zcrawling/LOONARover/GCS/docs/images/gcs-requirements-overview.png

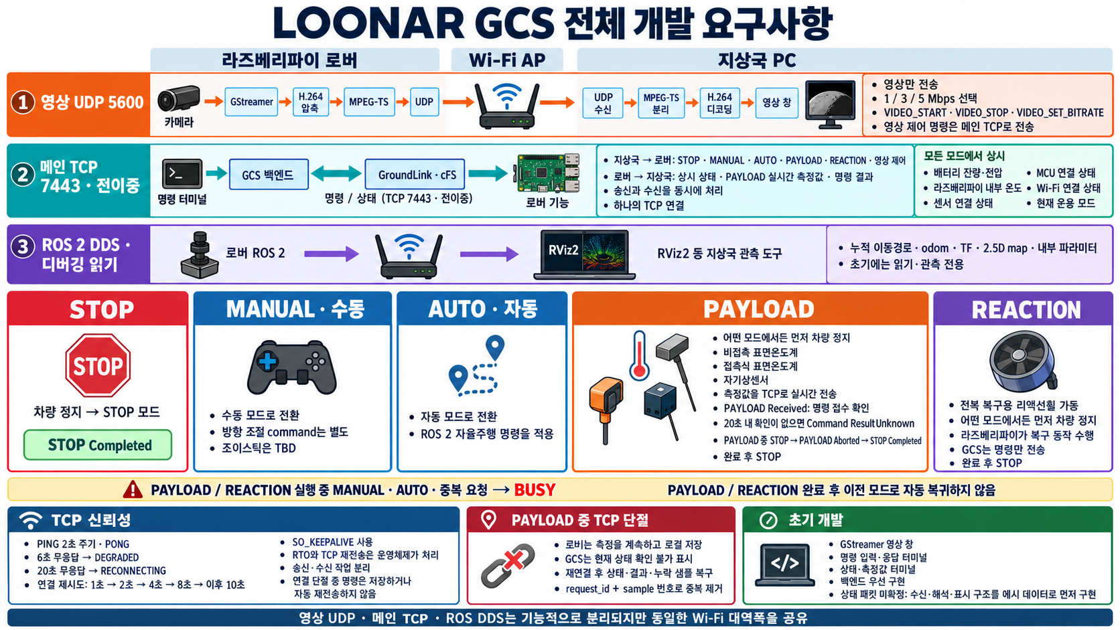
GCS/docs/images/gcs-requirements-overview.png
