zcrawling/LOONARover/GCS/docs/images/gcs-tcp-reliability.png

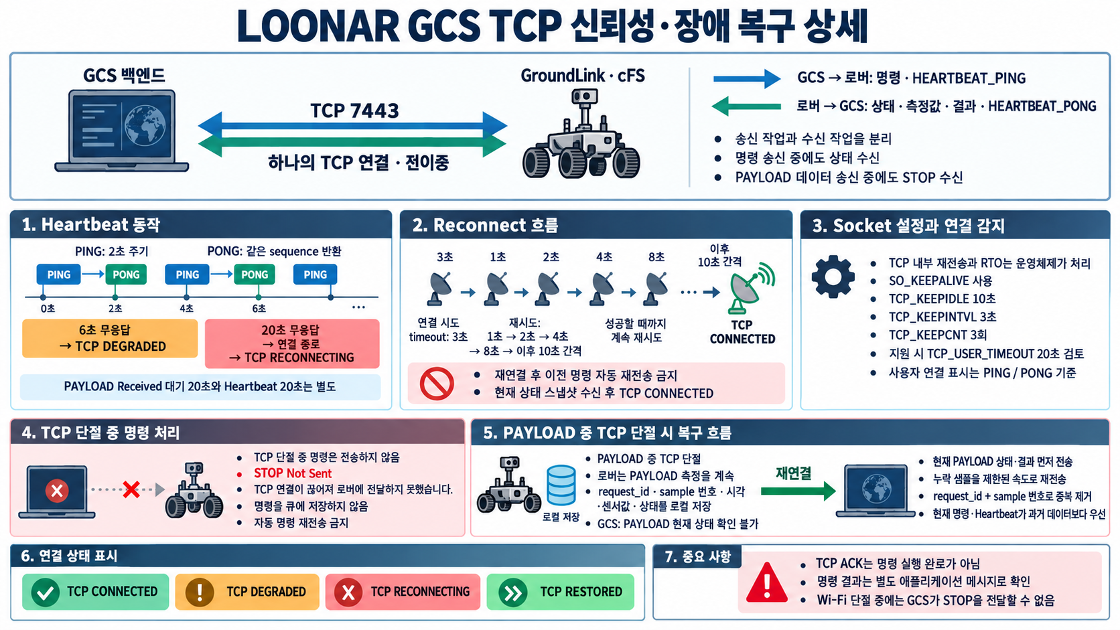
GCS/docs/images/gcs-tcp-reliability.png
