zcrawling/LOONARover/docs/README.md

# 문서

## 운용

- [지상국](../GCS/README.md) · [Xbox 입력](../GCS/docs/xbox-controller.md)
- [Pi 실행·기록](../platforms/loonar/porting/ground_control_runbook.md)
- [Pi 설치](../platforms/loonar/deploy/README.md)
- [Control 빌드·업로드](../platforms/loonar/firmware/control/README.md)
- [Payload START/STOP](../platforms/loonar/porting/payload_pca_runbook.md)
- [ToF 기록](../platforms/loonar/porting/tof_recording_runbook.md)
- [하드웨어](../platforms/loonar/hardware/hardware_baseline.md)

## 구현 계약

- [구조](architecture.md)
- [GroundLink](ground_link_protocol.md)
- [Gateway 소켓](vehicle_gatewayd_if.md)
- [Control MCU wire v2](../platforms/loonar/porting/mcu_wire_v2.md)
- [Payload USB·health](../platforms/loonar/porting/payload_protocol.md)
- [cFS 앱](../cfs/README.md)
- [장치 없는 통합 시험](../tools/gcs_test/README.md)

## 연구·실험

- [Odometry 설계](odometry-localization.md): 목표 설계이며 전체가 운용 구현된 것은 아니다.
- [LIMO](../platforms/limo/README.md): 해당 플랫폼의 실험과 구성.
- [AprilTag 거리 시험](../tools/apriltag_gt/README.md)
- [영상 객체 탐지](../GCS/docs/mission02-object-detection.md)

실측·PCB 제작 기록은 각 도구와 하드웨어 디렉터리에 보존한다.
