zcrawling/LOONARover/platforms/loonar/hardware/pcb/rbphat-xa-b4/manufacturing/drill-report.txt

Drill report for rbphat.kicad_pcb
Created on 2026-09-11T16:46:03

Copper Layer Stackup:
    =============================================================
    L1 :  F.Cu                      front
    L2 :  In1.Cu                    in1
    L3 :  In2.Cu                    in2
    L4 :  B.Cu                      back

Drill file 'rbphat-PTH.drl' contains
    plated through holes:
    =============================================================
    T1  0.300mm  0.0118"  (71 holes))
    T2  0.950mm  0.0374"  (14 holes))
    T3  1.020mm  0.0402"  (40 holes))
    T4  3.200mm  0.1260"  (1 hole)

    Total plated holes count 126

Drill file 'rbphat-NPTH.drl' contains
    unplated through holes:
    =============================================================
    T1  2.000mm  0.0787"  (3 holes)  (with 3 slots)
    T2  2.750mm  0.1083"  (4 holes))

    Total unplated holes count 7
