zcrawling/LOONARover/platforms/loonar/interfaces/generated/interface_catalog.md

# Generated Interface Constants

> Generated by `tools/gen_catalog.py`; edit the source catalogs instead.

## source_ids

| ID | Name | Description |
| ---: | --- | --- |
| `0x0001` | `AUTONOMY` | ROS 2 autonomous motion submitted to Vehicle Gateway |
| `0x0002` | `MANUAL` | Ground manual motion forwarded by cFS to Vehicle Gateway |
| `0x7FFE` | `TEST` | Explicit test motion source |

## reason_codes

| ID | Name | Description |
| ---: | --- | --- |
| `0x0000` | `NONE` | No error |
| `0x0101` | `STALE` | Timestamp or TTL is stale |
| `0x0104` | `TTL_INVALID` | TTL is zero or overflows |
| `0x0201` | `WRONG_MODE` | Command is not valid in the current mode |
| `0x0202` | `OLD_EPOCH` | Command authority epoch does not match |
| `0x0203` | `NO_AUTHORITY` | Required command authority is absent |
| `0x0204` | `DUPLICATE` | Command identity has already been applied |
| `0x0205` | `OUT_OF_ORDER` | Source sequence moved backward |
| `0x0206` | `INVALID_IDENTITY` | Reserved or missing command identity |
| `0x0301` | `ODOM_INVALID` | Odometry is invalid |
| `0x0302` | `NAV_FAILED` | Navigation failed |
| `0x0401` | `LINK_LOST` | MCU or transport link is lost |
| `0x0402` | `MCU_FAULT` | Local MCU hard fault |
| `0x0403` | `HEARTBEAT_LOST` | MPU heartbeat expired |
| `0x0501` | `SPEED_LIMITED` | Linear speed was limited |
| `0x0502` | `YAW_RATE_LIMITED` | Yaw rate was limited |
| `0xF001` | `BAD_SCHEMA` | Payload schema is invalid |
| `0xF002` | `BAD_FLAGS` | Reserved or conflicting flags are set |
| `0xF003` | `BAD_CRC` | CRC32C validation failed |
| `0xF004` | `NONFINITE` | A floating-point input is NaN or infinity |
| `0xF005` | `OUT_OF_RANGE` | A numeric input exceeds configured limits |
| `0xF006` | `UNKNOWN_MODE` | An enum or mode value is unknown |
| `0xFFFF` | `INTERNAL_ERROR` | Internal implementation error |

## wire_messages

| ID | Name | Description |
| ---: | --- | --- |
| `0x10` | `MPU_HEALTH` | MPU liveness packet |
| `0x20` | `MOTION_CMD` | Linear velocity and yaw-rate command |
| `0x80` | `MCU_STATUS` | Control MCU observable status |
