zcrawling/LOONARover/platforms/loonar/hardware/pcb/rbphat-xa-b4/history-b3/mechanical-review.pdf

# RBPHAT B2 - pre-layout mechanical constraints

### Pi 5 + official Active Cooler / 16 mm header body / 19 mm nominal board spacing

65.00 mm / corner radius 3.00 mm

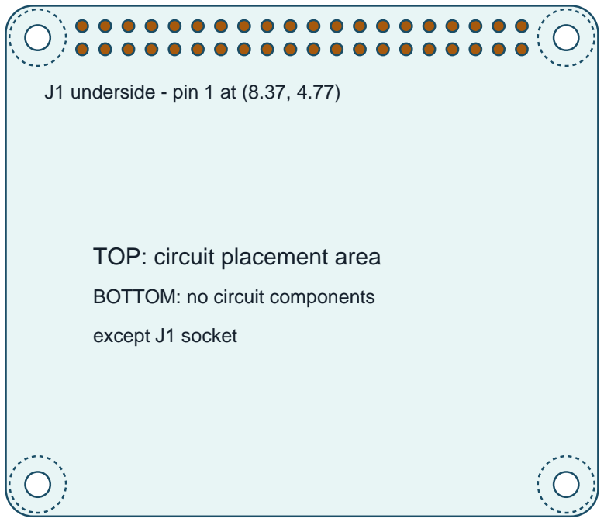
[picture p3: figure]
J1 underside - pin 1 at (8.37, 4.77); TOP: circuit placement area; BOTTOM: no circuit components; except J1 socket

4 x NPTH 2.75 mm, mounting centers 58 x 49 mm Screw clearance diameter 6.2 mm; no copper Datum: upper-left, X right, Y down. Dimensions in mm.

Pi PCB top = 0 mm

HAT underside = +19 mm

Active Cooler
13.7 mm reference height

All ICs / JST headers / C3 above HAT

Nominal insertion: 6.0 - (19 - 16 - 2.5) = 5.5 mm Header body H = 16 +/-0.25 mm; tail = 7.30 mm.
19 mm spacers are a design dimension; check seating and contact engagement during first assembly.

Cooler side envelope is illustrative. No case, cable-bend, or thermal certification is implied. Sources: Raspberry Pi HAT mechanical guide / HAT+ Ch.7 / Active Cooler drawing; 4UCON 07005.
