zcrawling/LOONARover/GCS/docs/xbox-controller.md

# Xbox Series USB 컨트롤러

지원 장치: Microsoft Xbox Series S|X Controller, USB **045e:0b12**.
Linux `xpad`/evdev를 사용하며 추가 pip 패키지는 필요 없다.
USB 이벤트 번호는 바뀔 수 있어 매번 VID/PID로 자동 탐색한다.
기존 웹 키보드 주행(Page Up/Home/Page Down/End/Space)은 그대로 사용한다.

## 실행

지상국 PC에서 컨트롤러를 연결하고:

```bash
cd /home/sb/LOONAR
./GCS/scripts/start_loonar_gcs.sh 192.168.0.14
```

GCS 실행 시 지원 장치를 읽을 수 있으면 별도 Xbox 터미널도 열린다.
이미 GCS가 실행 중이면 **백엔드 변경 적용을 위해 한 번 종료 후 재시작**한다.
나중에 연결했거나 직접 창을 열려면:

```bash
gnome-terminal -- /home/sb/LOONAR/GCS/scripts/start_controller.sh
```

컨트롤러 터미널에서 다른 창으로 전환했다가 돌아온 뒤, RT를 눌러 MANUAL을 선택한다.
터미널의 포커스 ON 표시를 확인한다. 최초 상태는 A/STOP이며 자동으로 주행하지 않는다.
포커스 이벤트를 보고하는 GNOME Terminal 등에서 사용한다. tmux/screen 내부는 지원하지 않는다.
포커스 보고를 지원하지 않는 터미널에서는 포커스 OFF 상태로 남아 조종할 수 없다.

로버 없이 이 PC의 실제 컨트롤러 입력과 표시만 확인:

```bash
gnome-terminal -- /home/sb/LOONAR/GCS/scripts/start_controller.sh --dry-run
```

이 모드는 네트워크/로버 명령을 전혀 보내지 않는다.
장치 정보만 확인하려면 `./GCS/scripts/start_controller.sh --inspect`.
여러 장치 연결 시 `--device /dev/input/eventN`으로 선택한다.
자동 창 열기는 `GCS_XBOX=0 ./GCS/scripts/start_loonar_gcs.sh 192.168.0.14`로 끌 수 있다.

## 조작

| 입력 | 동작 |
| --- | --- |
| LT | A ↔ B 전환, 누를 때마다 한 번 |
| RT | STOP ↔ MANUAL 전환, 누를 때마다 한 번 |
| A: 왼쪽 스틱 전후 | 직선 전진/후진, 좌우 축 무시 |
| A: 오른쪽 스틱 좌우 | 제자리 좌/우 회전, 전후 축 무시 |
| B: 왼쪽 스틱 | 전후 속도와 좌우 회전 속도를 동시에 전달 |
| B: 오른쪽 스틱 상하 | 좌우 바퀴 속도를 f Hz 사인파로 변조, 오른쪽 좌우 축 무시 |
| LB / RB | 변조 계수 k를 0.1 감소 / 증가 (0~1, 실행 시 0.5), 누를 때마다 한 번 |
| X / Y | 오른쪽 바퀴 위상차 c를 10° 감소 / 증가 (0~360°, 실행 시 180°), 누를 때마다 한 번 |
| A / B 버튼 | 주파수 f를 0.1Hz 감소 / 증가 (0~2Hz, 실행 시 1Hz), 누를 때마다 한 번 |
| 기타 컨트롤러 버튼 | 사용하지 않음 |
| Q / Ctrl+C | 조종 중이면 STOP 전송 후 종료 |

A에서 두 스틱을 동시에 기울이면 **오른쪽 제자리 회전 우선**으로 선속도를 0으로 한다.
B에서 오른쪽 스틱 상하가 중앙이면 기존 왼쪽 스틱 주행을 사용한다.
왼쪽 전후 스틱도 중앙이면 조향도 0으로 하여 제자리 회전을 하지 않는다.
B의 좌우 입력은 전진/후진 모두 같은 각속도 부호를 사용한다(왼쪽 = 양의 yaw).
개별 바퀴 속도 변환은 기존 로버 backend/MCU가 수행한다.

### B 모드 오른쪽 스틱 변조

오른쪽 상하 입력이 데드존을 벗어나면 왼쪽 스틱보다 우선한다.
위쪽은 전진, 아래쪽은 후진이며, 기존 감도로 변환한 속도를 `x` (m/s)로 사용한다.
`t`는 오른쪽 스틱 주행 시작부터의 초 단위 경과 시간이다.

```text
left  = x + k*x*sin(2*pi*f*t)
right = x + k*x*sin(2*pi*f*t + c*pi/180)
```

`c`는 도 단위이며 계산할 때 라디안으로 변환한다. 기본값 180°는 기존의
좌우 반대 변조와 같고, 0°와 360°는 좌우가 같은 속도로 함께 변조된다.
X/Y로 c를 바꾸거나 A/B 버튼으로 f를 바꿔도 t는 초기화하지 않는다.
변경한 f를 현재 경과 시간에 바로 적용하므로 조절 순간 속도가 달라질 수 있다.

f가 양수일 때 주기는 1/f초이며 스틱을 고정해도 전송 루프에서 속도가 계속 바뀐다.
f=0이면 시간 변조가 없어져 왼쪽은 x, 오른쪽은 x+k*x*sin(c*pi/180)으로 고정된다.
기본 c=180°에서는 양쪽 모두 x가 된다. A/B 버튼은 주행모드 전환용 LT와 별개다.
좌우 중 절댓값이 0.4m/s를 넘으면 두 속도를 같은 비율로 줄인다.
예: x=0.4, k=0.5, c=180°, f=1Hz, t=0.25초의 계산값 0.6/0.2는 0.4/0.1333m/s로 전송된다.
Pi에는 기존 API의 `v=(left+right)/2`, `w=(right-left)/0.21`로 전달한다.

오른쪽 스틱을 중앙으로 놓거나 STOP, A/B 전환, 포커스 이탈 후 다시 시작하면
위상은 t=0부터 시작한다. LB/RB, X/Y, A/B 버튼은 포커스가 있을 때만 반영하며 길게 눌러도
한 번만 조절한다. k, c, f는 모드·STOP 전환 중 유지되고 프로그램 재실행 시
각각 0.5, 180°, 1Hz로 돌아온다.

중앙 ±8%는 0이며, 그 밖은 기울기에 따라 선속도 0.01~0.40 m/s, 각속도 0.01~3.80 rad/s로 선형 변환한다.
선속도 단위는 m/s, 각속도 단위는 rad/s이다. 전후·좌우 방향에 따라 부호가 바뀐다.
`--deadzone 0.10`처럼 중앙 무입력 범위를 조정할 수 있다.
LT/RT는 65% 이상에서 눌림, 25% 이하에서 해제로 판정하여 누르고 있는 동안 반복 전환하지 않는다.
MANUAL 상태에서는 약 10Hz로 현재 속도를 전송하고 스틱을 놓으면 MANUAL(0,0)을 전송한다.

## 화면과 포커스

화면 상단에 **A/B, 조종기의 STOP/MANUAL 선택, k, c, f, 포커스, 로버가 보고한 상태**를 계속 표시한다.
A/B는 조이스틱 매핑이며 로버 AUTO 모드와는 관계없다.
전송 성공은 로컬 backend가 명령을 보냈다는 뜻이며 실제 로버 상태는 별도로 표시한다.

조종 중 포커스를 잃으면 STOP을 한 번 보내고 조종기를 STOP 상태로 전환한다.
그 이후 포커스가 없는 동안에는 명령을 보내지 않아 기존 웹 키보드 주행을 사용할 수 있다.
돌아와도 자동으로 재주행하지 않으며 RT를 다시 눌러야 한다.
컨트롤러 분리/이벤트 유실/프로그램 종료 시에도 활성 상태라면 STOP을 시도한다.
통신 자체가 끊어지면 STOP 전달은 보장되지 않으며 실패 메시지를 출력한다.

컨트롤러는 GCS의 로컬 Unix API를 사용한다. 웹 키보드와 동일한 backend TCP 연결 및
시퀀스 번호를 공유하며, 컨트롤러가 로버 7443 포트에 두 번째 연결을 만들지 않는다.
별도 구형 `cli.keyboard_control` 직접 TCP 조종기는 동시에 실행하지 않는다.
로버나 MCU 배포 변경은 필요 없다.

## 검증

```bash
cd /home/sb/LOONAR/GCS
python3 -B -m unittest tests.test_xbox_control tests.test_xbox_terminal tests.test_xbox_backend tests.test_keyboard_control tests.test_real_backend -v
```

축/트리거 매핑, 포커스 상실·복귀, 장치 분리 시 STOP, 드라이런, 기존 키보드 회귀,
로컬 Unix API → 하나의 GroundLink TCP 연결로 복합 속도 전송을 검증한다.
실제 로버의 바퀴 주행은 자동 테스트에 포함하지 않는다.

구현 근거: [Linux 입력 이벤트](https://docs.kernel.org/input/event-codes.html),
[xterm 포커스 보고](https://invisible-island.net/xterm/ctlseqs/ctlseqs.html).

### 속도 상한과 혼합 입력

윤거 0.21 m, 바퀴 선속도 상한 0.4 m/s 기준 제자리 회전 상한은
2 × 0.4 / 0.21 = 3.8095 rad/s이며 UI와 명령 상한은 3.80 rad/s다.
실제 동체 회전속도는 미끄러짐에 따라 달라질 수 있다.
유효한 범위 초과 입력은 거부하지 않고 ±0.4 m/s, ±3.8 rad/s로 제한한다.
B 모드 혼합 입력은 좌우 바퀴 속도의 큰 쪽이 0.4 m/s를 넘으면
선속도와 각속도를 같은 비율로 줄인다. Pi는 레지스트리의 실제 윤거를 사용해 동일하게 제한한다.

## 외부 AprilTag GT와 Pi 전체 bag을 함께 기록

```bash
bash GCS/scripts/start_controller.sh --record-session --ip 10.254.254.3
```

이 옵션은 [수동 주행 세션 실행기](../../tools/apriltag_gt/README.md)로 연결한다.
Pi의 기존 `--record-all`, 외부 카메라 원본·트래킹·궤적 창, 프레임별 Pi 시각 매핑과
Xbox 명령 로그를 한 세션에 저장한다. 준비 후 기존 RT로 MANUAL을 선택한다.
C 추정기/자동 주행을 시작하지 않는다. Pi 전체 센서 스택이 이미 실행 중이면
`--existing-stack`을 추가한다. 기존 `start_controller.sh` 단독 동작은 동일하다.
