zcrawling/LOONARover/GCS/docs/images/gcs-mode-command-flow.png

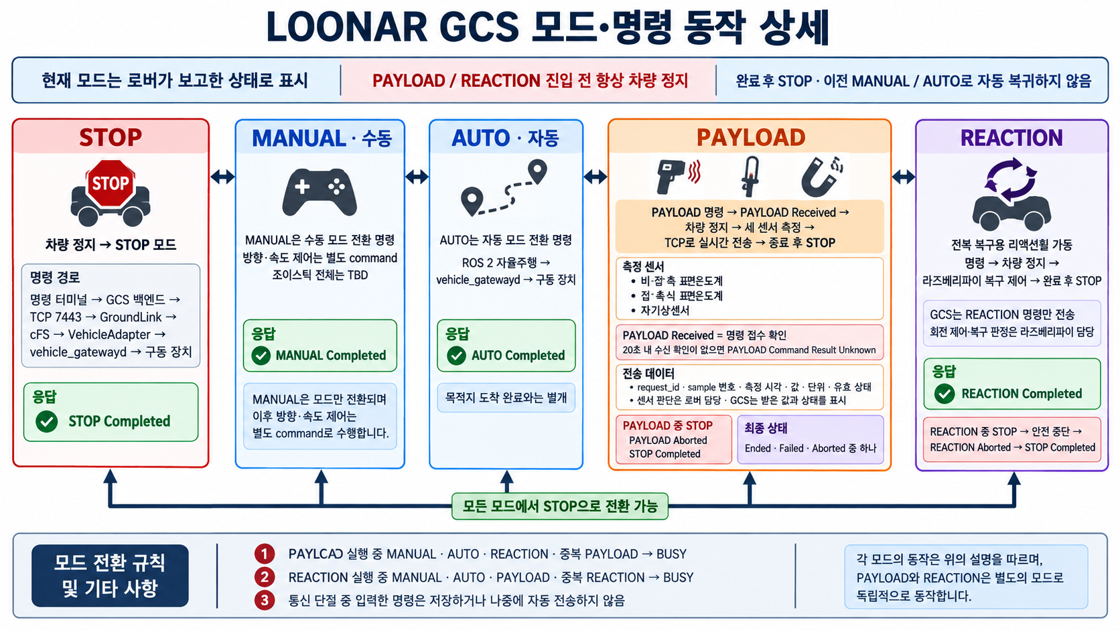
GCS/docs/images/gcs-mode-command-flow.png
