zcrawling/LOONARover/GCS/outputs/requirements-20260903/decisions-preview.png

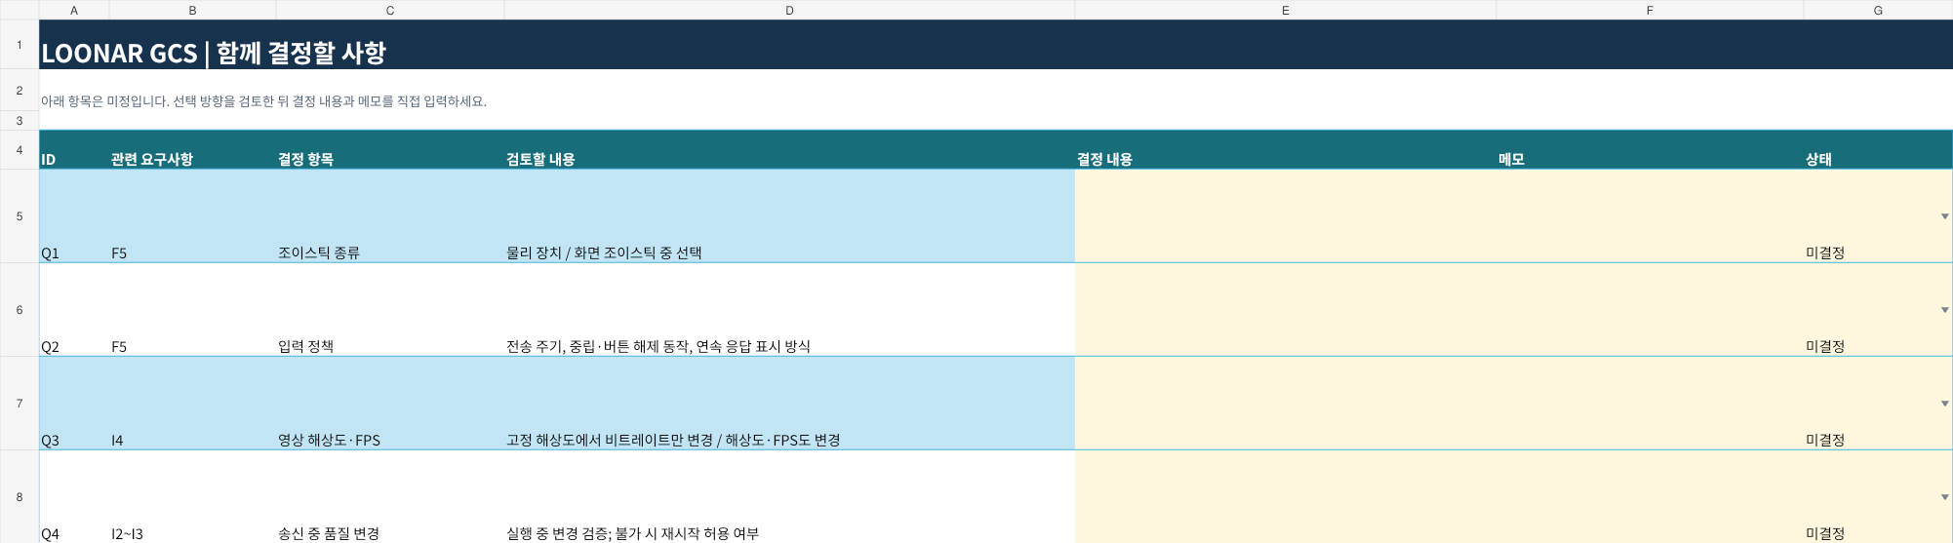
GCS/outputs/requirements-20260903/decisions-preview.png
