zcrawling/LOONARover/GCS/outputs/requirements-20260903/milestones-preview.png

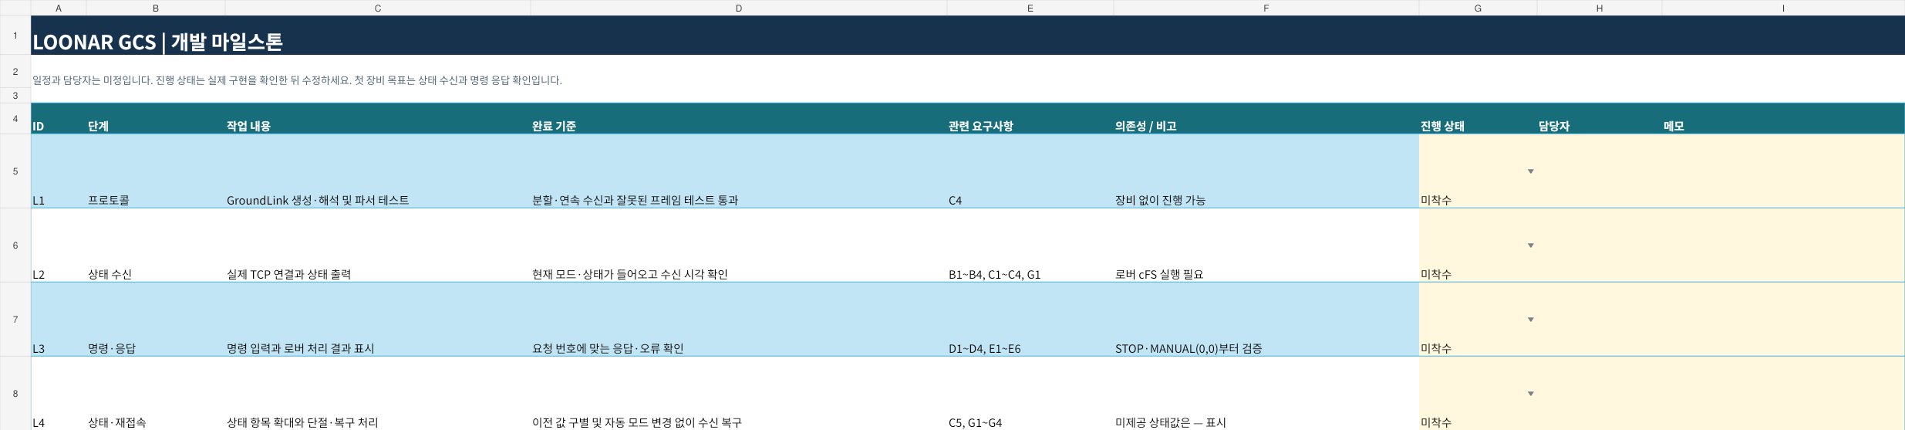
GCS/outputs/requirements-20260903/milestones-preview.png
