zcrawling/LOONARover/GCS/outputs/requirements-20260903/requirements-preview.png

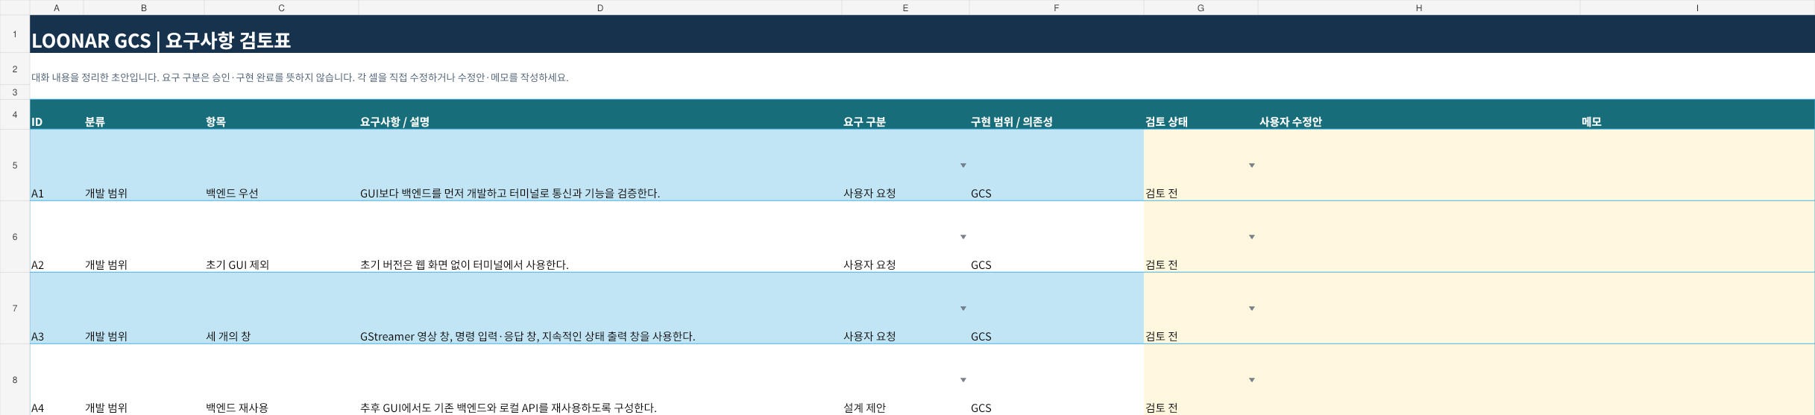
GCS/outputs/requirements-20260903/requirements-preview.png
