zcrawling/LOONARover/output/compass/relative-border-preview.png

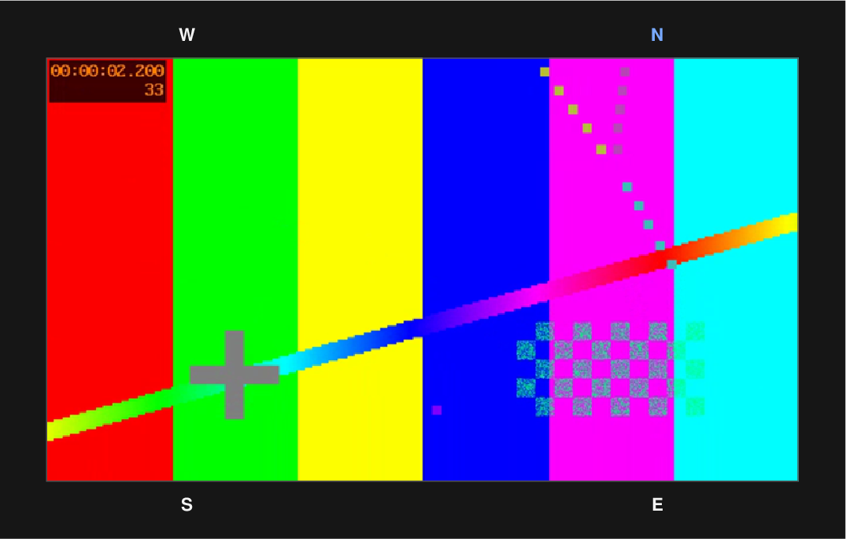
output/compass/relative-border-preview.png
