zcrawling/LOONARover/output/playwright/angular-slider.png

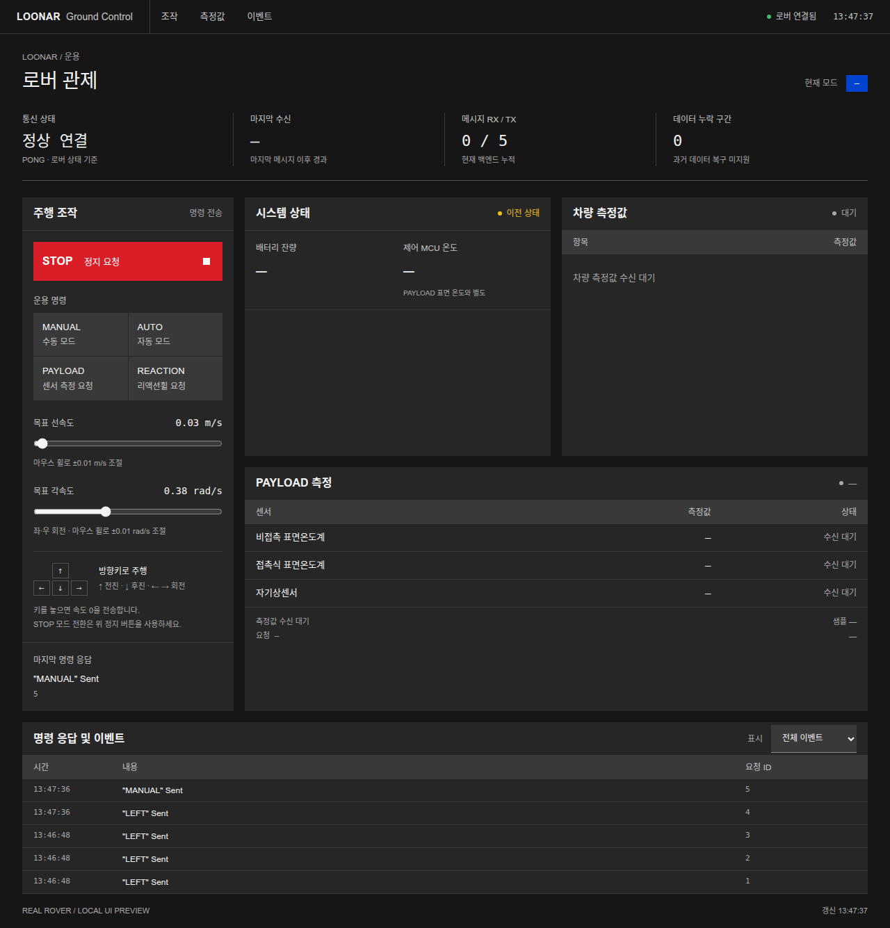
output/playwright/angular-slider.png
