zcrawling/LOONARover/platforms/loonar/hardware/pcb/rbphat-xa-b4/artwork/schematic-review.png

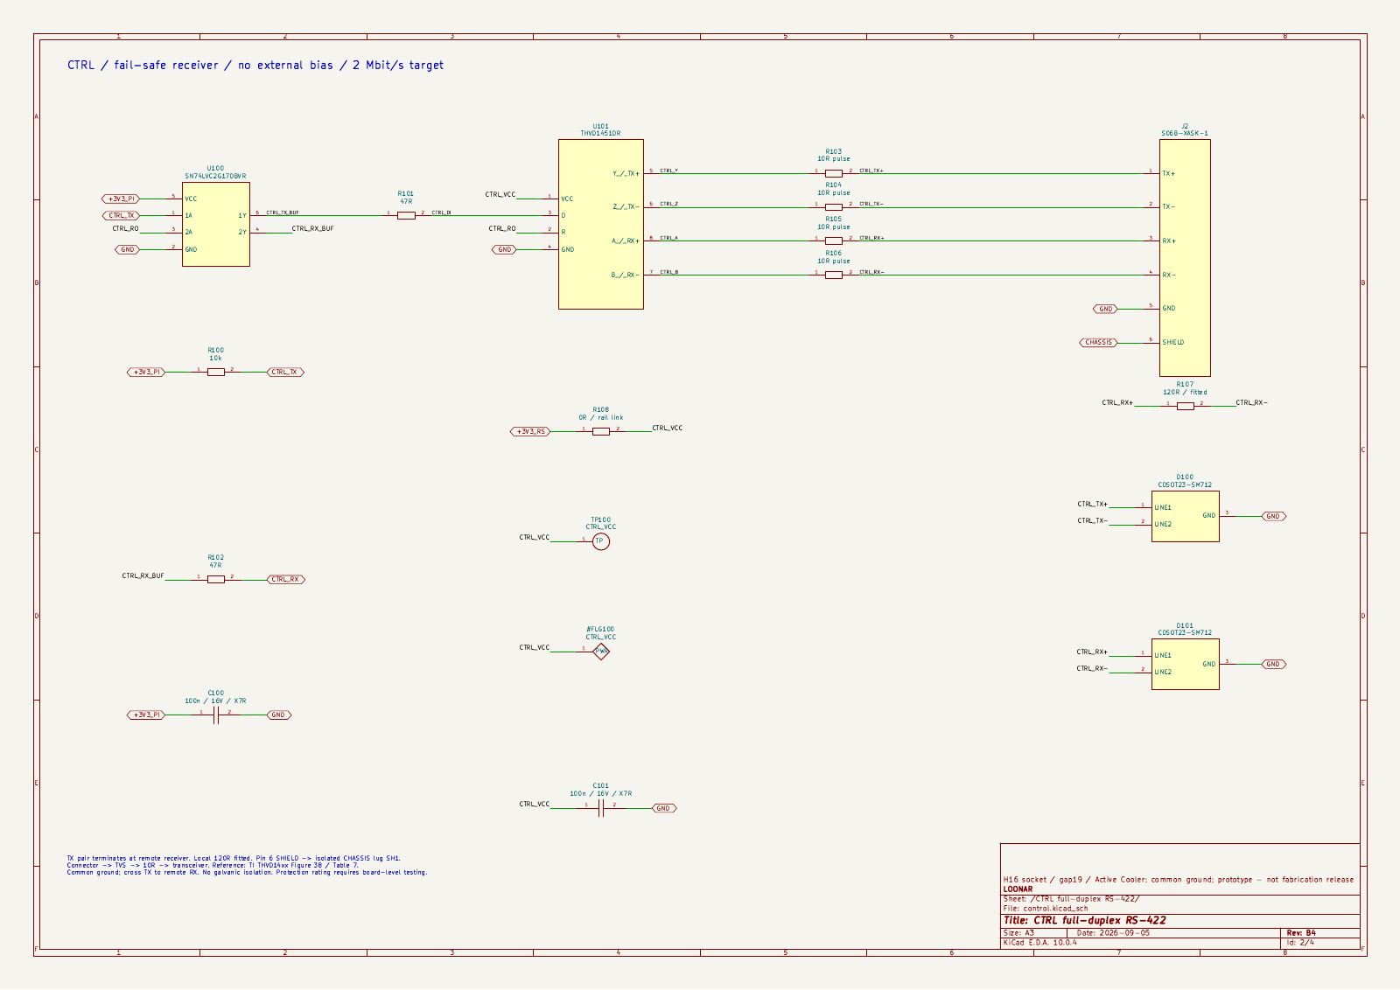
platforms/loonar/hardware/pcb/rbphat-xa-b4/artwork/schematic-review.png
