zcrawling/LOONARover/platforms/loonar/hardware/pcb/rbphat-xa-b4/artwork/top-3d.png

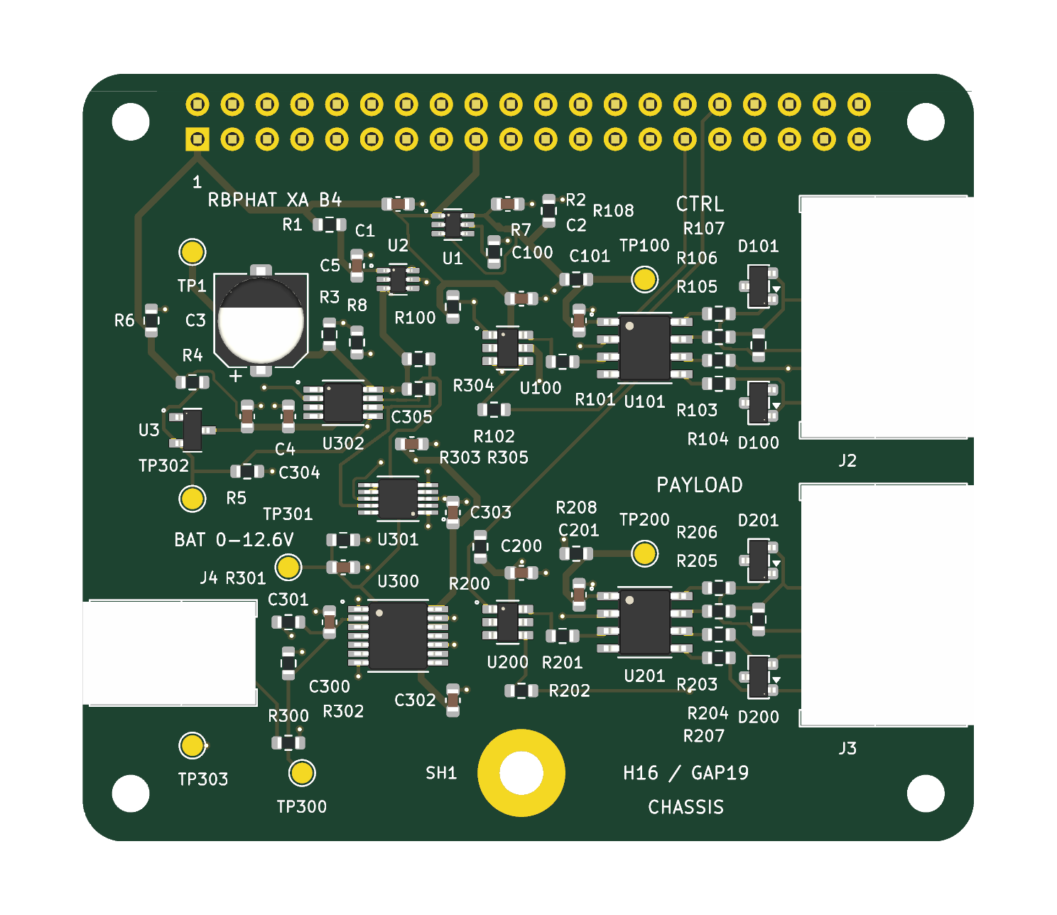
platforms/loonar/hardware/pcb/rbphat-xa-b4/artwork/top-3d.png
