zcrawling/LOONARover/platforms/loonar/ros2/terrain_navigation/fly_brain/analysis/20261007/sensor_contact_sheet.png

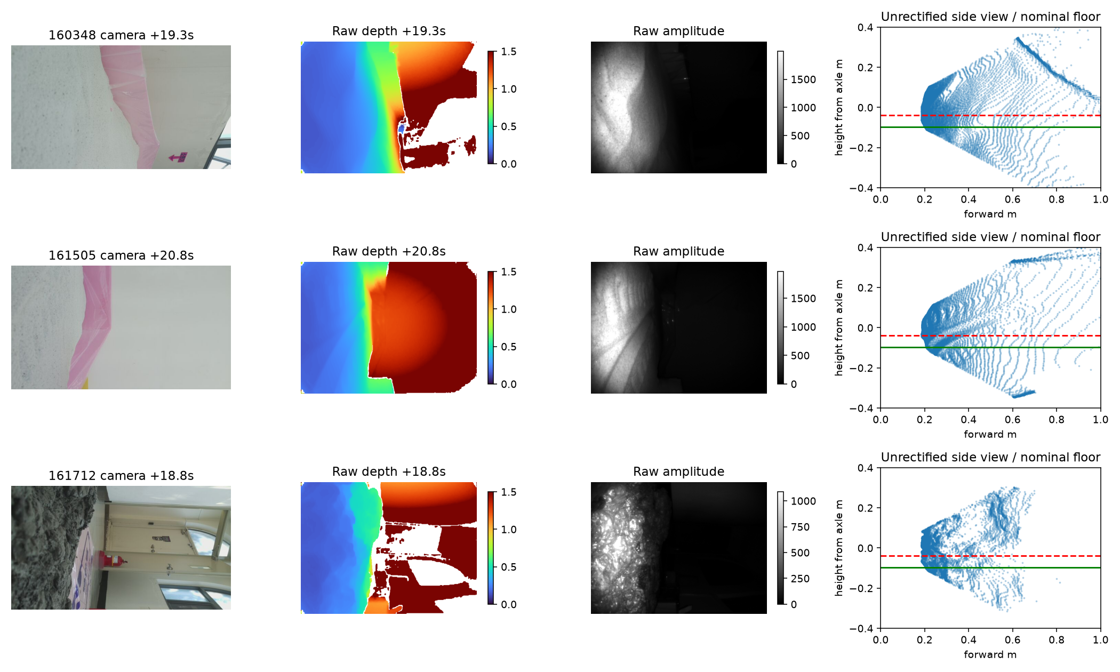
platforms/loonar/ros2/terrain_navigation/fly_brain/analysis/20261007/sensor_contact_sheet.png
