zcrawling/LOONARover/platforms/loonar/hardware/pcb/rbphat-xa-b4/manufacturing/assembly/harness-bom.csv

Item | MPN | Quantity | Notes
J2/J3 mating housing | XAP-06V-1 | 2 | 6 positions
J4 mating housing | XAP-02V-1 | 1 | 2 positions
Crimp contact | SXA-001T-P0.6 | 14 | AWG28-22; insulation OD 0.8-1.9 mm; order spares
SH1 chassis bond | M3 ring terminal and hardware | 1 | Choose terminal for chassis wire gauge; washer OD <=8 mm; see fabrication notes
