zcrawling/LOONARover/platforms/limo/ros2/loonar_limo_sim/models/loonar_arena/meshes/arena_terrain_v04_resend_02.stl

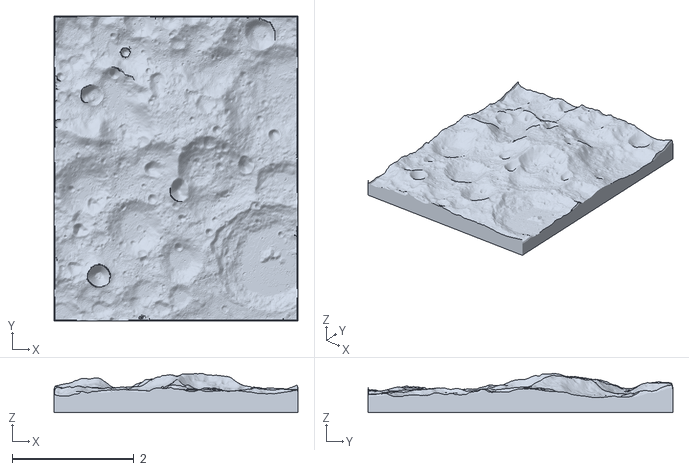
[picture p13: CAD file, 2026-09-06]
platforms/limo/ros2/loonar_limo_sim/models/loonar_arena/meshes/arena_terrain_v04_resend_02.stl
4.00 x 5.00 x 0.64
