zcrawling/LOONARover/platforms/loonar/hardware/pcb/rbphat-xa-b4/models/Connector_JST.3dshapes_JST_GH_BM05B-GHS-TBT_1x05-1MP_P1.25mm_Vertical.step

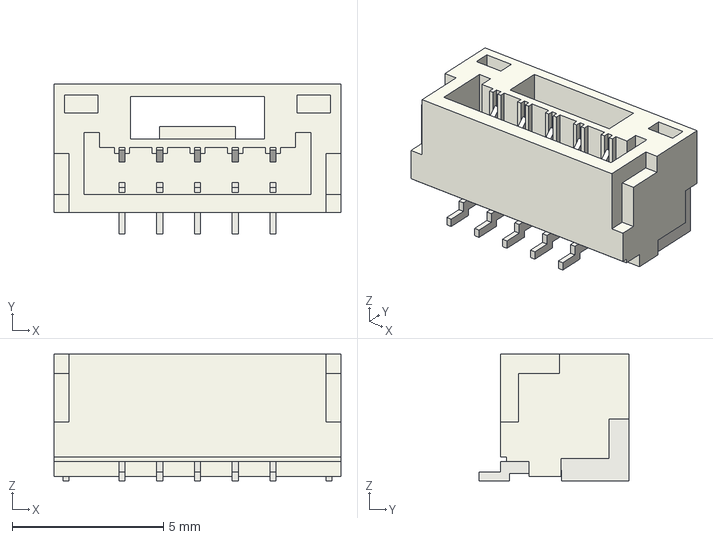
[picture p14: CAD file, 2026-09-06]
platforms/loonar/hardware/pcb/rbphat-xa-b4/models/Connector_JST.3dshapes_JST_GH_BM05B-GHS-TBT_1x05-1MP_P1.25mm_Vertical.step
9.50 x 4.95 x 4.20 mm
