zcrawling/LOONARover/platforms/loonar/hardware/pcb/rbphat-xa-b4/models/Package_SO.3dshapes_VSSOP-8_3x3mm_P0.65mm.step

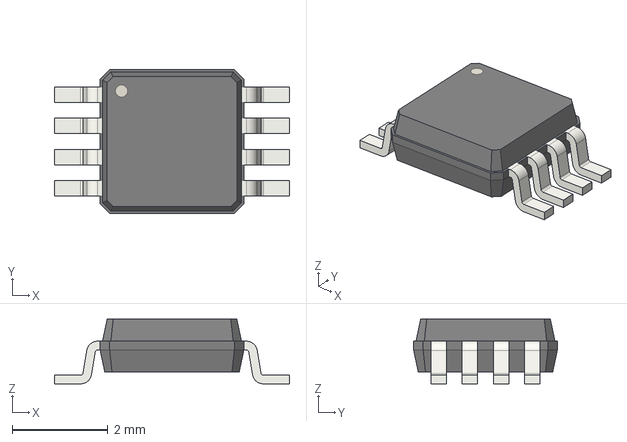
[picture p15: CAD file, 2026-09-06]
platforms/loonar/hardware/pcb/rbphat-xa-b4/models/Package_SO.3dshapes_VSSOP-8_3x3mm_P0.65mm.step
4.90 x 3.00 x 1.35 mm
