zcrawling/LOONARover/platforms/loonar/hardware/pcb/rbphat-xa-b4/models/Package_SO.3dshapes_SOIC-8_3.9x4.9mm_P1.27mm.step

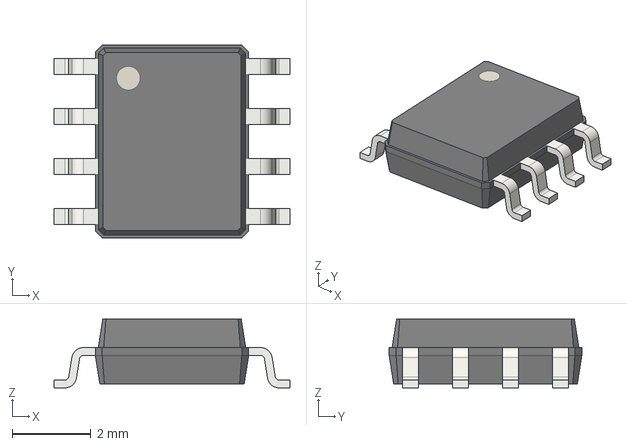
[picture p16: CAD file, 2026-09-06]
platforms/loonar/hardware/pcb/rbphat-xa-b4/models/Package_SO.3dshapes_SOIC-8_3.9x4.9mm_P1.27mm.step
6.00 x 4.90 x 1.75 mm
