zcrawling/LOONARover/platforms/loonar/hardware/pcb/rbphat-xa-b4/models/Capacitor_SMD.3dshapes_C_0603_1608Metric.step

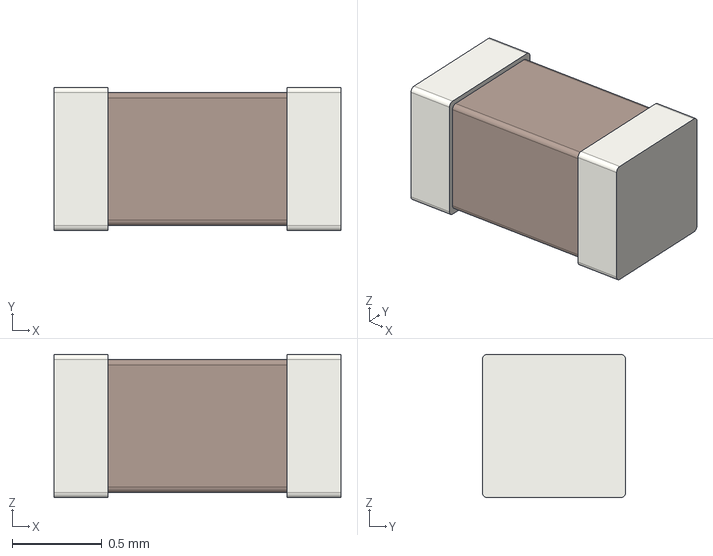
[picture p17: CAD file, 2026-09-06]
platforms/loonar/hardware/pcb/rbphat-xa-b4/models/Capacitor_SMD.3dshapes_C_0603_1608Metric.step
1.60 x 0.8 x 0.8 mm
