zcrawling/LOONARover/platforms/loonar/hardware/pcb/rbphat-xa-b4/models/Package_TO_SOT_SMD.3dshapes_SOT-23-6.step

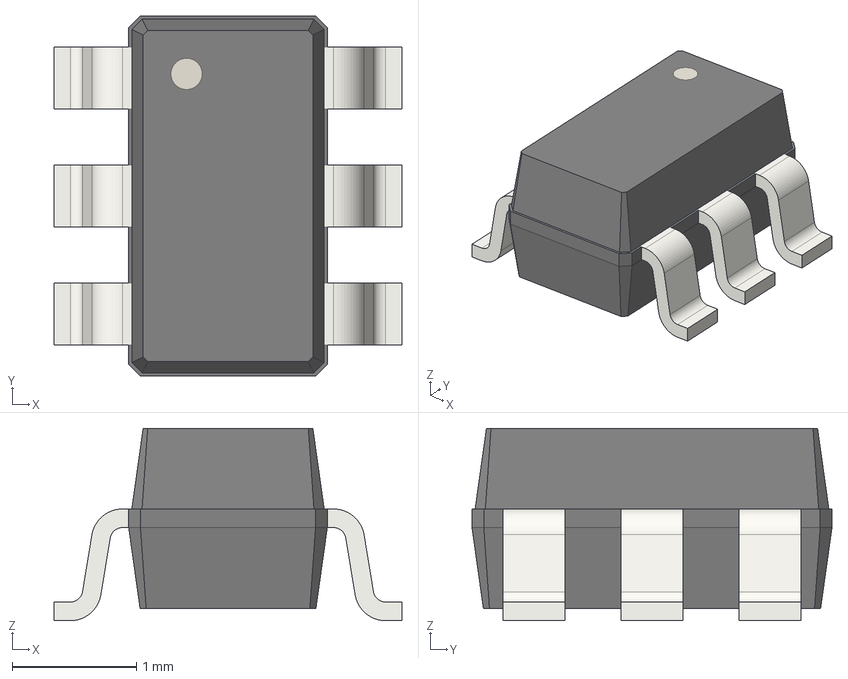
[picture p18: CAD file, 2026-09-06]
platforms/loonar/hardware/pcb/rbphat-xa-b4/models/Package_TO_SOT_SMD.3dshapes_SOT-23-6.step
2.80 x 2.90 x 1.55 mm
