zcrawling/LOONARover/platforms/loonar/hardware/pcb/rbphat-xa-b4/models/Package_TO_SOT_SMD.3dshapes_SOT-363_SC-70-6.step

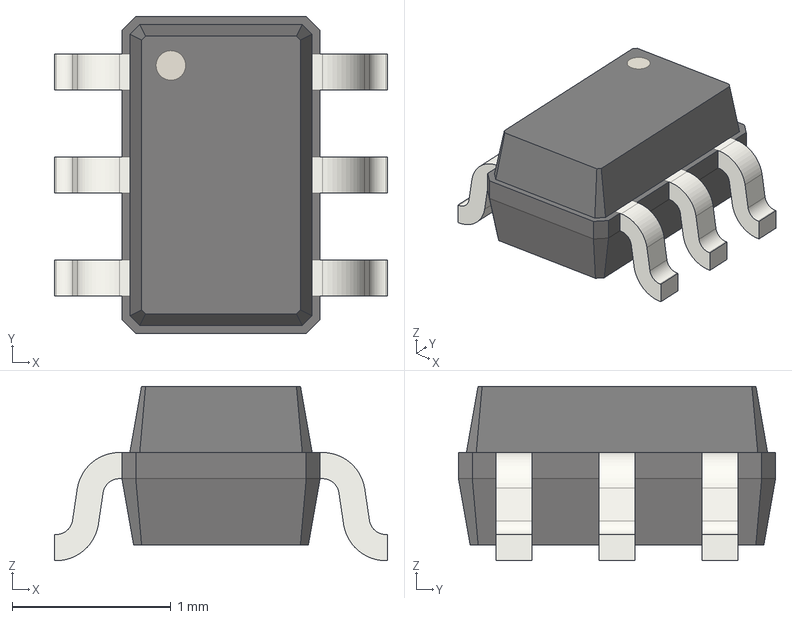
[picture p20: CAD file, 2026-09-06]
platforms/loonar/hardware/pcb/rbphat-xa-b4/models/Package_TO_SOT_SMD.3dshapes_SOT-363_SC-70-6.step
2.10 x 2.00 x 1.10 mm
