zcrawling/LOONARover/platforms/loonar/hardware/pcb/rbphat-xa-b4/models/Package_SO.3dshapes_TSSOP-14_4.4x5mm_P0.65mm.step

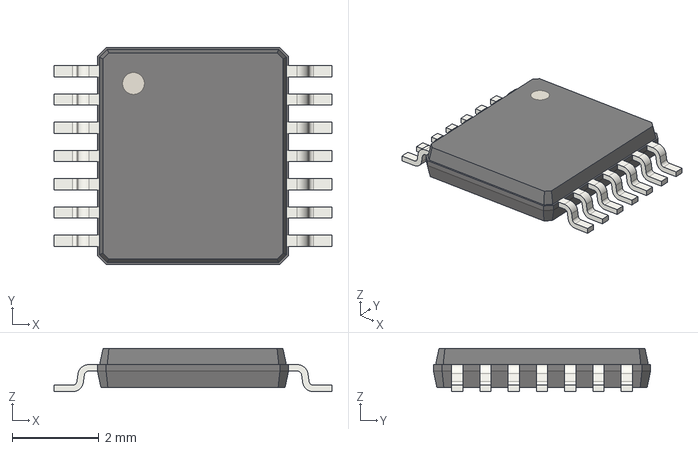
[picture p22: CAD file, 2026-09-06]
platforms/loonar/hardware/pcb/rbphat-xa-b4/models/Package_SO.3dshapes_TSSOP-14_4.4x5mm_P0.65mm.step
6.40 x 5.00 x 1.00 mm
