zcrawling/LOONARover/platforms/loonar/hardware/pcb/rbphat-xa-b4/models/Package_TO_SOT_SMD.3dshapes_SOT-23.step

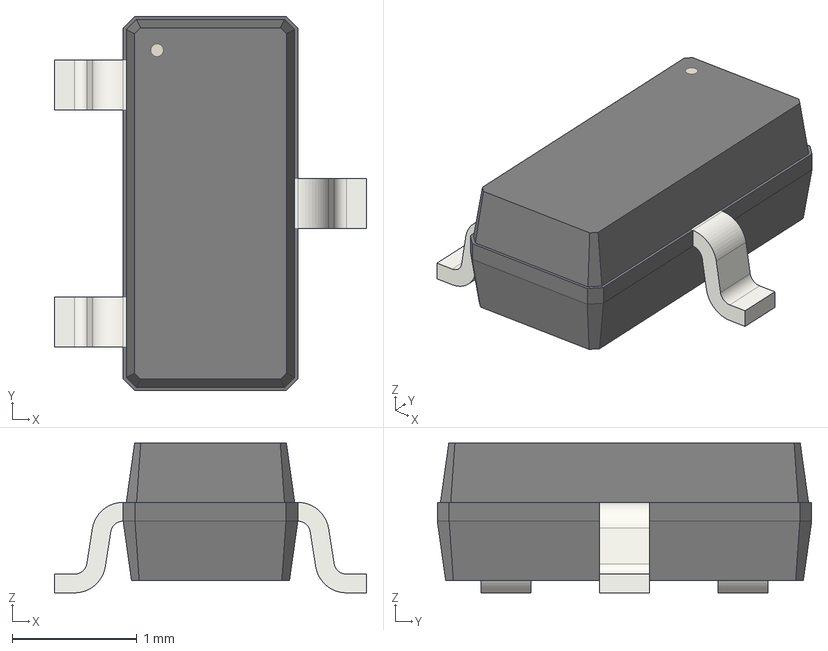
[picture p23: CAD file, 2026-09-06]
platforms/loonar/hardware/pcb/rbphat-xa-b4/models/Package_TO_SOT_SMD.3dshapes_SOT-23.step
2.50 x 3.00 x 1.20 mm
