zcrawling/LOONARover/platforms/loonar/hardware/pcb/rbphat-xa-b4/models/Capacitor_SMD.3dshapes_CP_Elec_6.3x5.8.step

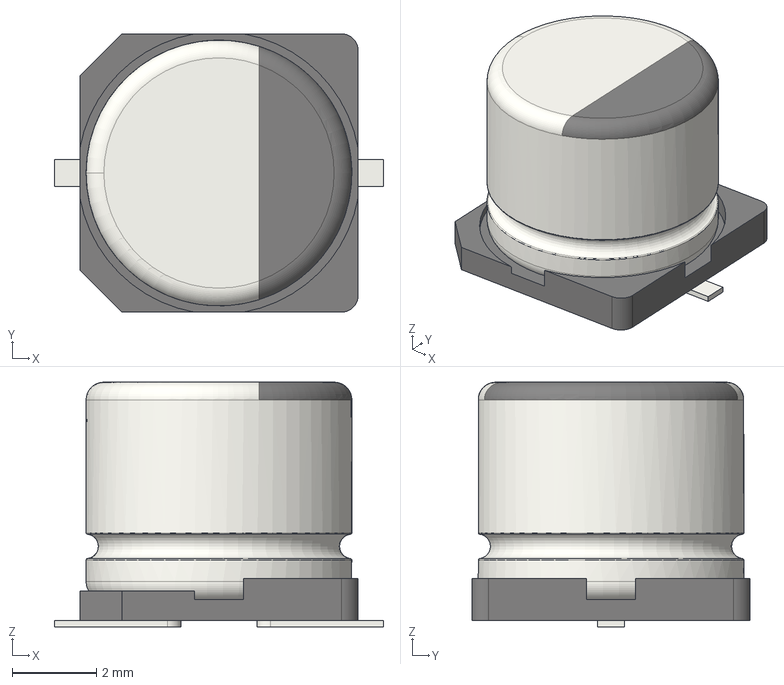
[picture p24: CAD file, 2026-09-06]
platforms/loonar/hardware/pcb/rbphat-xa-b4/models/Capacitor_SMD.3dshapes_CP_Elec_6.3x5.8.step
7.80 x 6.60 x 5.80 mm
