zcrawling/LOONARover/platforms/loonar/hardware/pcb/rbphat-xa-b4/models/Package_SO.3dshapes_MSOP-10_3x3mm_P0.5mm.step

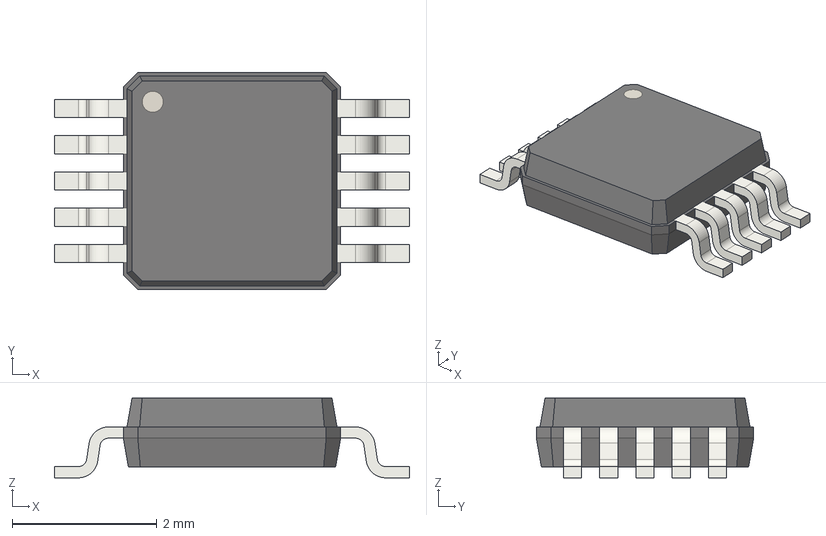
[picture p25: CAD file, 2026-09-06]
platforms/loonar/hardware/pcb/rbphat-xa-b4/models/Package_SO.3dshapes_MSOP-10_3x3mm_P0.5mm.step
4.90 x 3.00 x 1.10 mm
