zcrawling/LOONARover/platforms/loonar/hardware/pcb/rbphat-rebuild/artwork/bottom-3d.png

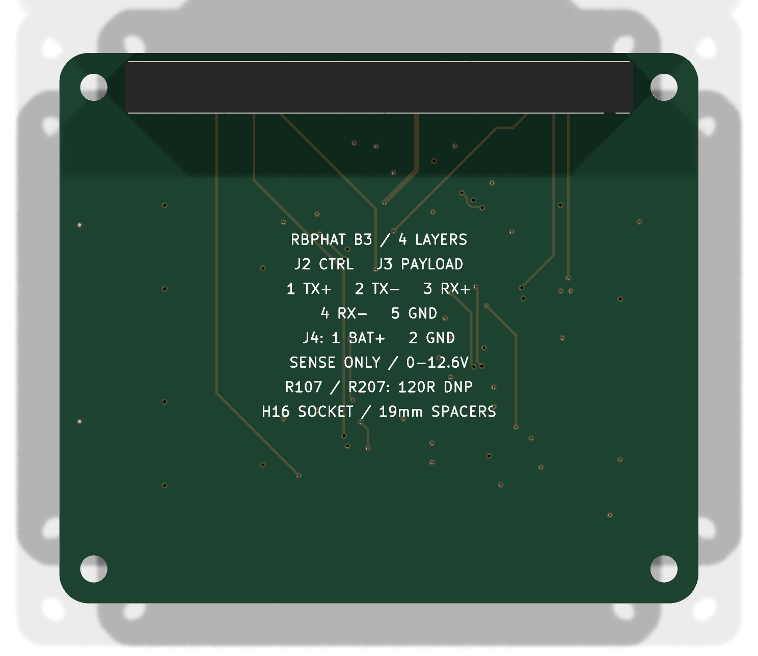
platforms/loonar/hardware/pcb/rbphat-rebuild/artwork/bottom-3d.png
