zcrawling/LOONARover/platforms/loonar/hardware/pcb/rbphat-rebuild/artwork/bottom-routing.png

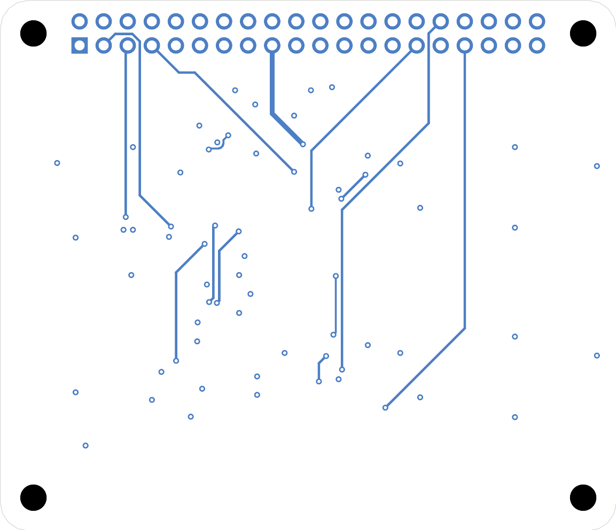
platforms/loonar/hardware/pcb/rbphat-rebuild/artwork/bottom-routing.png
