zcrawling/LOONARover/platforms/loonar/hardware/pcb/rbphat-rebuild/artwork/placement-top.png

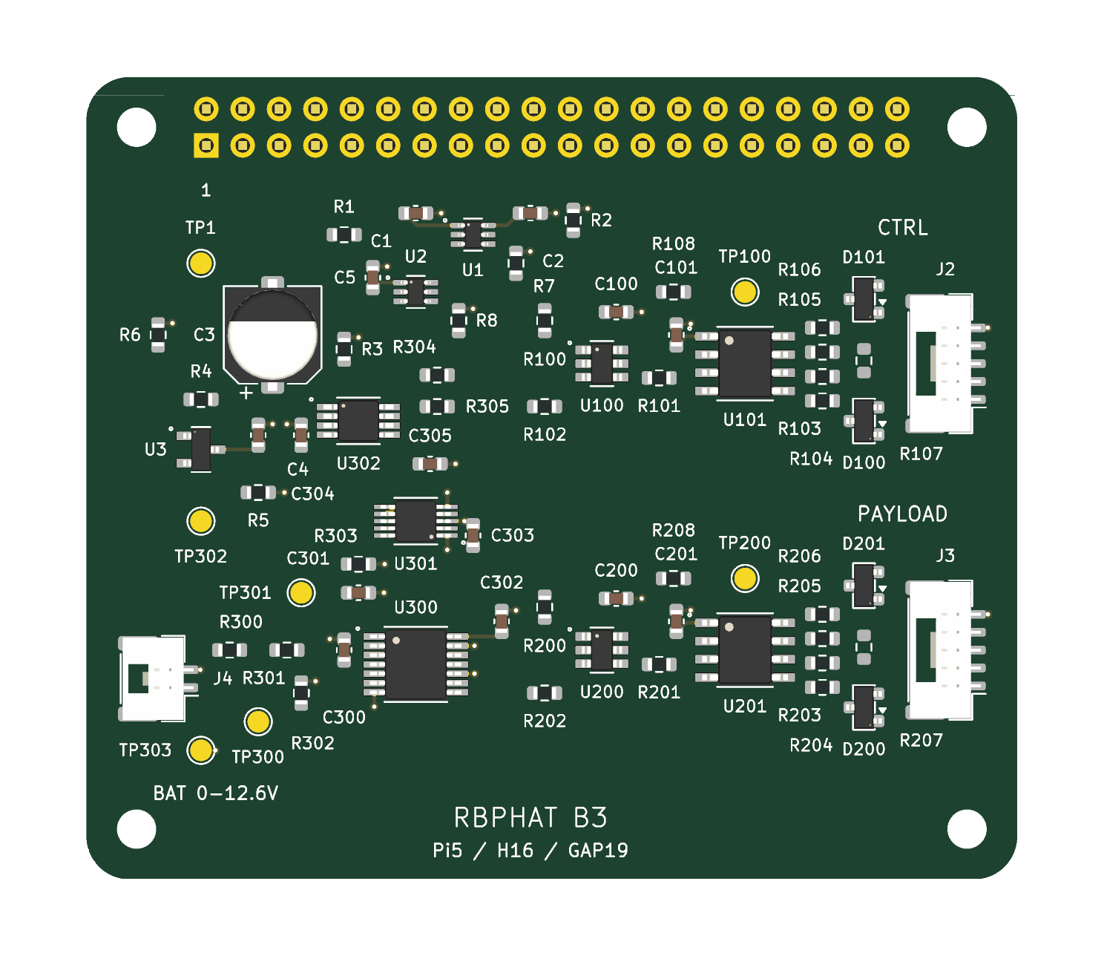
platforms/loonar/hardware/pcb/rbphat-rebuild/artwork/placement-top.png
