zcrawling/LOONARover/platforms/loonar/hardware/pcb/rbphat-rebuild/artwork/top-3d.png

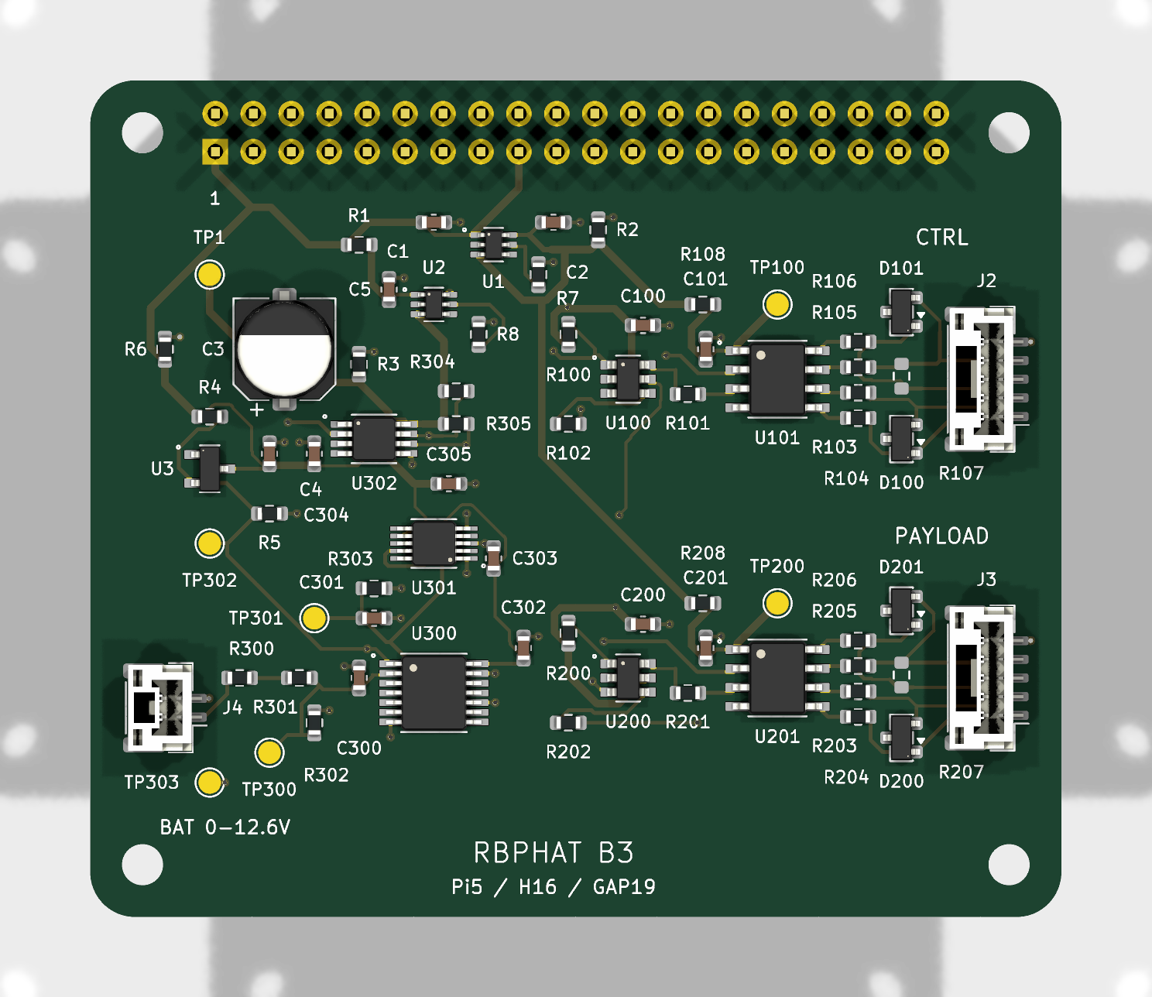
platforms/loonar/hardware/pcb/rbphat-rebuild/artwork/top-3d.png
