zcrawling/LOONARover/platforms/loonar/hardware/pcb/rbphat-rebuild/artwork/top-routing.png

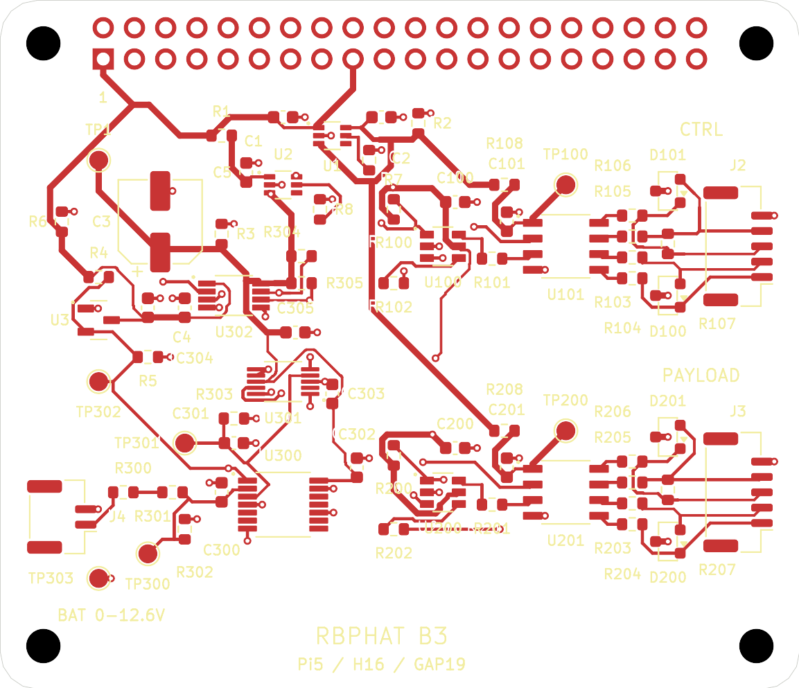
platforms/loonar/hardware/pcb/rbphat-rebuild/artwork/top-routing.png
