zcrawling/LOONARover/platforms/loonar/hardware/pcb/rbphat-xa-b4/artwork/assembly-review.png

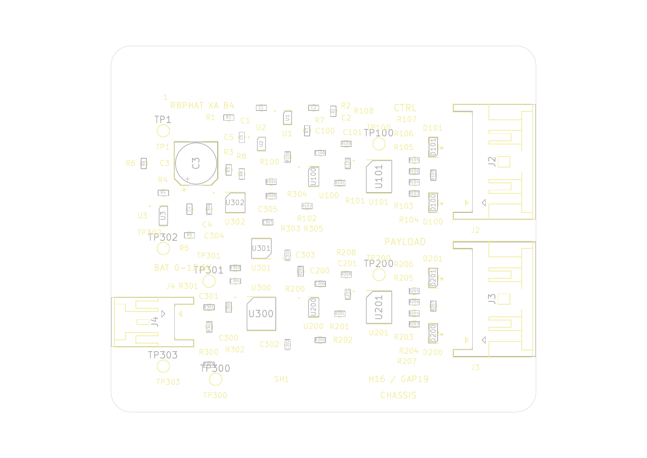
platforms/loonar/hardware/pcb/rbphat-xa-b4/artwork/assembly-review.png
