zcrawling/LOONARover/tools/apriltag_gt/prints/tag36h11_id0_120mm_A4.png

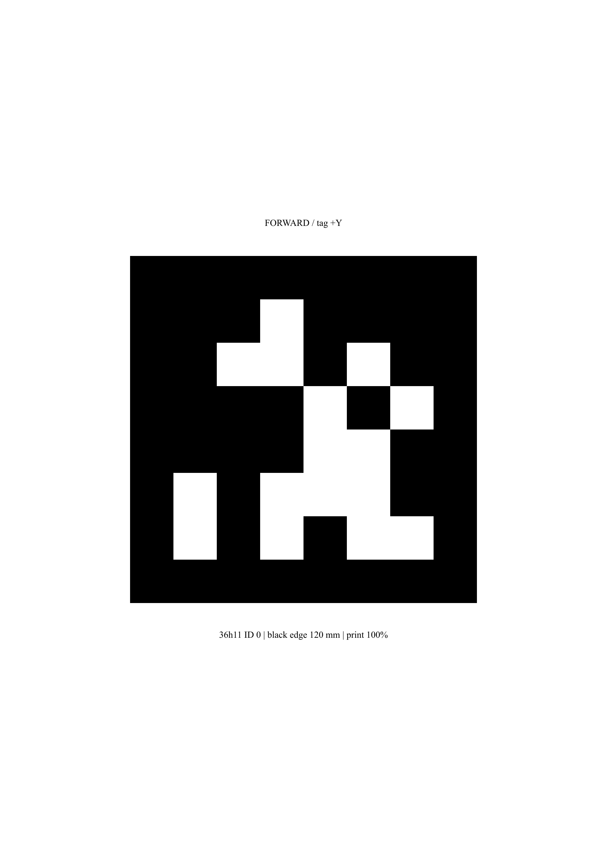
tools/apriltag_gt/prints/tag36h11_id0_120mm_A4.png
