zcrawling/LOONARover/platforms/loonar/hardware/pcb/rbphat-xa-b4/history-b3/footprint-review.pdf

# RBPHAT B2 - footprint inspection atlas

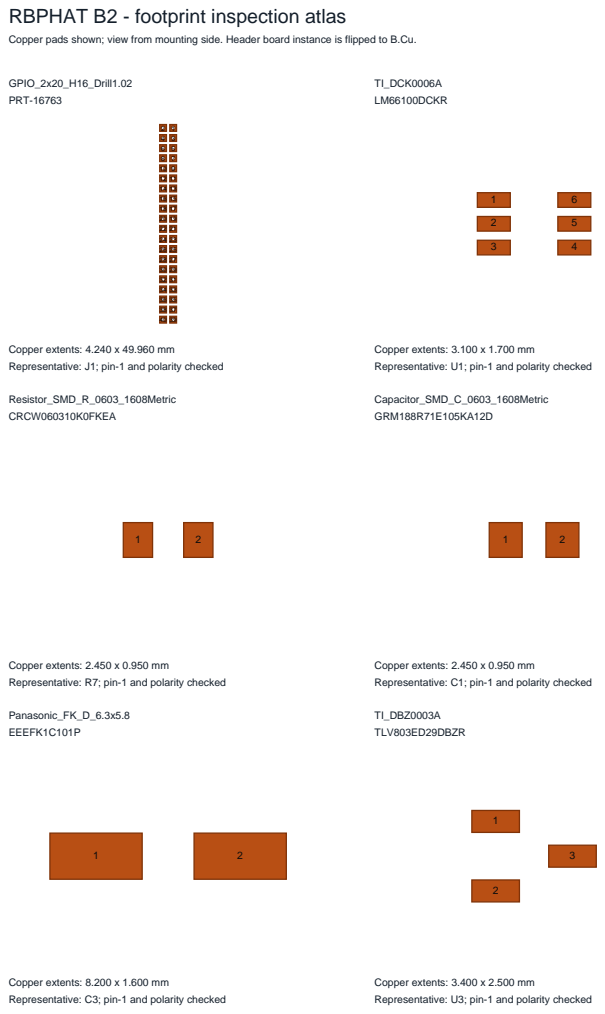
[picture p33: page 1]
GPIO_2x20_H16_Drill1.02 PRT-16763; TI_DCK0006A LM66100DCKR; Resistor_SMD_R_0603_1608Metric CRCW060310K0FKEA; Capacitor_SMD_C_0603_1608Metric GRM188R71E105KA12D; Panasonic_FK_D_6.3x5.8 EEEFK1C101P; TI_DBZ0003A TLV803ED29DBZR

Copper pads shown; view from mounting side. Header board instance is flipped to B.Cu.

10 | 9
12 | 11
14 | 13

22 | 21
24 | 23
26 | 25
28 | 27
30 | 29
32 | 31
34 | 33
36 | 35
38 | 37
40 | 39

Copper extents: 4.240 x 49.960 mm
Representative: J1; pin-1 and polarity checked

Copper extents: 3.100 x 1.700 mm
Representative: U1; pin-1 and polarity checked

Copper extents: 2.450 x 0.950 mm
Representative: R7; pin-1 and polarity checked

Representative: C1; pin-1 and polarity checked

Copper extents: 8.200 x 1.600 mm
Representative: C3; pin-1 and polarity checked

Copper extents: 3.400 x 2.500 mm
Representative: U3; pin-1 and polarity checked

TestPoint_TestPoint_Pad_D1.5mm PCB feature - no purchased part

1

Copper extents: 1.500 x 1.500 mm Representative: TP1; pin-1 and polarity checked

TI_DBV0006A
SN74LVC2G17DBVR

1

2

3 | 4
| 5

6

Copper extents: 3.700 x 2.500 mm Representative: U100; pin-1 and polarity checked

TI_D0008A
THVD1451DR

1

2

3

4 | 5
| 6

7

8

Copper extents: 6.950 x 4.410 mm Representative: U101; pin-1 and polarity checked

Connector_JST_JST_GH_BM05B-GHS-TBT_1x05-1M BM05B-GHS-TBT(LF)(SN)

1 | 2 | 3 | 4 | 5
MP | MP

Copper extents: 9.700 x 5.600 mm Representative: J2; pin-1 and polarity checked

Bourns_CDSOT23_SM712
CDSOT23-SM712

1

2

3

Copper extents: 2.850 x 2.750 mm Representative: D100; pin-1 and polarity checked

Connector_JST_JST_GH_BM02B-GHS-TBT_1x02-1M BM02B-GHS-TBT(LF)(SN)

1 | 2
MP | MP

Copper extents: 5.950 x 5.600 mm Representative: J4; pin-1 and polarity checked

TI_PW0014A
TMUX1511PWR

1
2
3
4
5
6
7 | 8
| 9

10

11

12

13

14

Copper extents: 7.300 x 4.350 mm Representative: U300; pin-1 and polarity checked

TI_DGS0010A
ADS1115IDGSR

1
2
3
4
5 | 6
| 7

8

9

10

Copper extents: 5.850 x 2.300 mm Representative: U301; pin-1 and polarity checked

TI_DGK0008A
TCA9517ADGKR

1

2

3

4 | 5
| 6

7

8

Copper extents: 5.800 x 2.400 mm Representative: U302; pin-1 and polarity checked
