zcrawling/LOONARover/platforms/loonar/ros2/loonar_description/urdf/loonar.urdf.xacro

<?xml version="1.0"?>
<!-- GENERATED by tools/cad/build_description.py; edit generator/configuration, not this file. -->
<robot xmlns:xacro="http://www.ros.org/wiki/xacro" name="loonar">
<xacro:arg name="imu_xyz" default="0.03575 0 -0.057"/>
<xacro:arg name="imu_rpy" default="0 0 1.5707963267948966"/>
<xacro:arg name="tof_xyz" default="0.03575 0.0000500000471 -0.0075"/>
<xacro:arg name="tof_rpy" default="-1.5707963267948966 0 0"/>
<xacro:arg name="publish_optical_frames" default="false"/>
<xacro:arg name="tof_optical_offset" default="0.01599 0 0"/>
<xacro:arg name="camera_optical_xyz" default="0 0 0"/>
<xacro:arg name="camera_optical_rpy" default="0 0 0"/>
<link name="base_link"/>
<link name="left_motor_cad"/><joint name="left_motor_cad_mount" type="fixed"><parent link="base_link"/><child link="left_motor_cad"/><origin xyz="0 0.123 -0.007" rpy="0 0 -1.57079632679"/></joint>
<link name="chassis_cad"/><joint name="chassis_cad_mount" type="fixed"><parent link="base_link"/><child link="chassis_cad"/><origin xyz="0 0 -0.057" rpy="0 0 -1.57079632679"/></joint>
<link name="right_motor_cad"/><joint name="right_motor_cad_mount" type="fixed"><parent link="base_link"/><child link="right_motor_cad"/><origin xyz="0 -0.123 -0.007" rpy="0 0 1.57079632679"/></joint>
<link name="reaction_wheel_assembly_cad"/><joint name="reaction_wheel_assembly_cad_mount" type="fixed"><parent link="base_link"/><child link="reaction_wheel_assembly_cad"/><origin xyz="-0.00999999984045 -0.005 -0.055" rpy="0 0 -1.57079632679"/></joint>
<link name="battery_cad"/><joint name="battery_cad_mount" type="fixed"><parent link="base_link"/><child link="battery_cad"/><origin xyz="-0.025239278817 0.0502257958591 -0.0511921688321" rpy="1.57079632679 2.22044604925e-16 -1.57079632679"/></joint>
<link name="tail_mount_cad"/><joint name="tail_mount_cad_mount" type="fixed"><parent link="base_link"/><child link="tail_mount_cad"/><origin xyz="-0.052 -4.4408920985e-18 -0.105915548185" rpy="0 0 -1.57079632679"/></joint>
<link name="motor_driver_cad"/><joint name="motor_driver_cad_mount" type="fixed"><parent link="base_link"/><child link="motor_driver_cad"/><origin xyz="-0.0797975385957 0.110989242796 -0.0670095095674" rpy="0 0 -1.57079632679"/></joint>
<link name="reaction_esc_cad"/><joint name="reaction_esc_cad_mount" type="fixed"><parent link="base_link"/><child link="reaction_esc_cad"/><origin xyz="-0.025 -0.01 0.038" rpy="3.14159265359 1.57079632679 0"/></joint>
<link name="raspberry_pi_cad"/><joint name="raspberry_pi_cad_mount" type="fixed"><parent link="base_link"/><child link="raspberry_pi_cad"/><origin xyz="0.042 -0.0710855124822 -0.007" rpy="-1.57079632679 2.22044604925e-16 1.57079632679"/></joint>
<link name="tof_assembly_cad"/><joint name="tof_assembly_cad_mount" type="fixed"><parent link="base_link"/><child link="tof_assembly_cad"/><origin xyz="0.03715 5.00000333166e-05 0.084" rpy="-3.14159265359 -1.57079632679 0"/></joint>
<link name="camera_assembly_cad"/><joint name="camera_assembly_cad_mount" type="fixed"><parent link="base_link"/><child link="camera_assembly_cad"/><origin xyz="0.04629896 -0.0255999998674 -0.0194999987793" rpy="1.57079632679 0 -1.57079632679"/></joint>
<link name="sensor_mcu_cad"/><joint name="sensor_mcu_cad_mount" type="fixed"><parent link="base_link"/><child link="sensor_mcu_cad"/><origin xyz="0.046 0.147 0.073" rpy="1.57079632679 0 -1.57079632679"/></joint>
<link name="motor_bracket_cad"/><joint name="motor_bracket_cad_mount" type="fixed"><parent link="base_link"/><child link="motor_bracket_cad"/><origin xyz="-0.05 0.093 -0.057" rpy="1.57079632679 0 0"/></joint>
<link name="imu_link"/><joint name="imu_link_mount" type="fixed"><parent link="base_link"/><child link="imu_link"/><origin xyz="$(arg imu_xyz)" rpy="$(arg imu_rpy)"/></joint>
<link name="tof_link"/><joint name="tof_link_mount" type="fixed"><parent link="base_link"/><child link="tof_link"/><origin xyz="$(arg tof_xyz)" rpy="$(arg tof_rpy)"/></joint>
<!-- Optical frames require explicit measured offsets; disabled by default. -->
<xacro:if value="$(arg publish_optical_frames)">
<link name="tof_optical_frame"/><joint name="tof_optical_frame_mount" type="fixed"><parent link="tof_link"/><child link="tof_optical_frame"/><origin xyz="$(arg tof_optical_offset)" rpy="-1.5707963267948966 0 -1.5707963267948966"/></joint>
<link name="camera_optical_frame"/><joint name="camera_optical_frame_mount" type="fixed"><parent link="camera_assembly_cad"/><child link="camera_optical_frame"/><origin xyz="$(arg camera_optical_xyz)" rpy="$(arg camera_optical_rpy)"/></joint>
</xacro:if>
<link name="left_wheel_spindle"/><joint name="left_wheel_spindle_mount" type="fixed"><parent link="base_link"/><child link="left_wheel_spindle"/><origin xyz="0 0.1285 0" rpy="0 0 0"/></joint>
<link name="left_wheel_link"/><joint name="left_wheel_joint" type="continuous"><parent link="left_wheel_spindle"/><child link="left_wheel_link"/><origin xyz="0 0 0" rpy="0 0 0"/><axis xyz="0 1 0"/></joint>
<link name="right_wheel_spindle"/><joint name="right_wheel_spindle_mount" type="fixed"><parent link="base_link"/><child link="right_wheel_spindle"/><origin xyz="0 -0.1285 0" rpy="0 0 0"/></joint>
<link name="right_wheel_link"/><joint name="right_wheel_joint" type="continuous"><parent link="right_wheel_spindle"/><child link="right_wheel_link"/><origin xyz="0 0 0" rpy="0 0 0"/><axis xyz="0 1 0"/></joint>
</robot>
