zcrawling/LOONARover/platforms/loonar/hardware/pcb/rbphat-xa-b4/rbphat.pdf

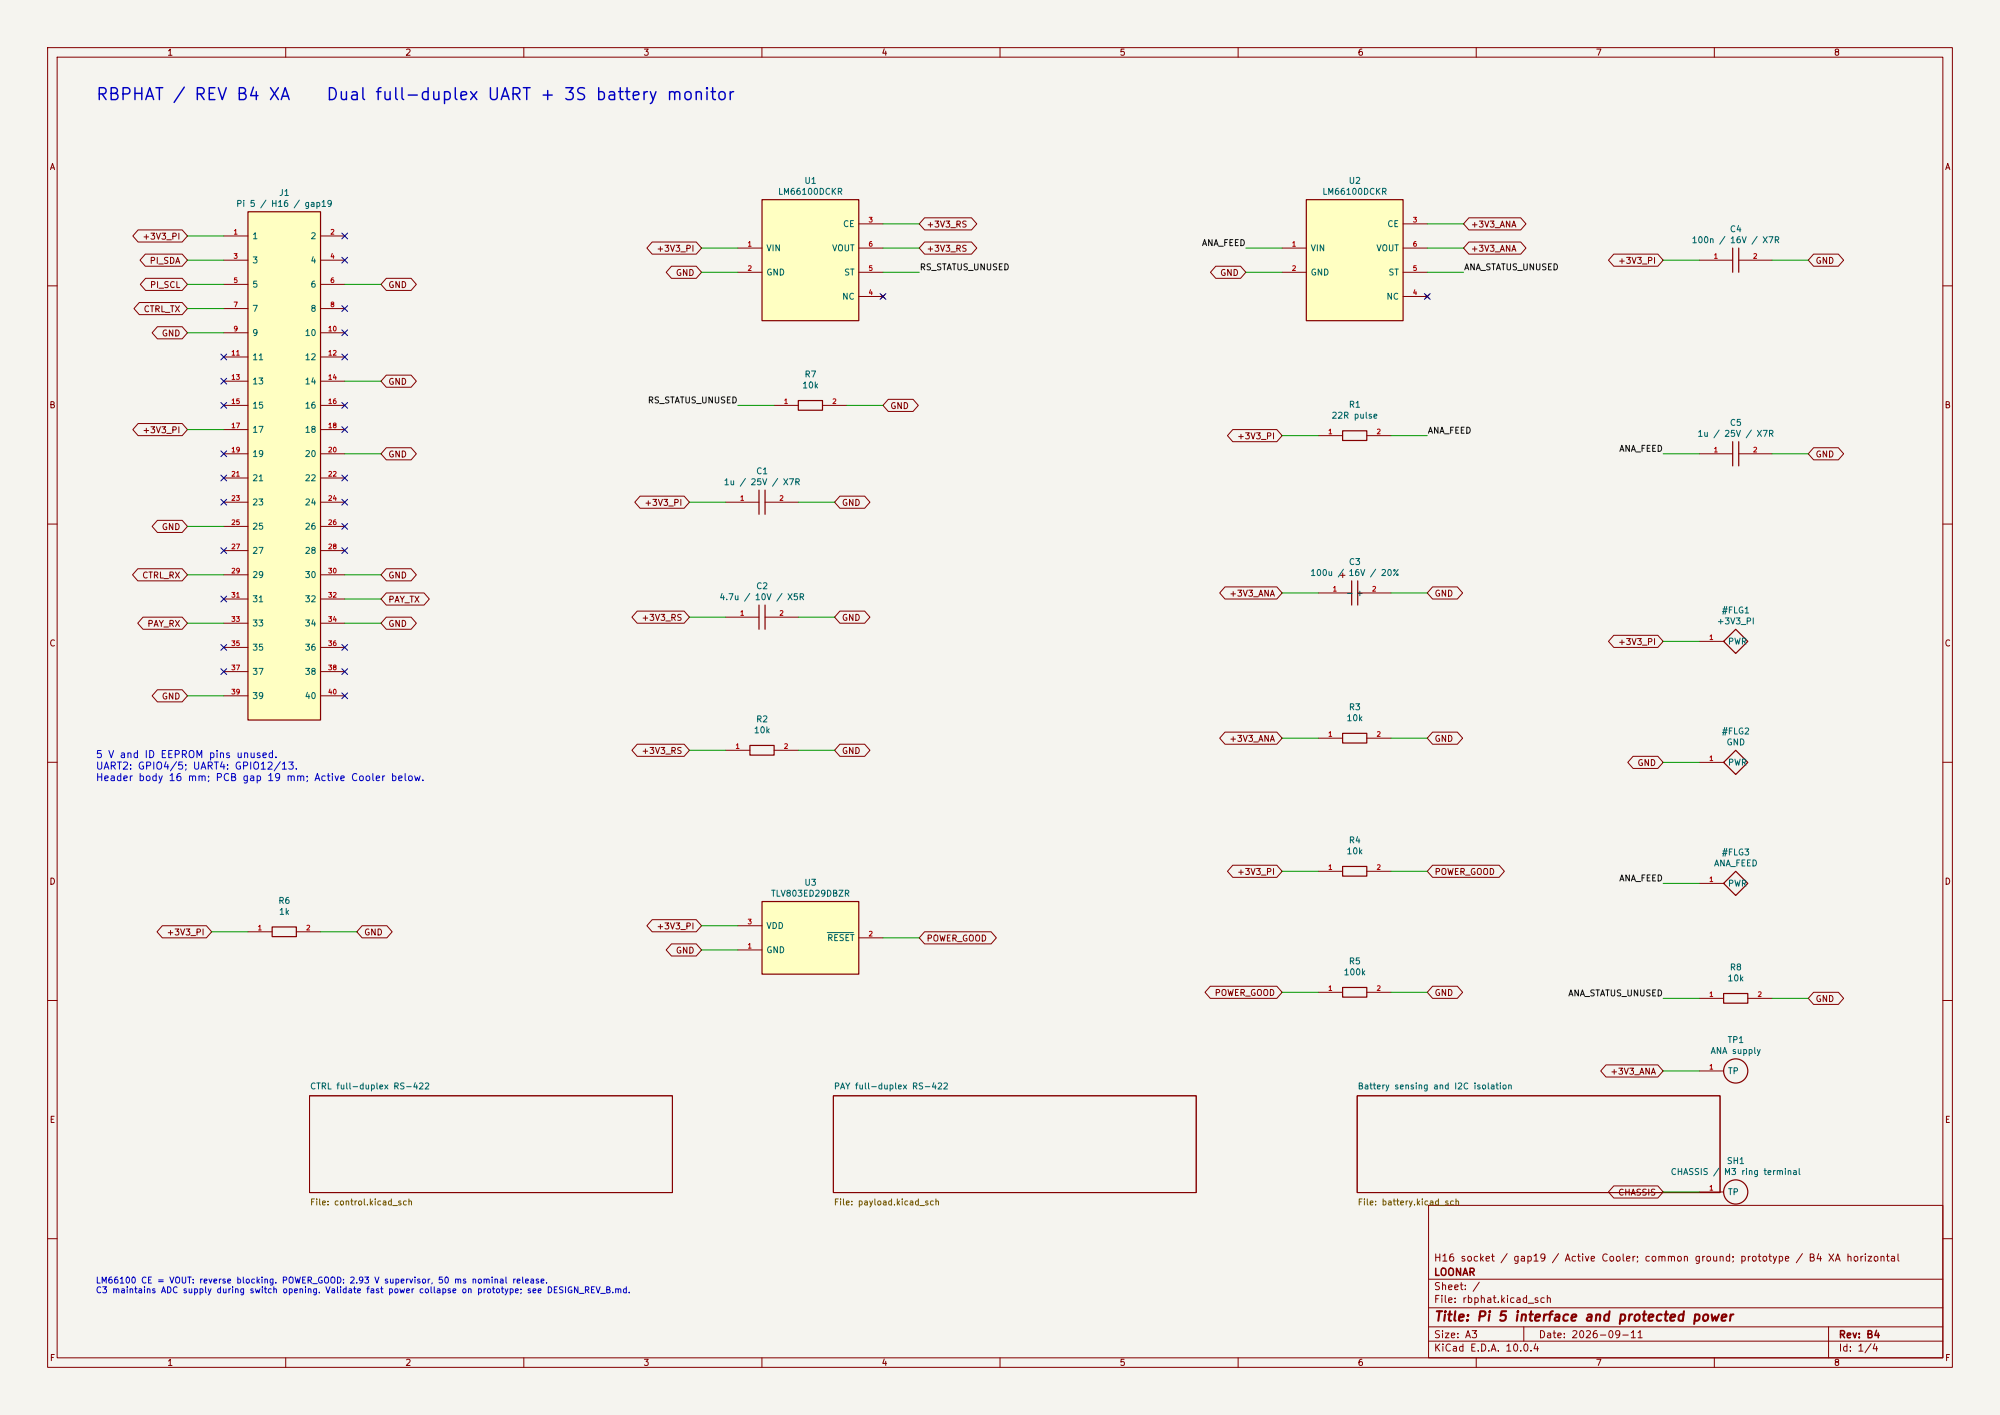
[picture p34: page 1]

ANA_FEED 5 V and ID EEPROM pins unused.
UART2: GPIO4/5; UART4: GPIO12/13.
Header body 16 mm; PCB gap 19 mm; Active Cooler below. LM66100 CE = VOUT: reverse blocking. POWER_GOOD: 2.93 V supervisor, 50 ms nominal release. C3 maintains ADC supply during switch opening. Validate fast power collapse on prototype; see DESIGN_REV_B.md.

H16 socket / gap19 / Active Cooler; common ground; prototype / B4 XA horizontal CTRL full-duplex RS-422

Battery sensing and I2C isolation

LOONAR
Sheet: /
File: rbphat.kicad_sch
Title: Pi 5 interface and protected power

Size: A3 | Rev: B4 | F Date: 2026-09-11
KiCad E.D.A. 10.0.4 | Id: 1/4

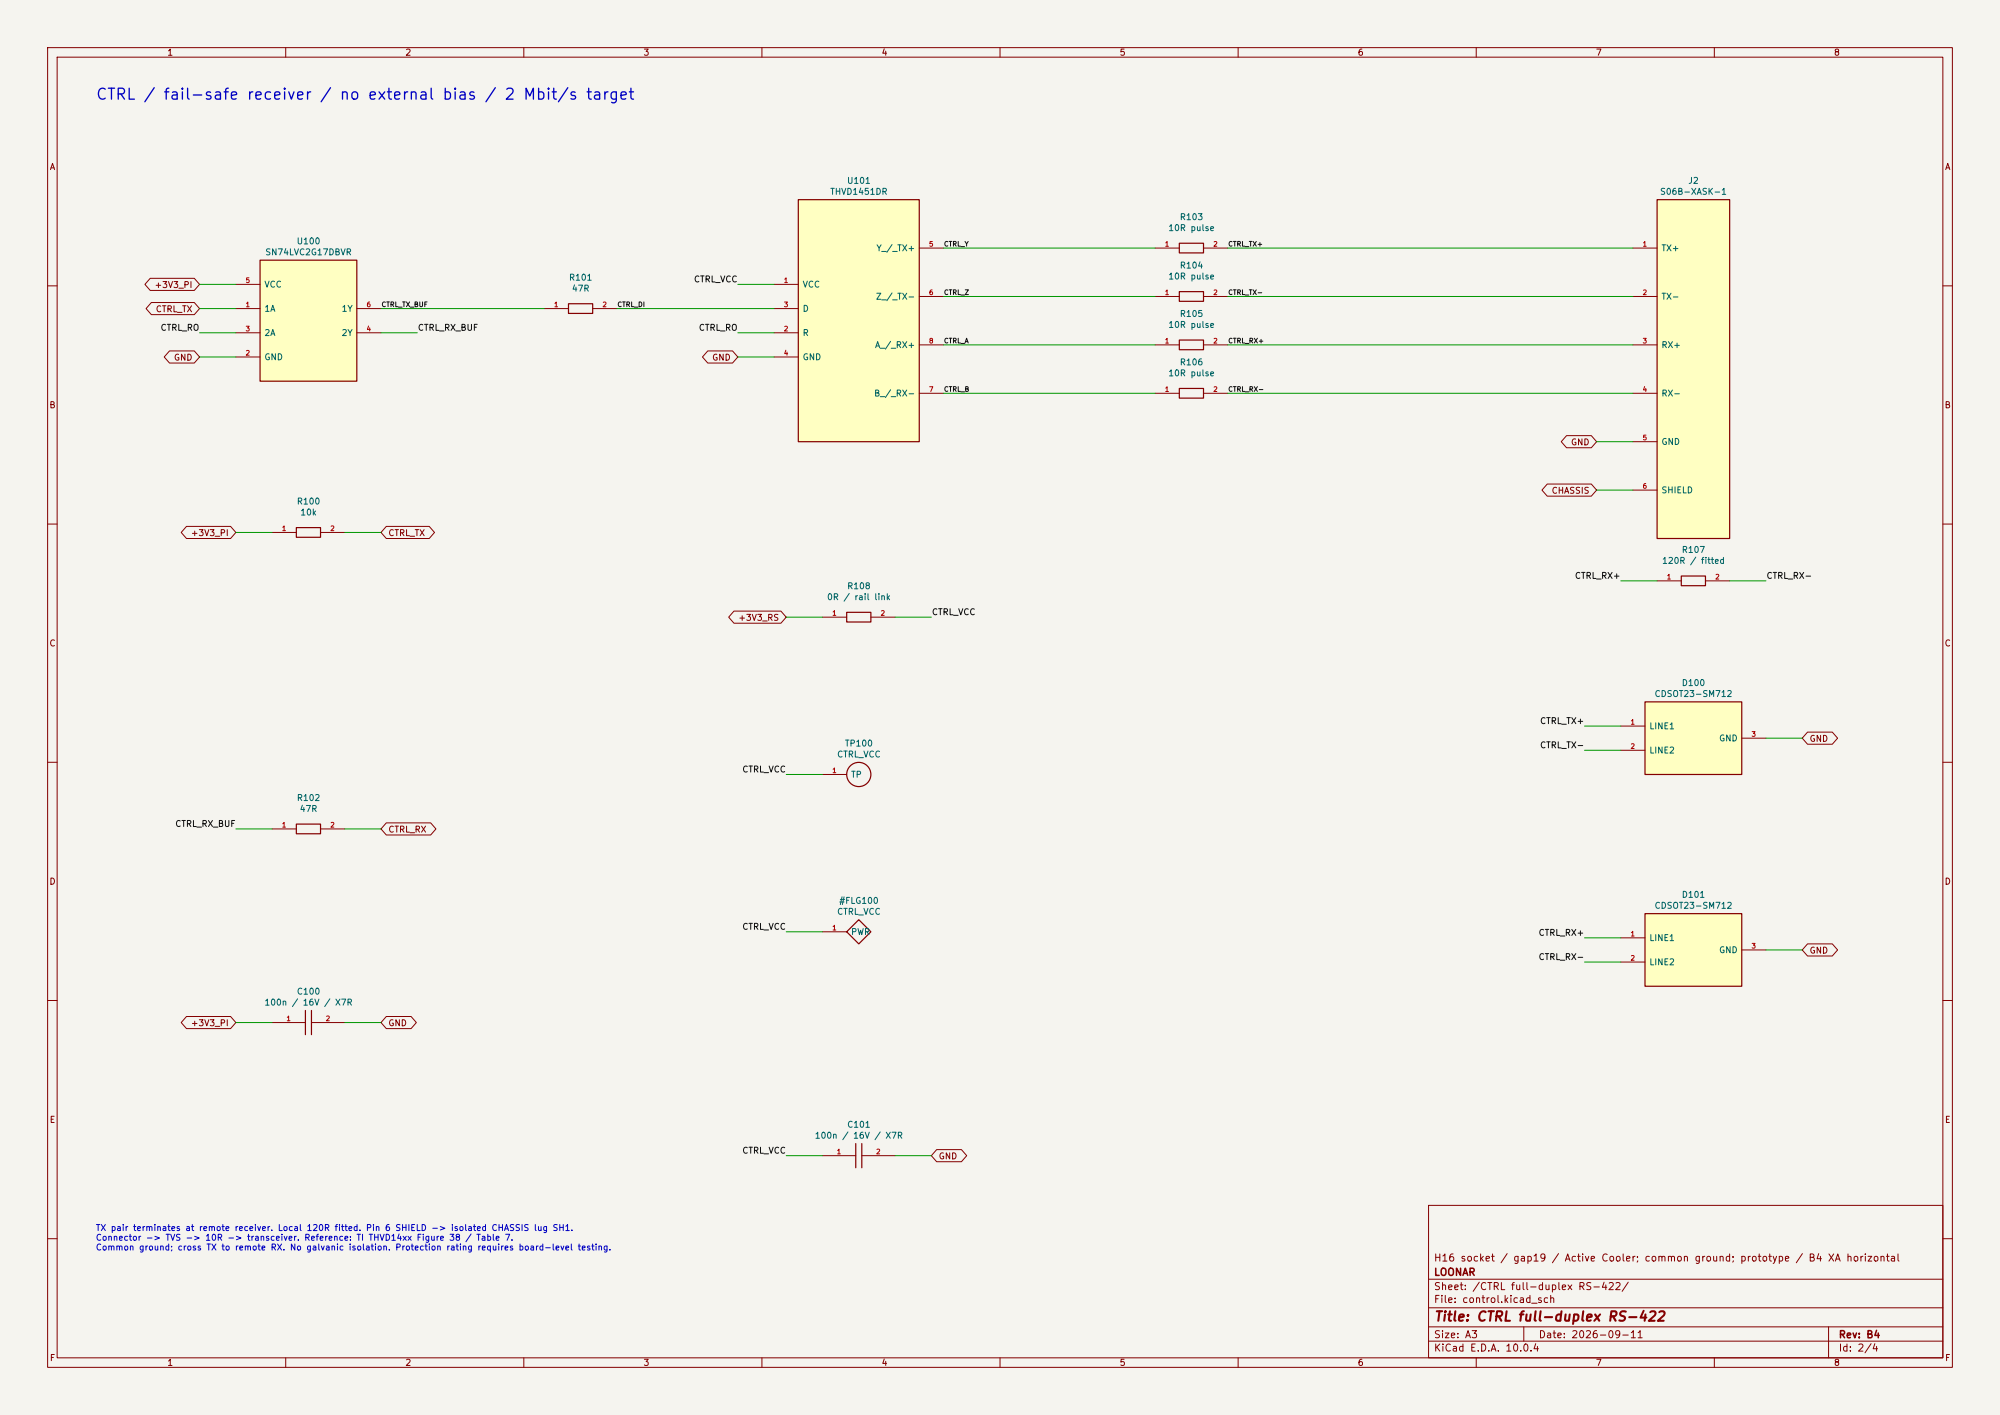
[picture p35: page 2]

CTRL / fail-safe receiver / no external bias / 2 Mbit/s target
CTRL_TX_BUF CTRL_RX_BUF
CTRL_TX

TX pair terminates at remote receiver. Local 120R fitted. Pin 6 SHIELD -> isolated CHASSIS lug SH1. Connector -> TVS -> 10R -> transceiver. Reference: TI THVD14xx Figure 38 / Table 7. Common ground; cross TX to remote RX. No galvanic isolation. Protection rating requires board-level testing.

LOONAR
Sheet: /CTRL full-duplex RS-422/
File: control.kicad_sch
Title: CTRL full-duplex RS-422

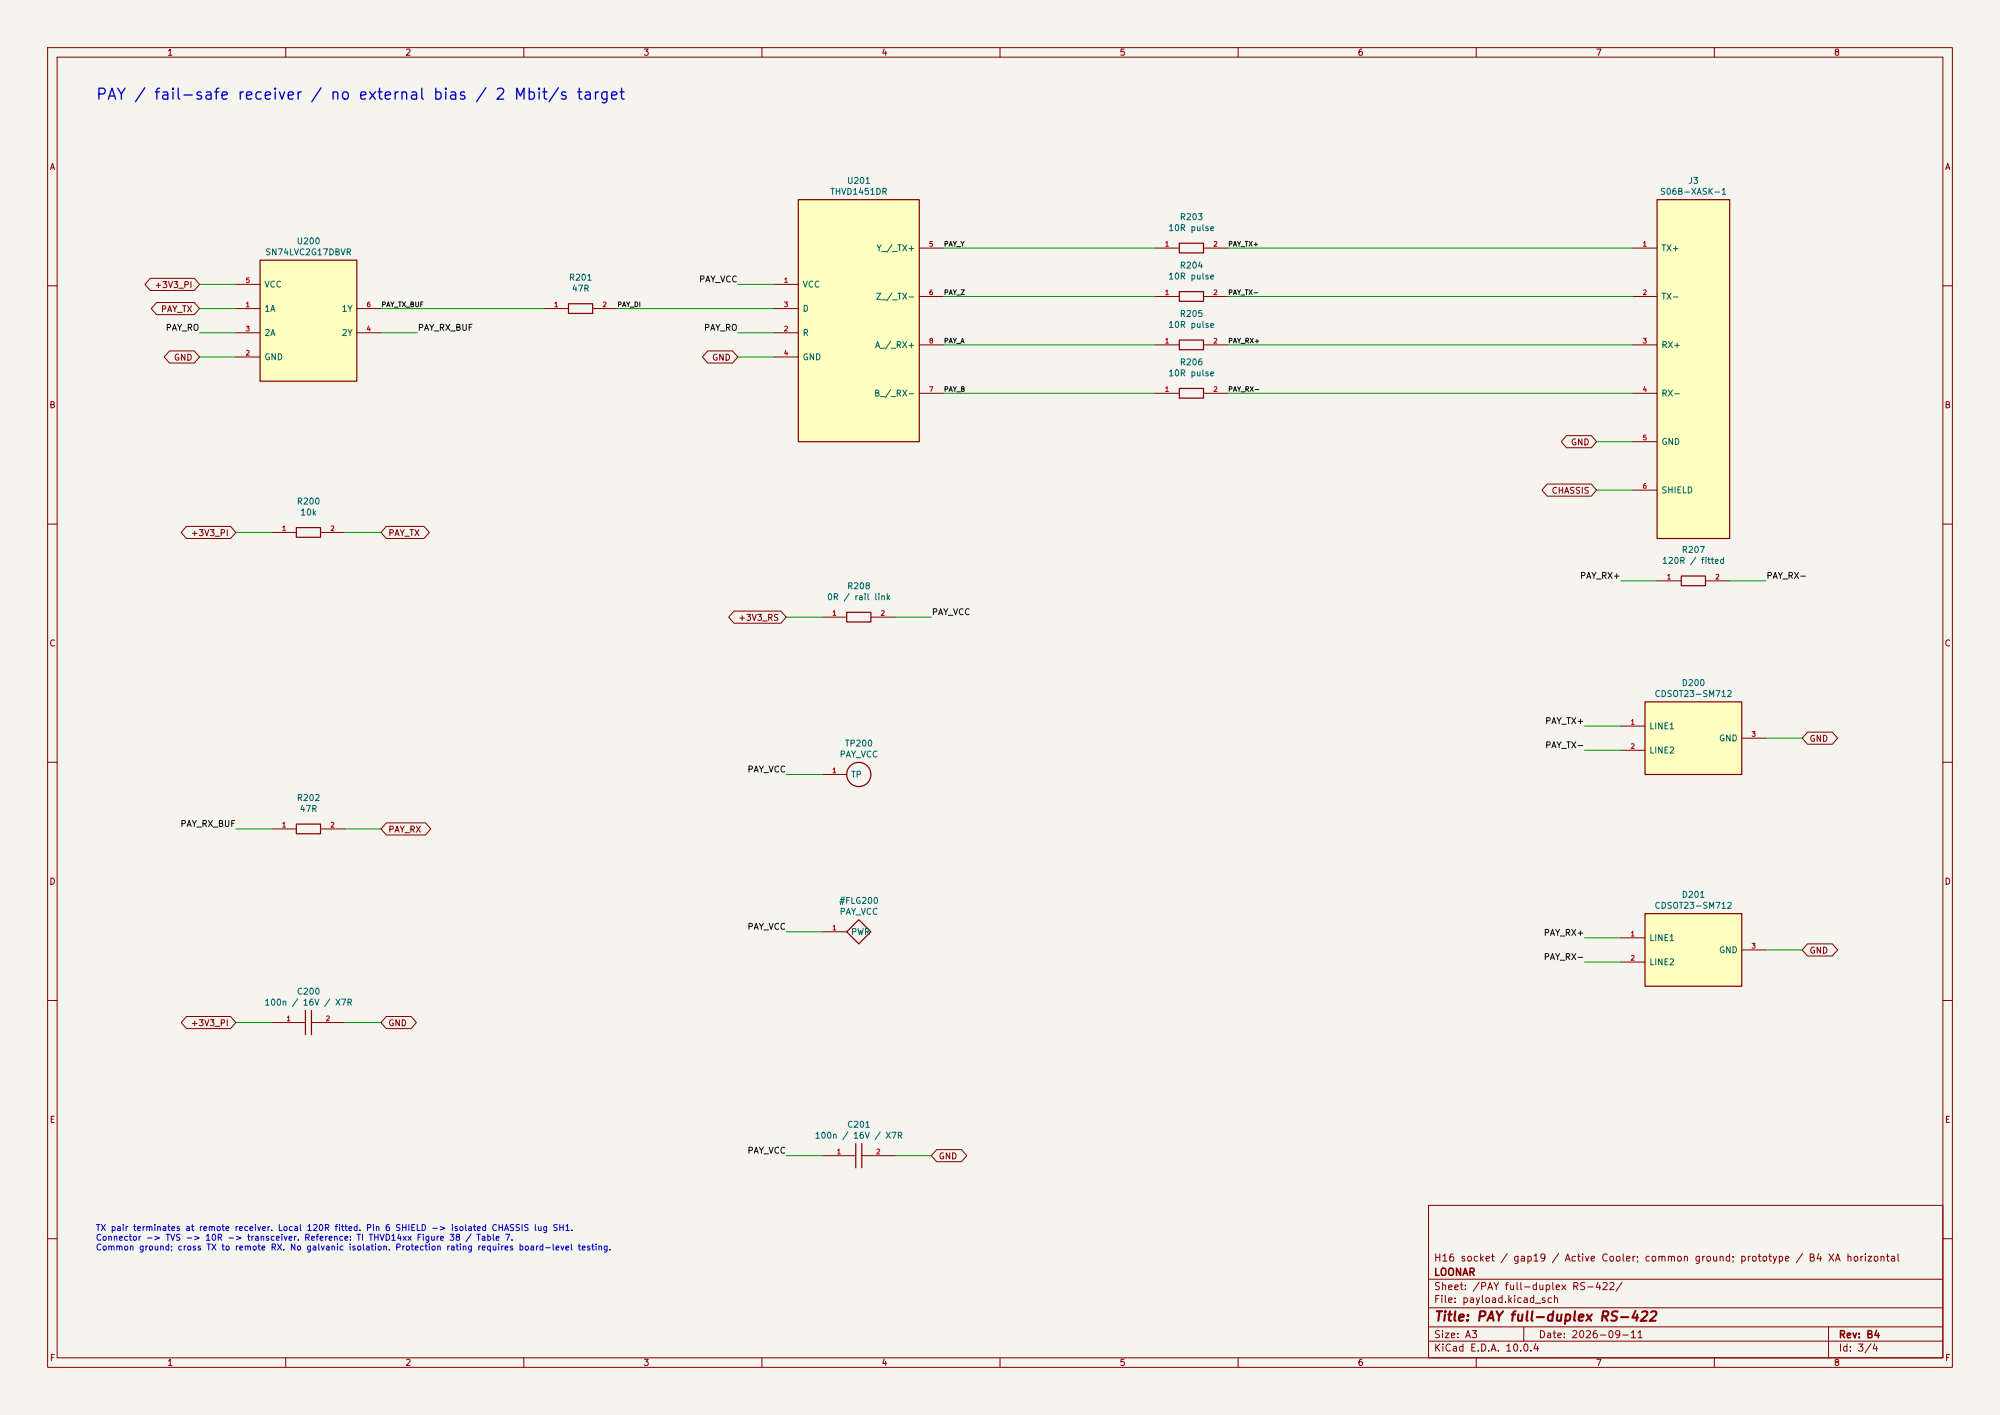
[picture p36: page 3]

PAY / fail-safe receiver / no external bias / 2 Mbit/s target
PAY_TX_BUF PAY_RX_BUF
PAY_TX

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

LOONAR
Sheet: /PAY full-duplex RS-422/
File: payload.kicad_sch
Title: PAY full-duplex RS-422

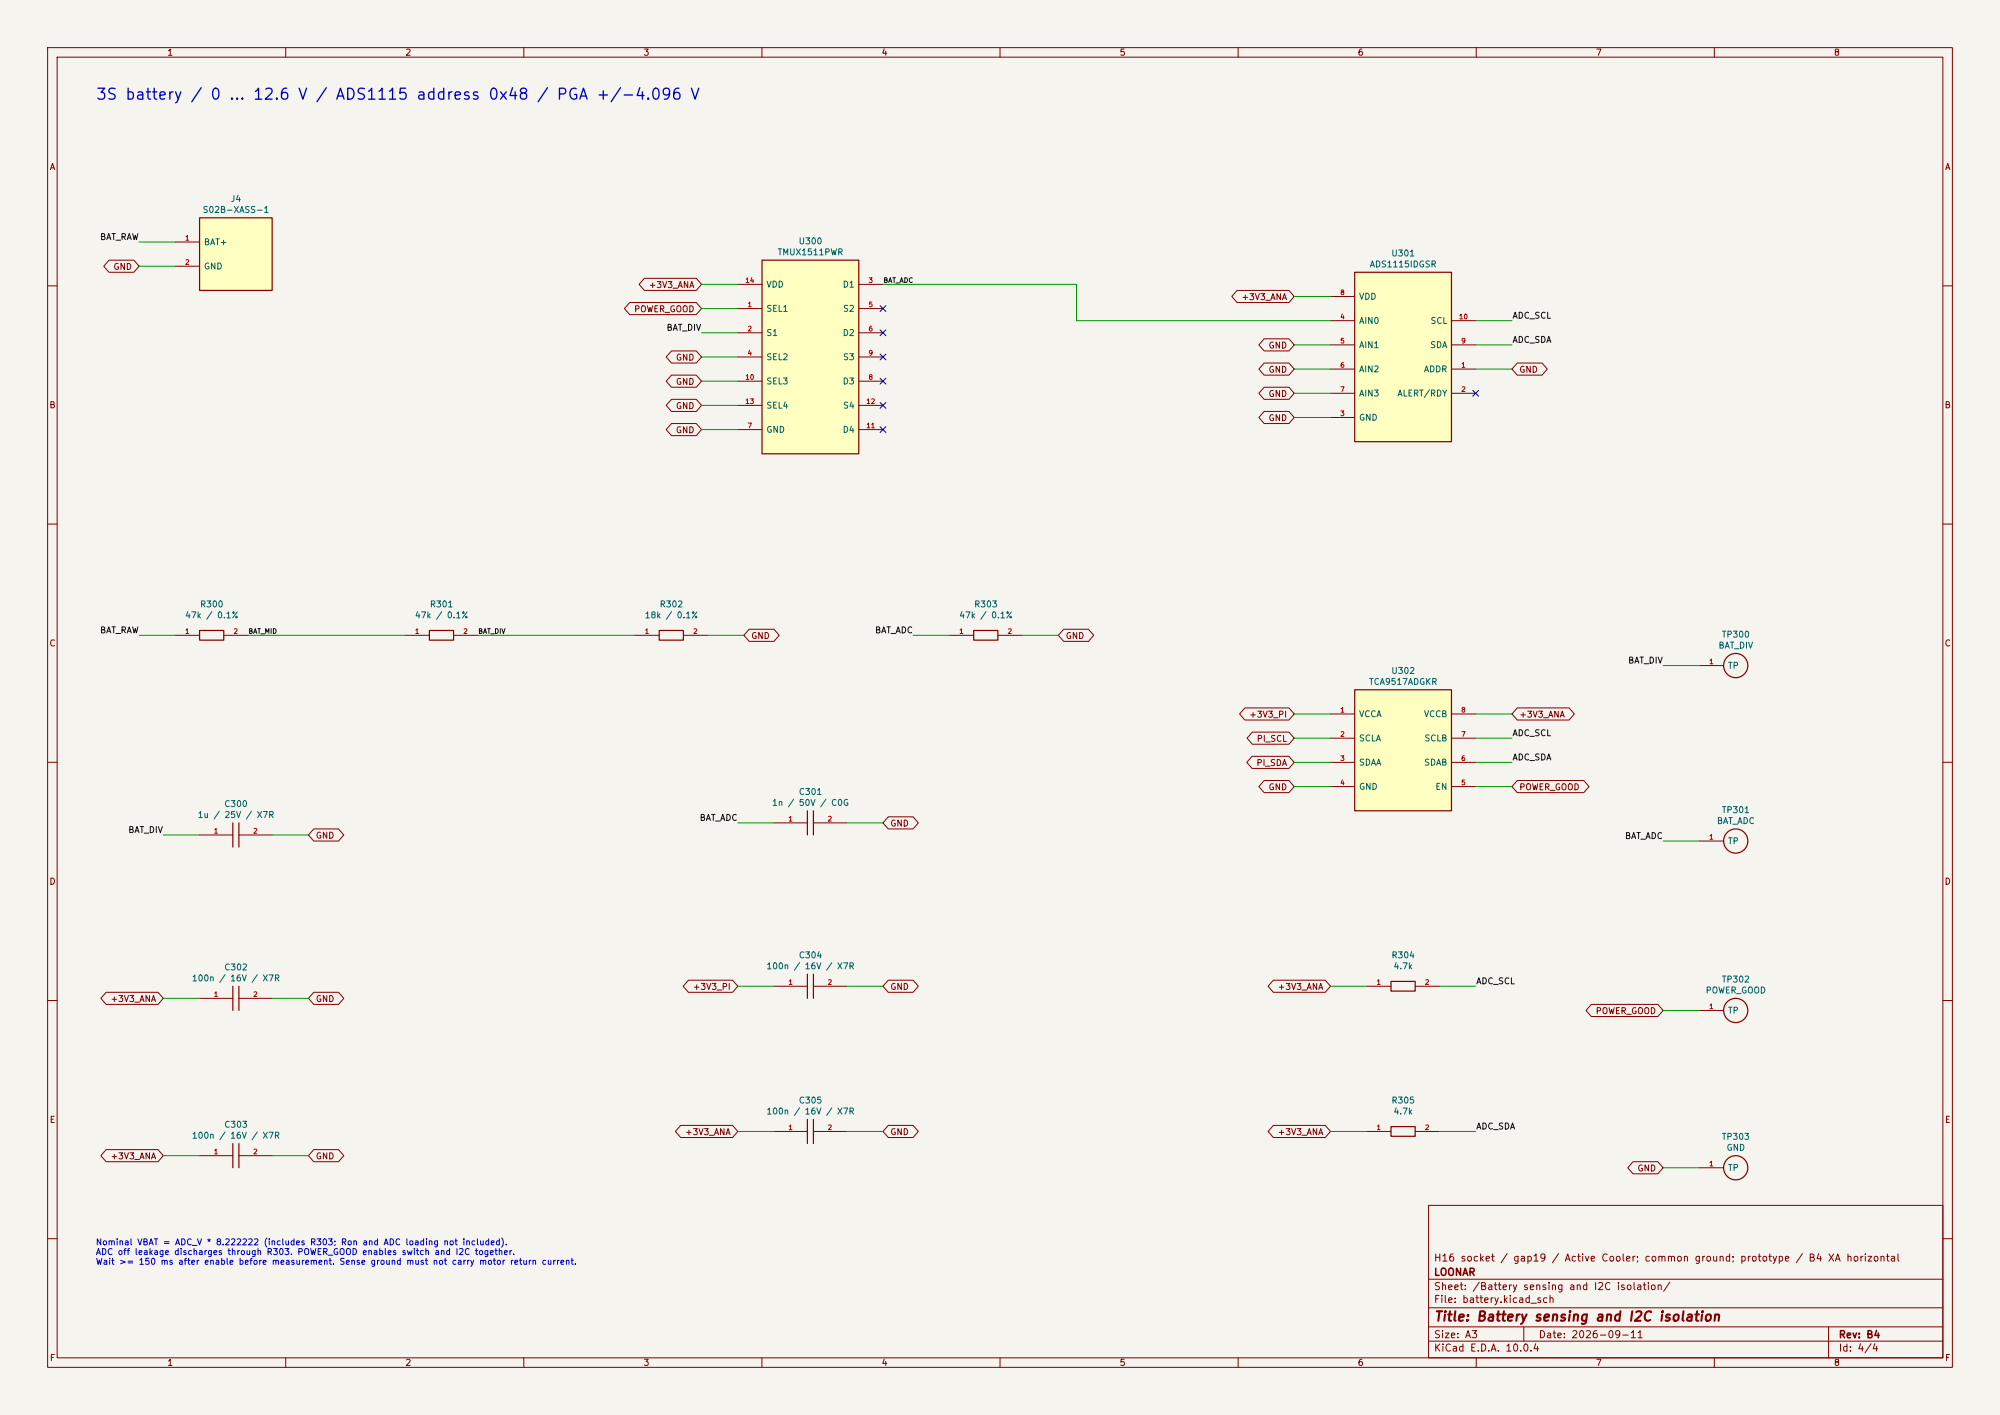
[picture p37: page 4]

Nominal VBAT = ADC_V * 8.222222 (includes R303; Ron and ADC loading not included). ADC off leakage discharges through R303. POWER_GOOD enables switch and I2C together. Wait >= 150 ms after enable before measurement. Sense ground must not carry motor return current.

H16 socket / gap19 / Active Cooler; common ground; prototype / B4 XA horizontal
LOONAR
Sheet: /Battery sensing and I2C isolation/
File: battery.kicad_sch
Title: Battery sensing and I2C isolation
