zcrawling/LOONARover/platforms/loonar/hardware/pcb/rbphat-xa-b4/artwork/copper-layers.pdf

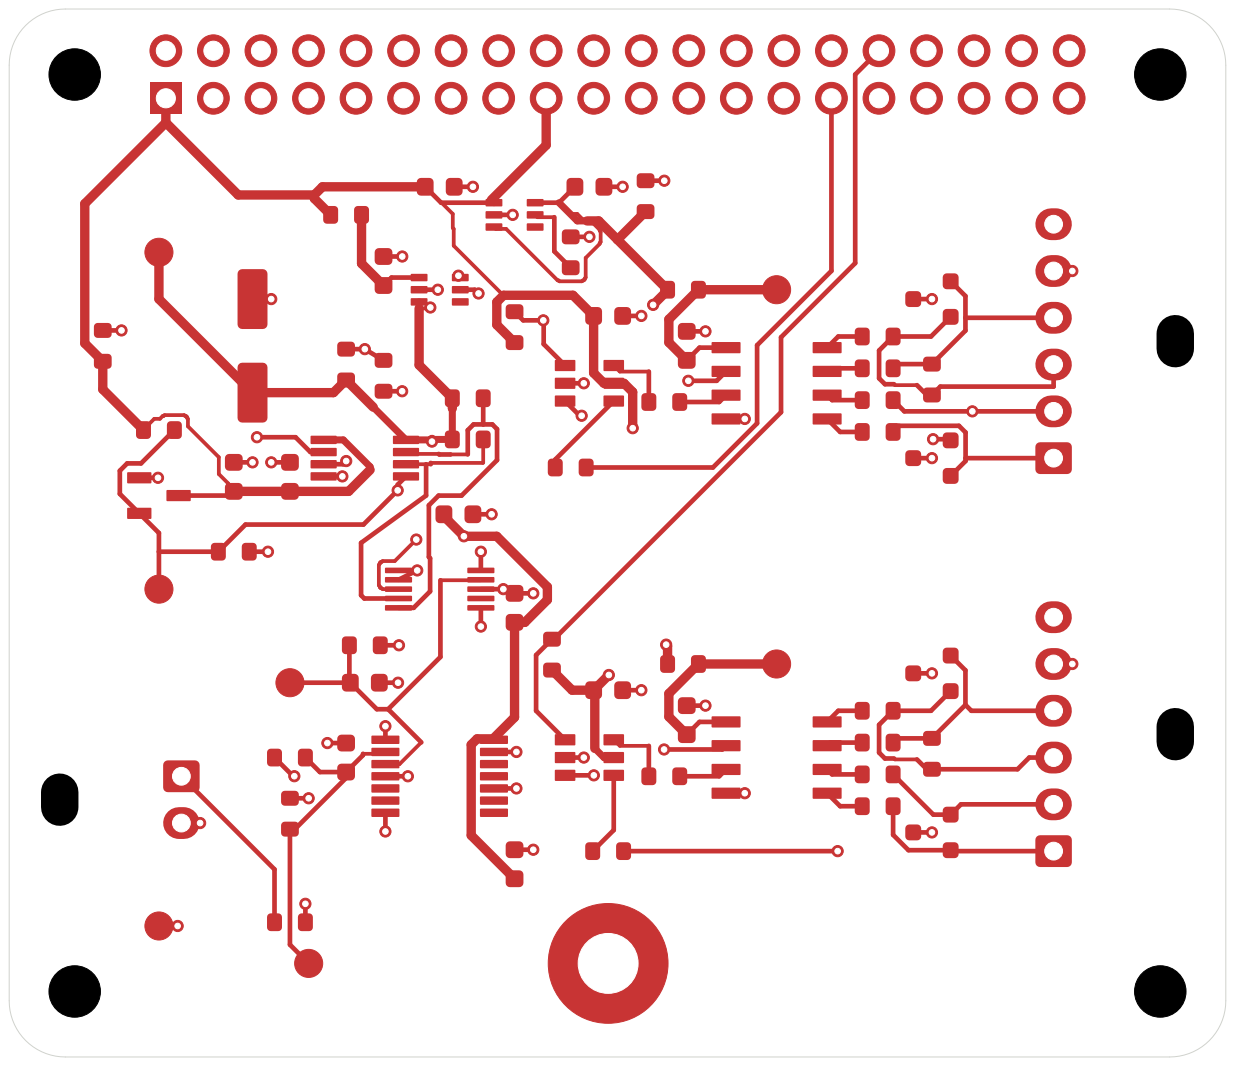
[picture p38: page 1]

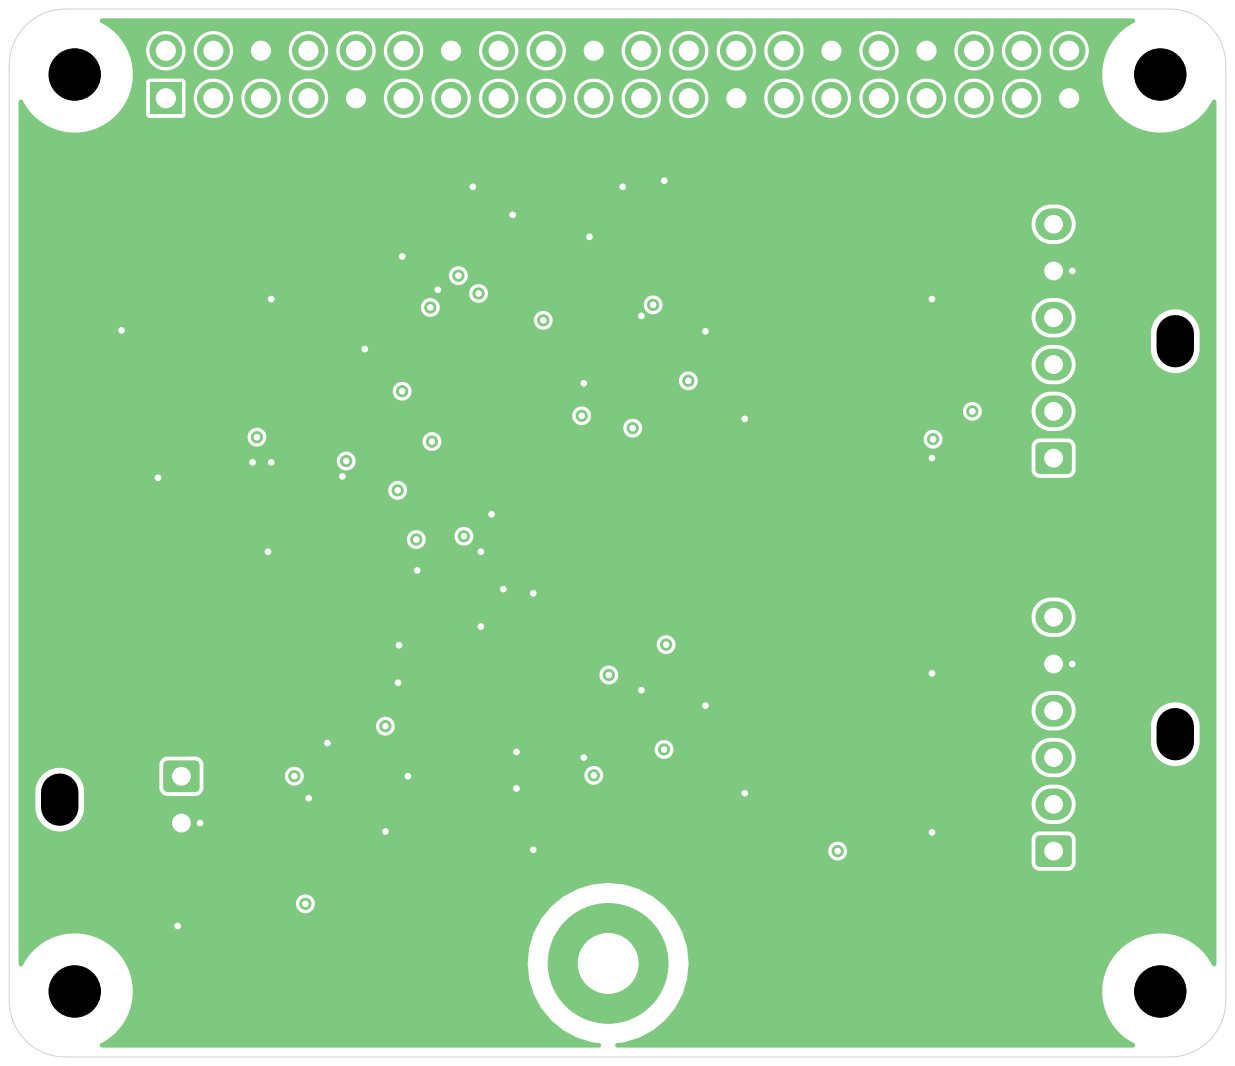
[picture p39: page 2]

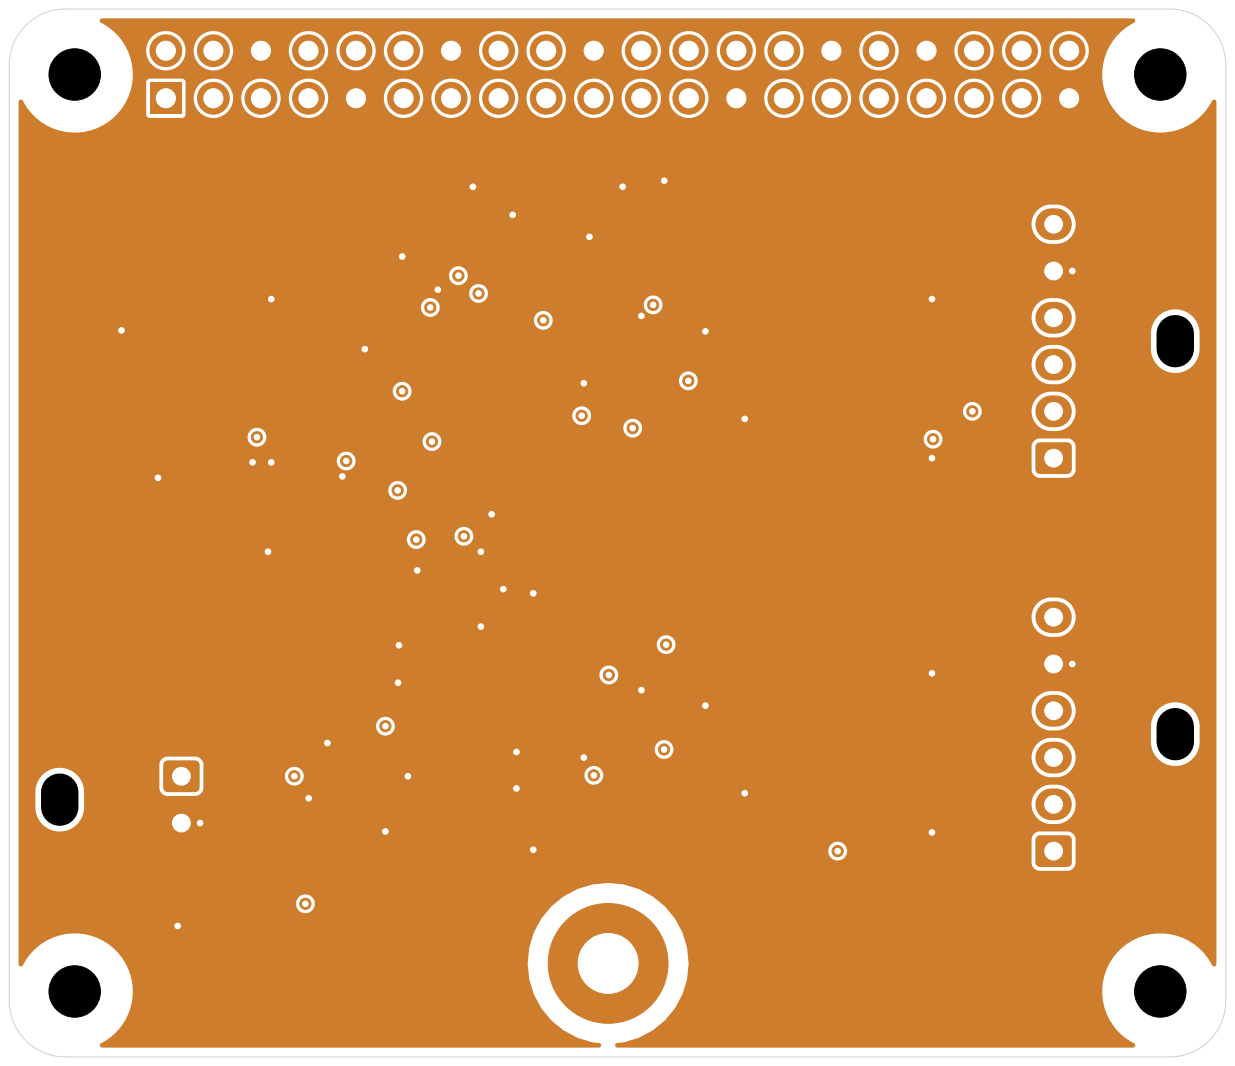
[picture p40: page 3]

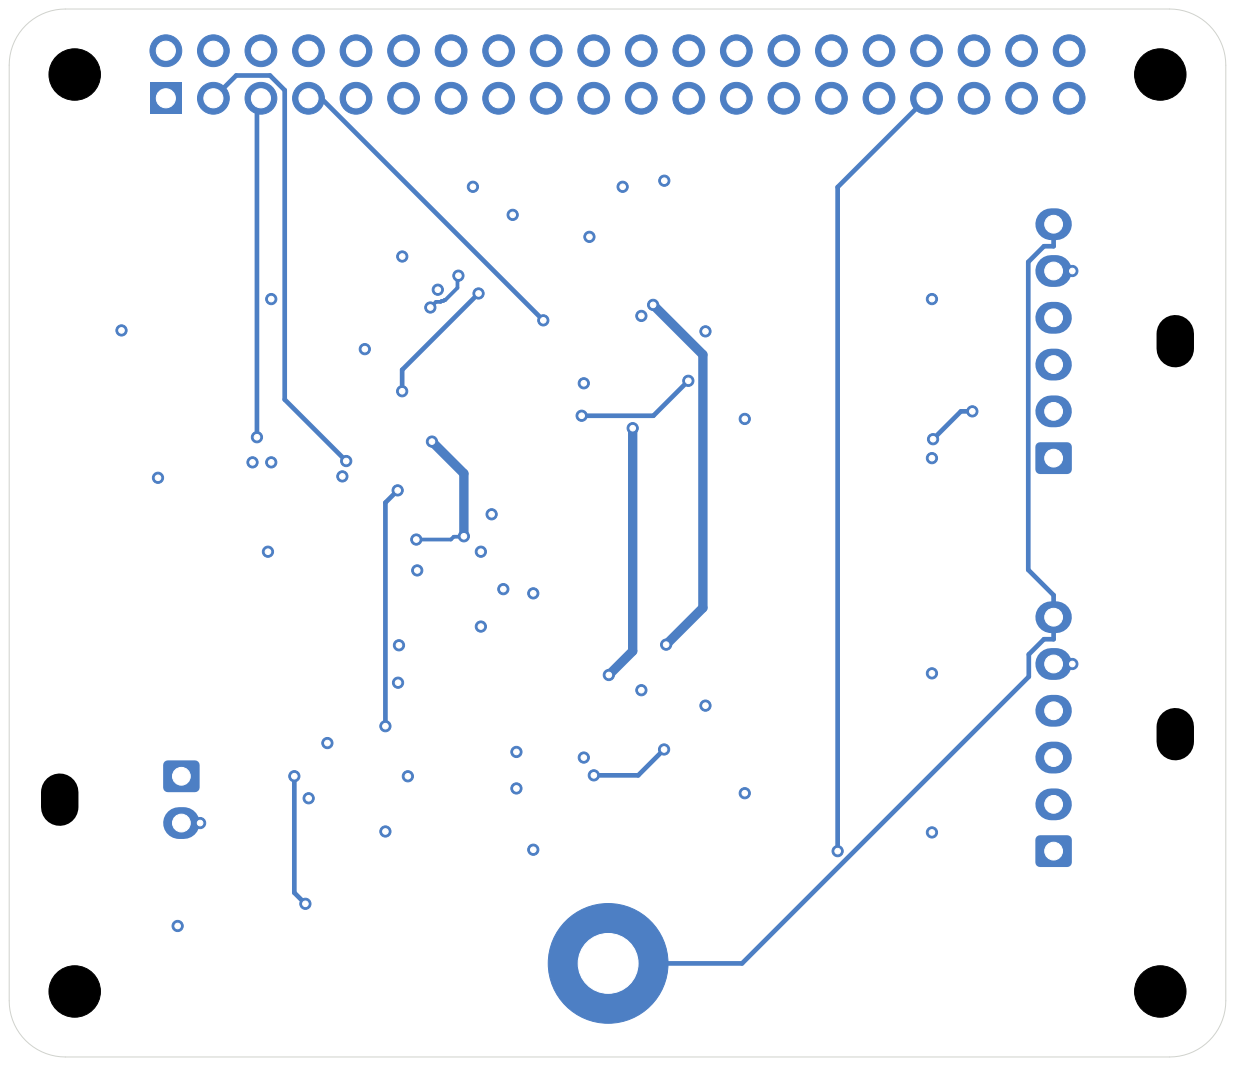
[picture p41: page 4]
