zcrawling/LOONARover/platforms/loonar/hardware/pcb/rbphat-rebuild/artwork/copper-layers.pdf

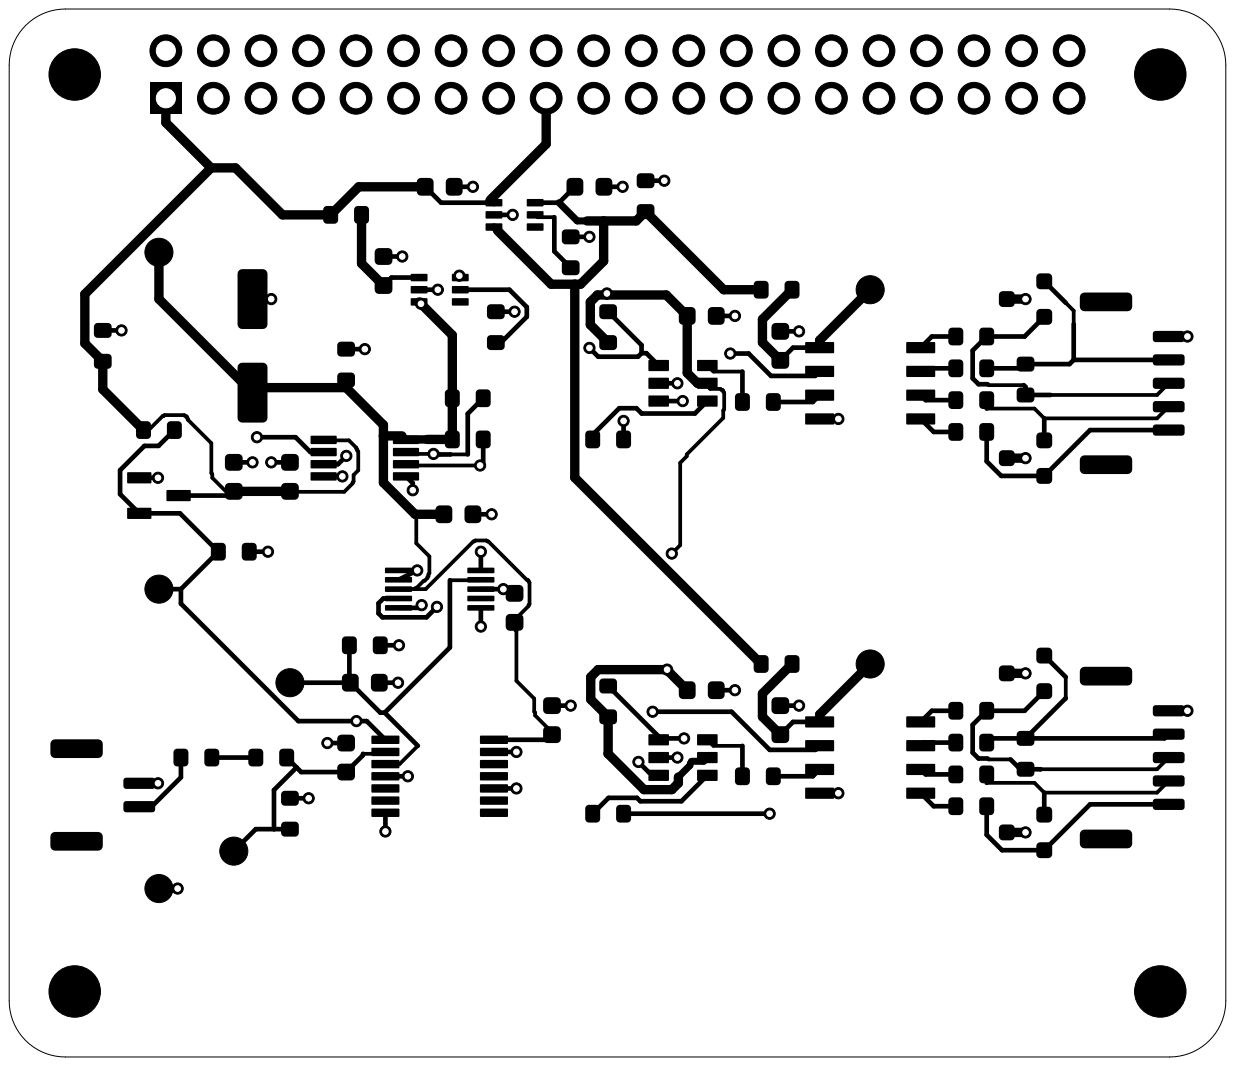
[picture p42: page 1]

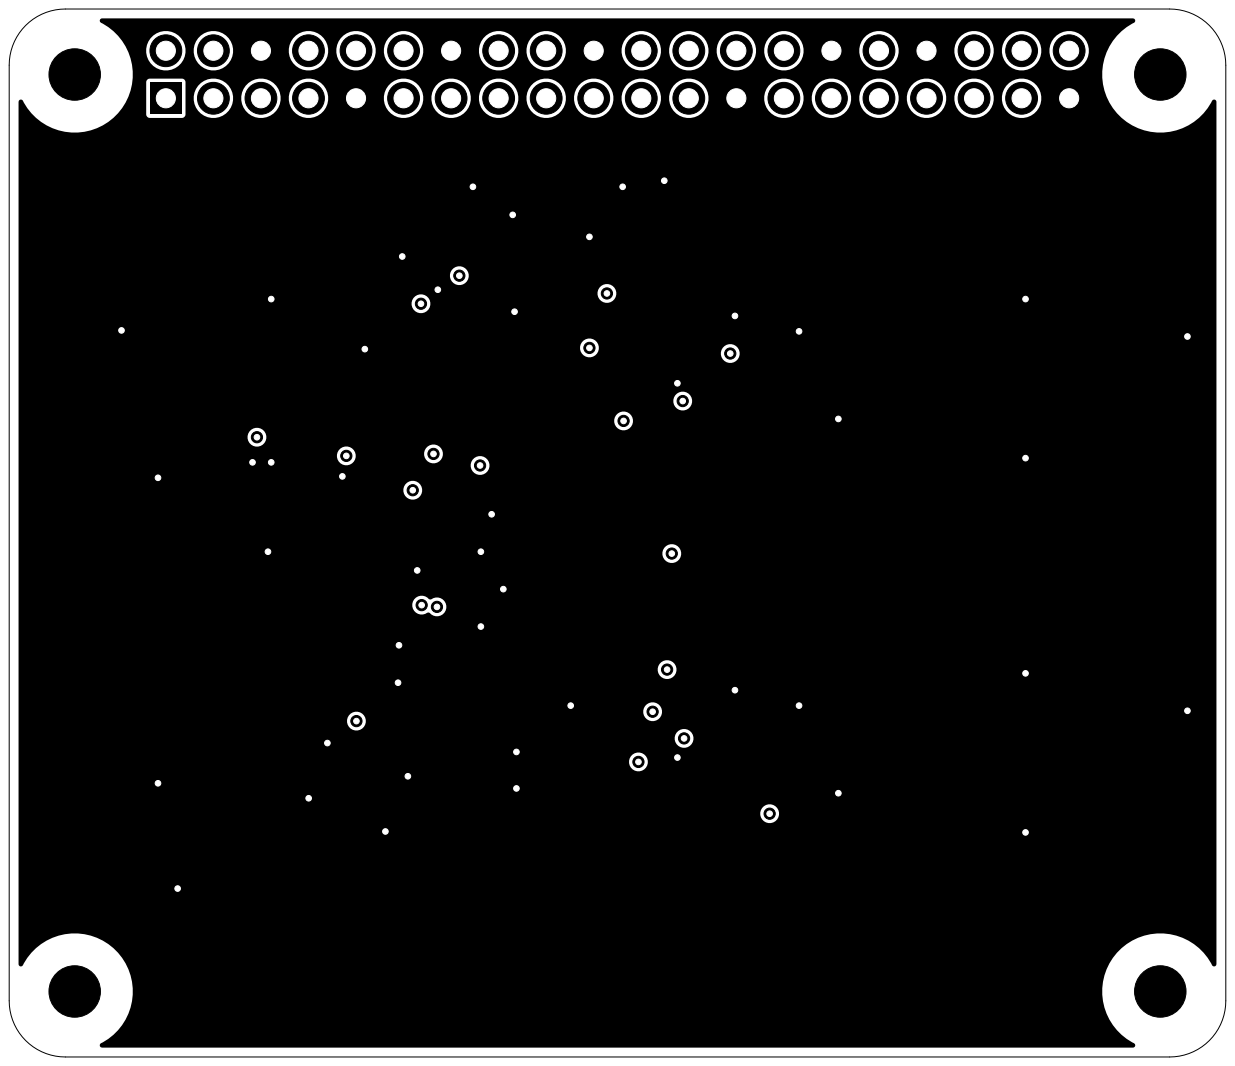
[picture p43: page 2]

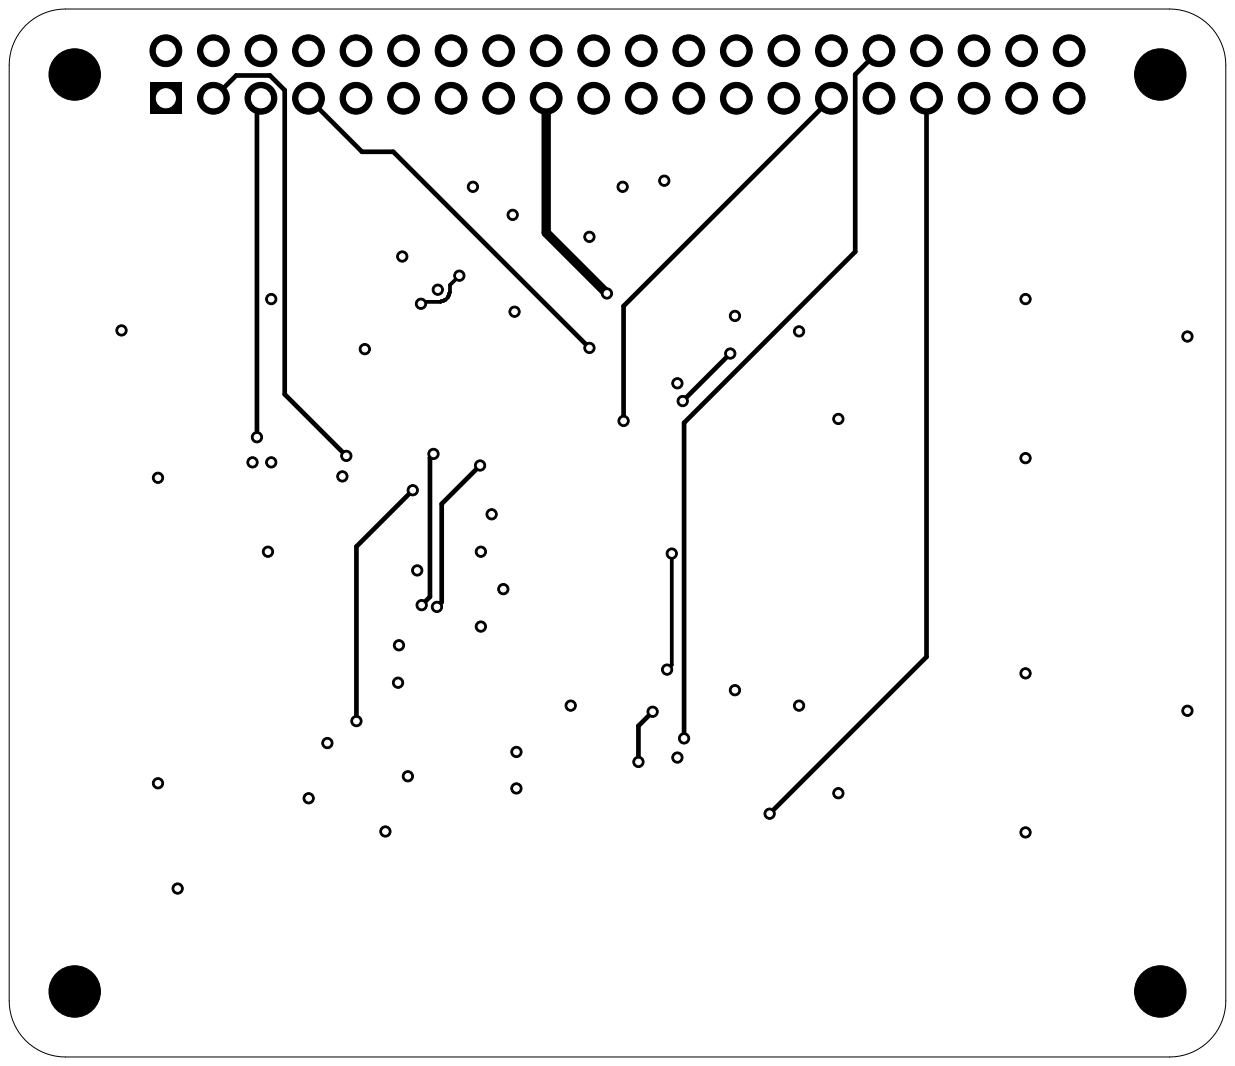
[picture p44: page 4]
