zcrawling/LOONARover/platforms/loonar/hardware/pcb/rbphat-xa-b4/manufacturing/assembly/bottom-assembly.pdf

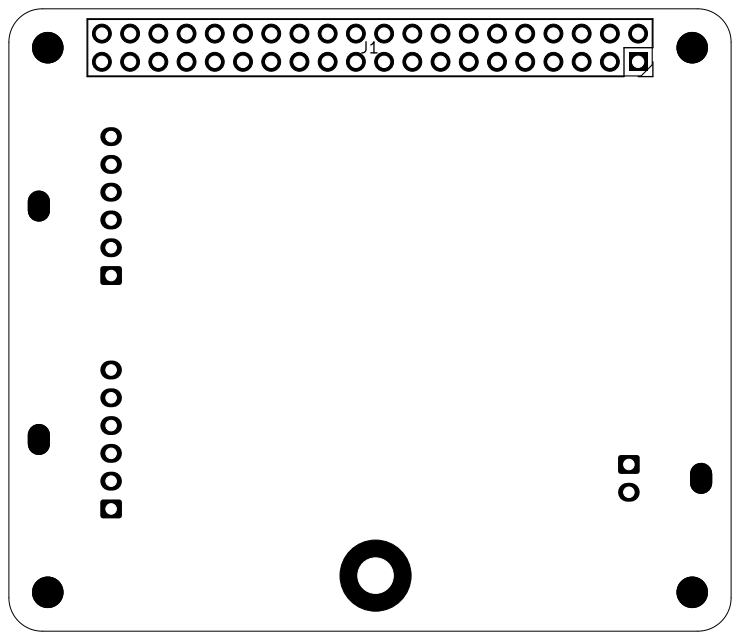
[picture p45: page 1]
