zcrawling/LOONARover/platforms/loonar/hardware/pcb/rbphat-xa-b4/manufacturing/assembly/top-assembly.pdf

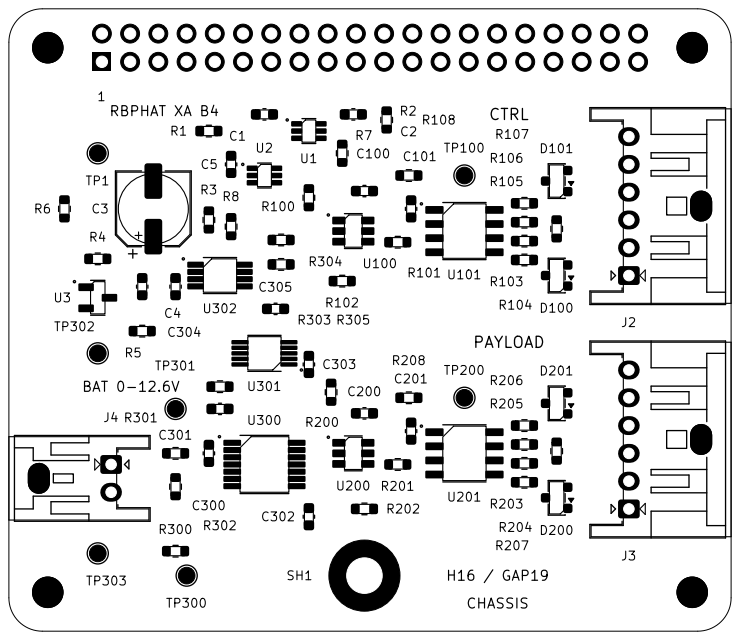
[picture p46: page 1]
