zcrawling/LOONARover/platforms/loonar/hardware/pcb/rbphat-rebuild/rbphat.pdf

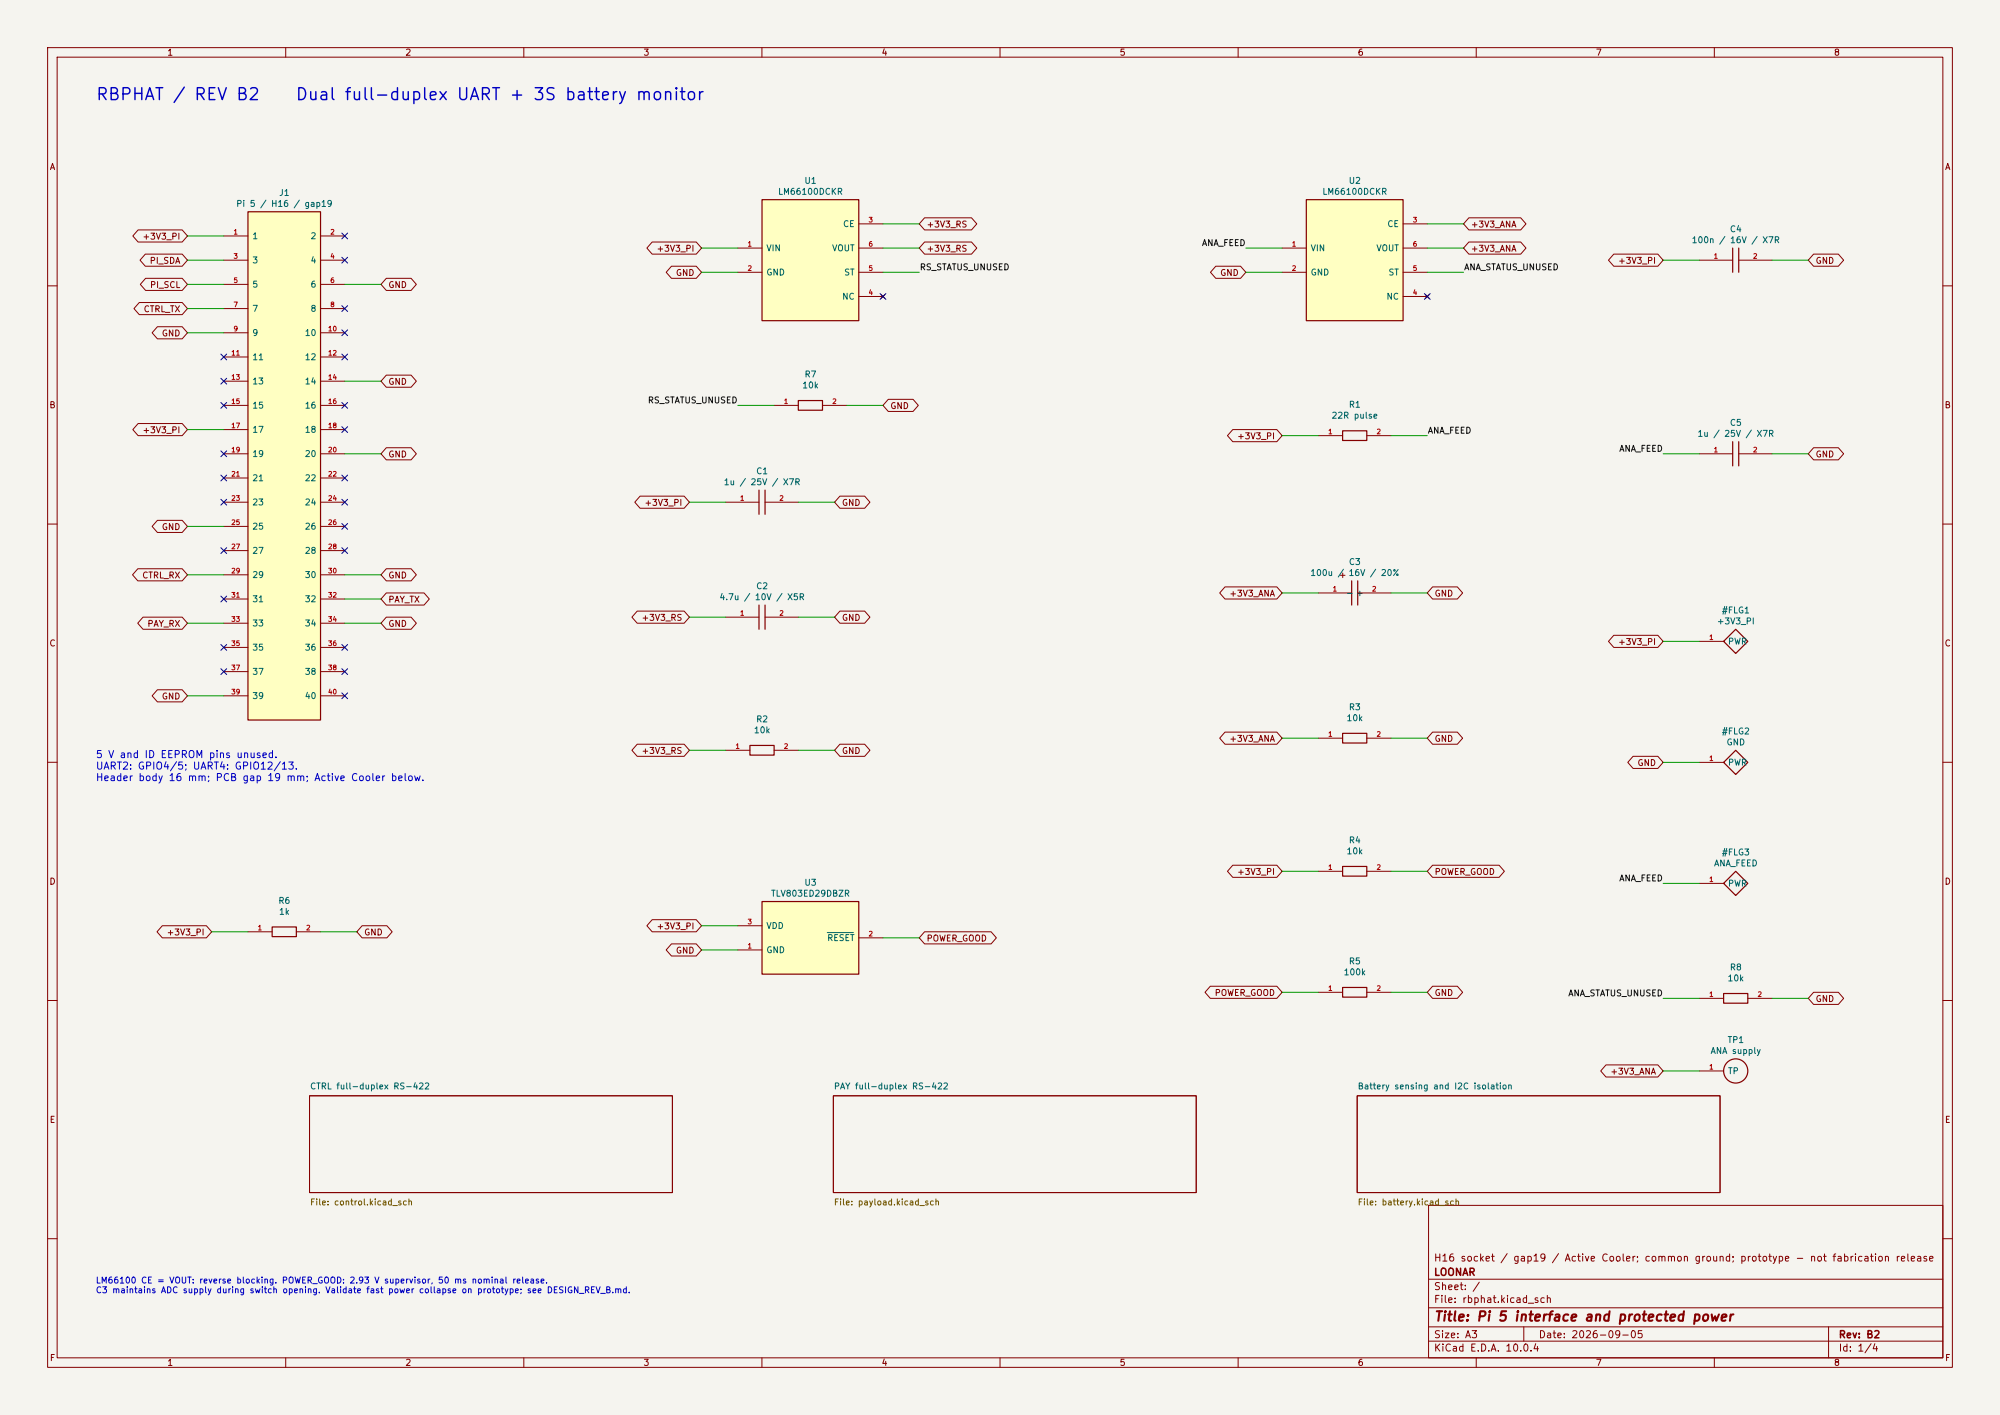
[picture p47: page 1]

5 V and ID EEPROM pins unused.
UART2: GPIO4/5; UART4: GPIO12/13.
Header body 16 mm; PCB gap 19 mm; Active Cooler below.

File: payload.kicad_sch CTRL full-duplex RS-422

PAY full-duplex RS-422

H16 socket / gap19 / Active Cooler; common ground; prototype - not fabrication release
LOONAR
Sheet: /
File: rbphat.kicad_sch
Title: Pi 5 interface and protected power

LM66100 CE = VOUT: reverse blocking. POWER_GOOD: 2.93 V supervisor, 50 ms nominal release. C3 maintains ADC supply during switch opening. Validate fast power collapse on prototype; see DESIGN_REV_B.md.

Size: A3 | Rev: B2
KiCad E.D.A. 10.0.4 | Id: 1/4 | F Date: 2026-09-05

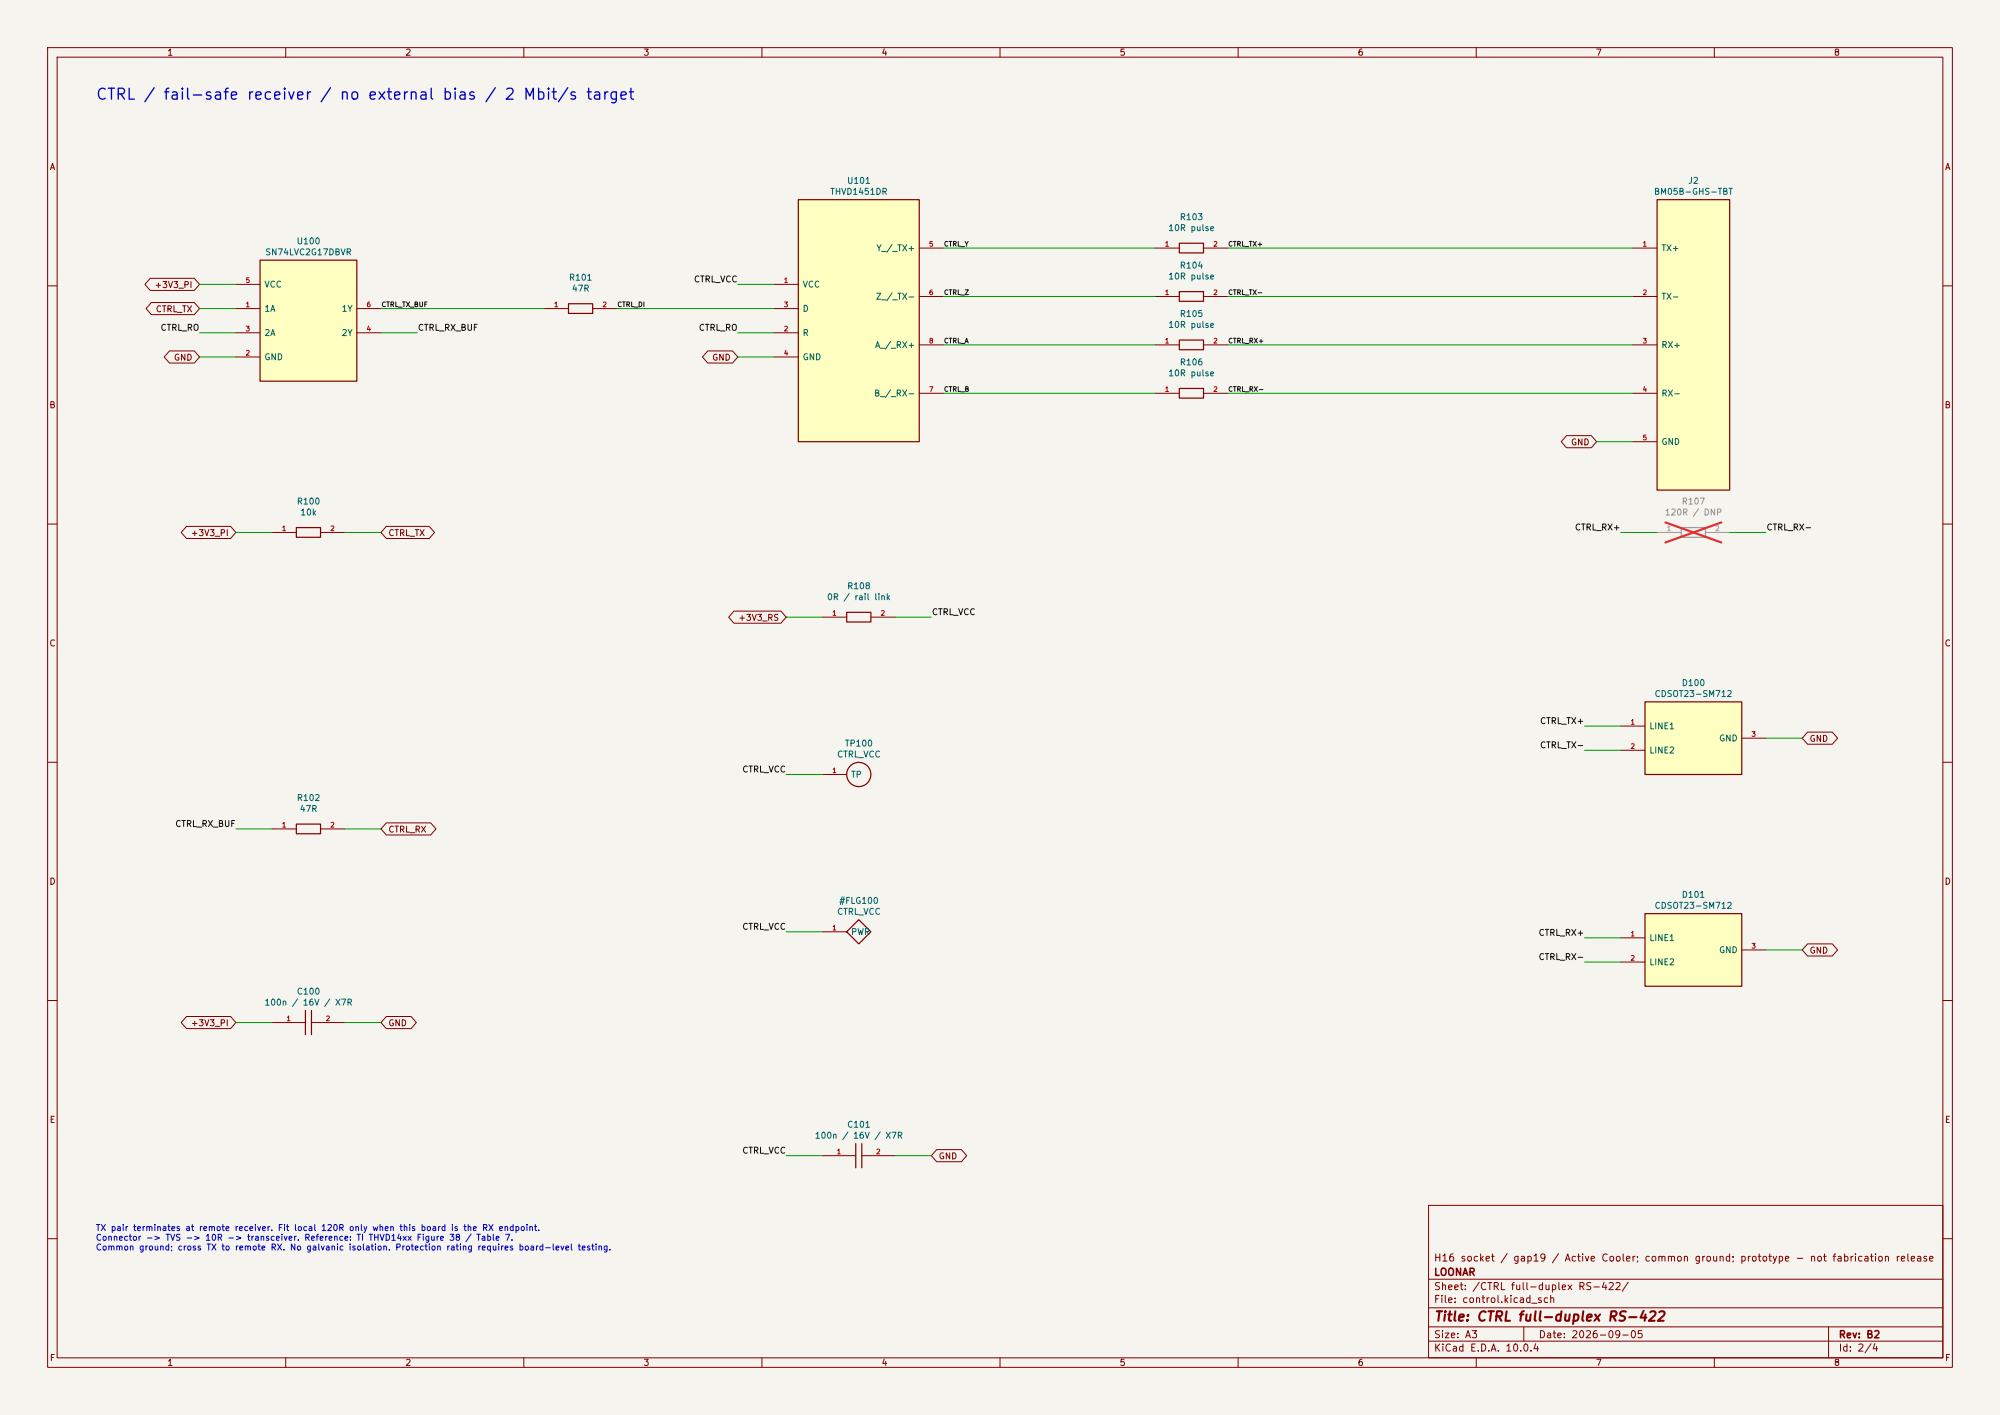
[picture p48: page 2]

CTRL / fail-safe receiver / no external bias / 2 Mbit/s target

TX pair terminates at remote receiver. Fit local 120R only when this board is the RX endpoint. Connector -> TVS -> 10R -> transceiver. Reference: TI THVD14xx Figure 38 / Table 7. Common ground; cross TX to remote RX. No galvanic isolation. Protection rating requires board-level testing.

H16 socket / gap19 / Active Cooler; common ground; prototype - not fabrication release
LOONAR
Sheet: /CTRL full-duplex RS-422/
File: control.kicad_sch
Title: CTRL full-duplex RS-422

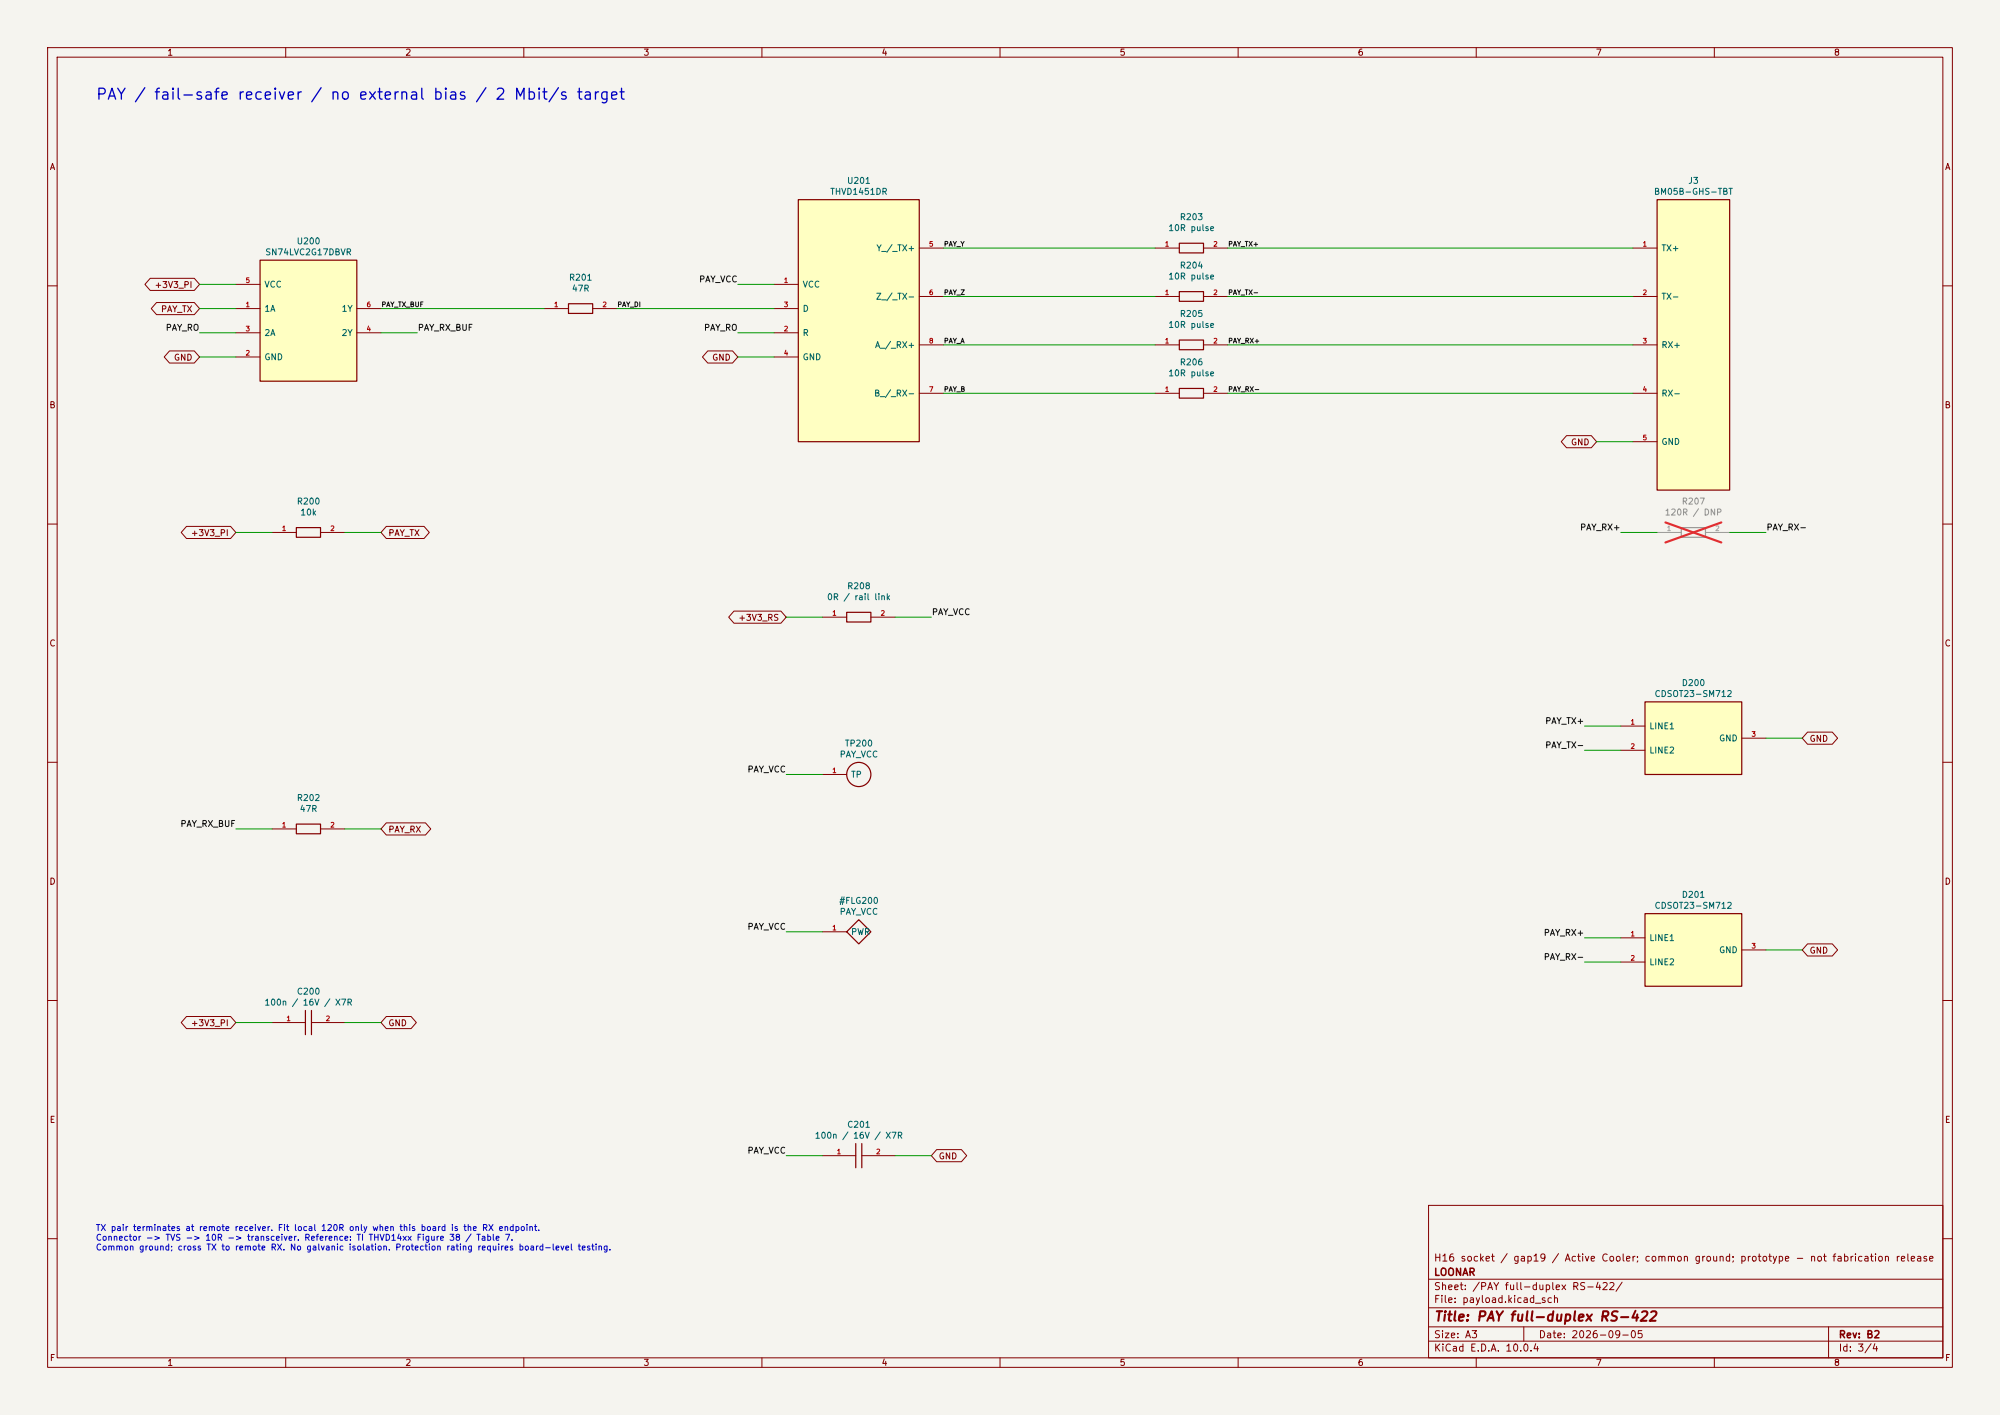
[picture p49: page 3]

PAY / fail-safe receiver / no external bias / 2 Mbit/s target

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

H16 socket / gap19 / Active Cooler; common ground; prototype - not fabrication release
LOONAR
Sheet: /PAY full-duplex RS-422/
File: payload.kicad_sch
Title: PAY full-duplex RS-422

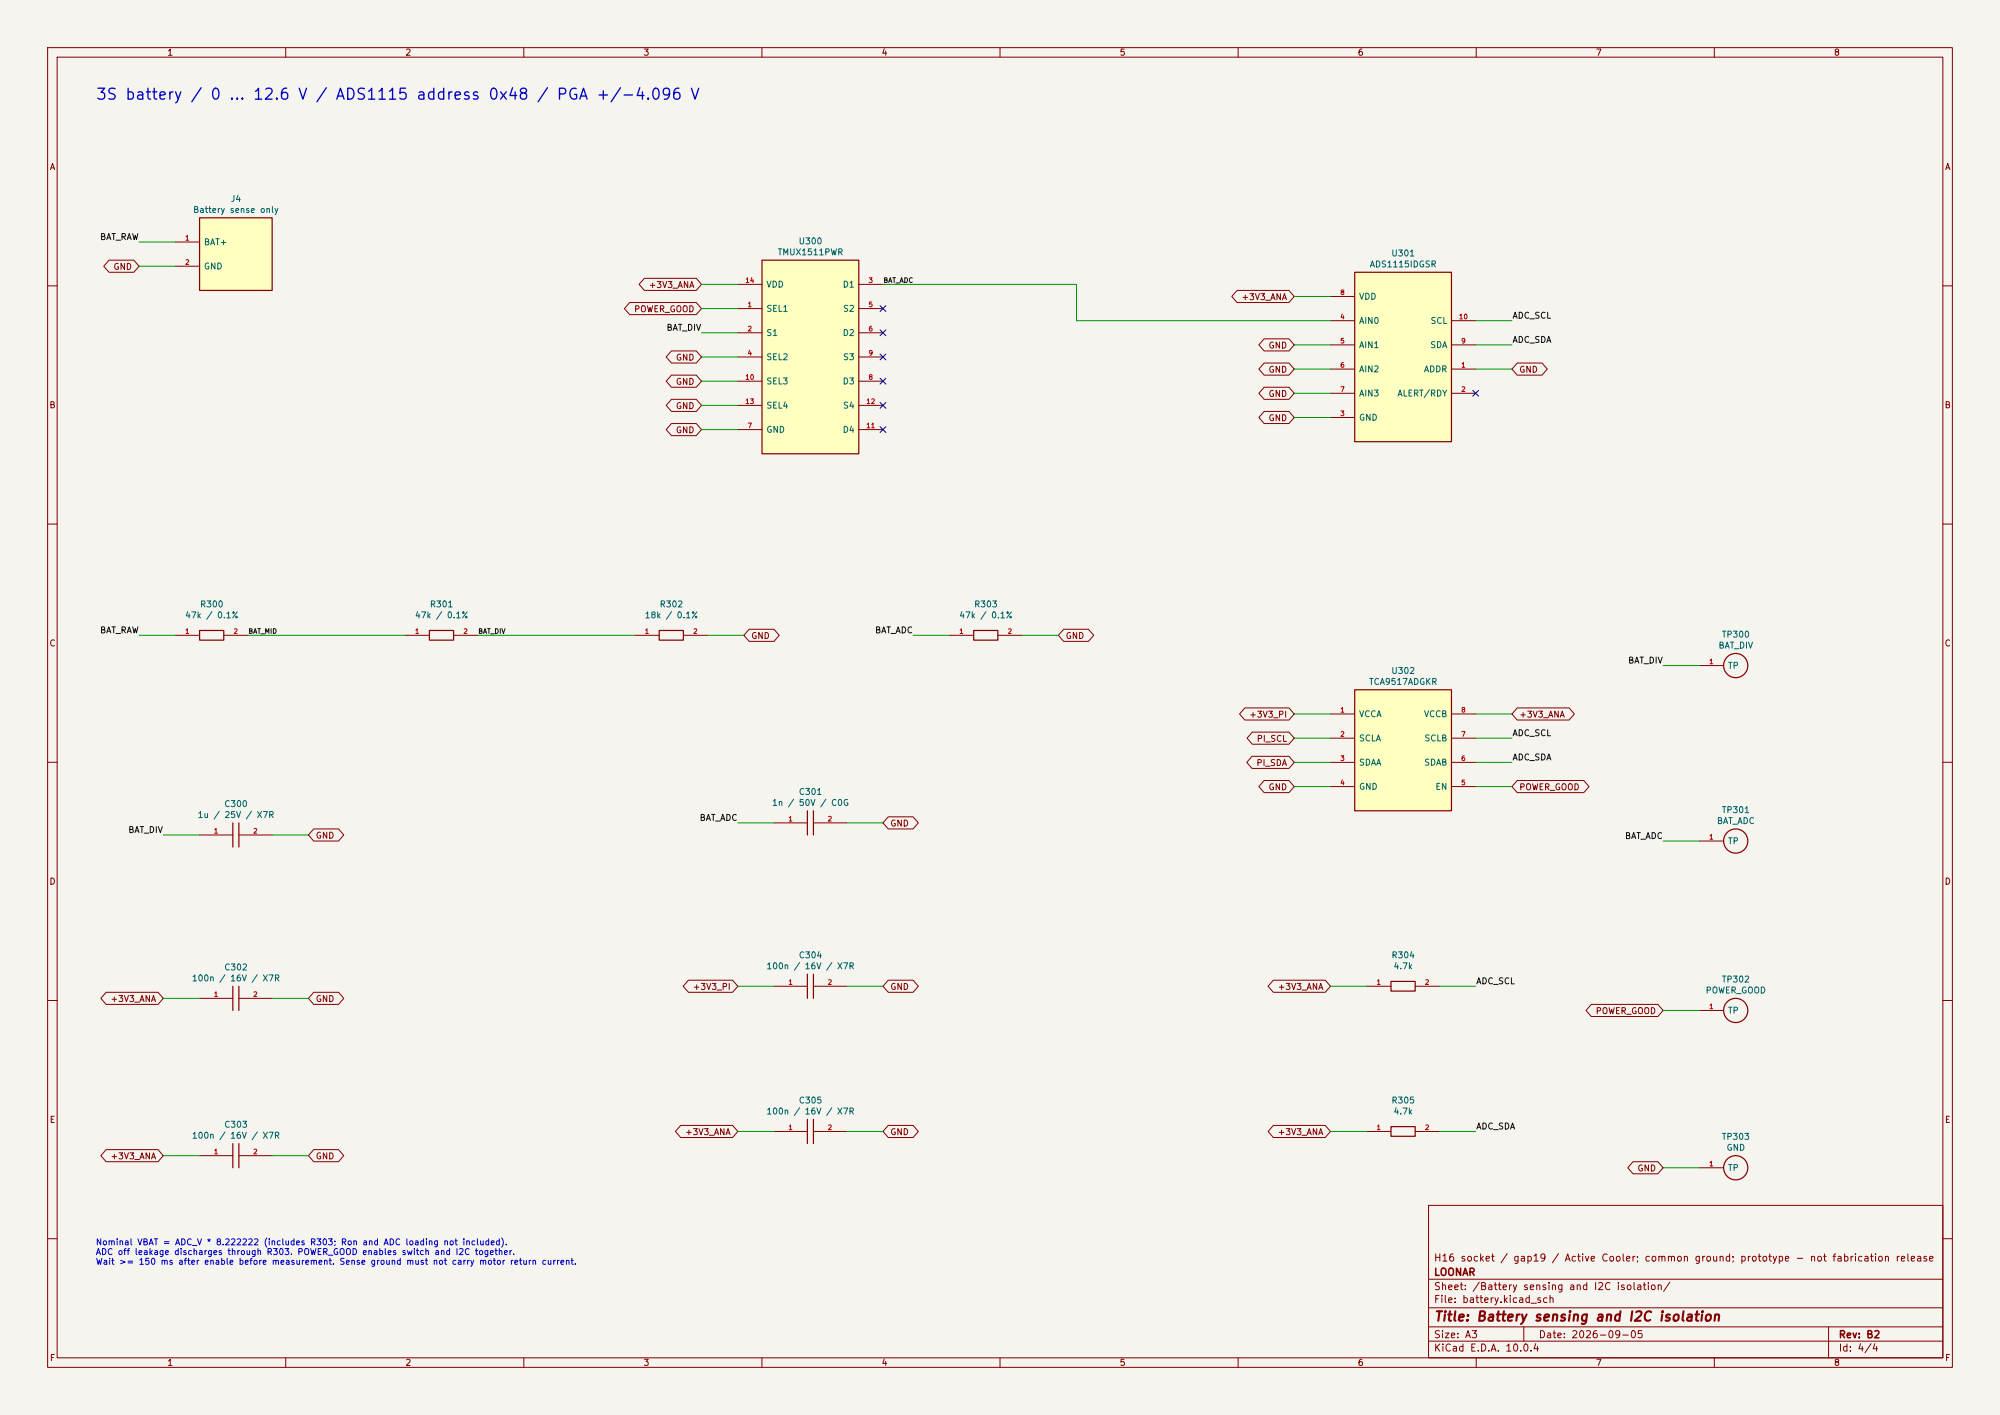
[picture p50: page 4]

Nominal VBAT = ADC_V * 8.222222 (includes R303; Ron and ADC loading not included). ADC off leakage discharges through R303. POWER_GOOD enables switch and I2C together. Wait >= 150 ms after enable before measurement. Sense ground must not carry motor return current.

H16 socket / gap19 / Active Cooler; common ground; prototype - not fabrication release
LOONAR
Sheet: /Battery sensing and I2C isolation/
File: battery.kicad_sch
Title: Battery sensing and I2C isolation
