zcrawling/LOONARover/platforms/loonar/hardware/pcb/rbphat-rebuild/manufacturing/assembly/top-assembly.pdf

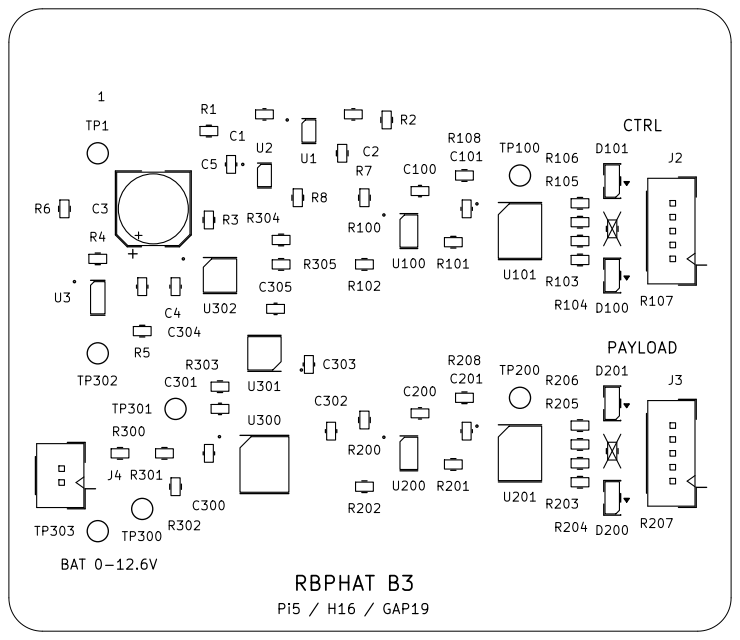
[picture p51: page 1]
