zcrawling/LOONARover/(list of files, drawings)

Other design files:
platforms/loonar/hardware/pcb/rbphat-rebuild/artwork/finish.dsn
platforms/loonar/hardware/pcb/rbphat-rebuild/artwork/placed.dsn
platforms/loonar/hardware/pcb/rbphat-rebuild/artwork/router.dsn
platforms/loonar/hardware/pcb/rbphat-rebuild/artwork/seeded.dsn
platforms/loonar/hardware/pcb/rbphat-xa-b4/artwork/router.dsn
platforms/loonar/hardware/pcb/rbphat-xa-b4/artwork/seeded.dsn
