zcrawling/LOONARover/platforms/loonar/hardware/pcb/261004_pcb/MCU_SENSOR/mcu_sensor.kicad_pcb

## KiCad design platforms/loonar/hardware/pcb/261004_pcb/MCU_SENSOR/mcu_sensor.kicad_pcb (2026-10-06)

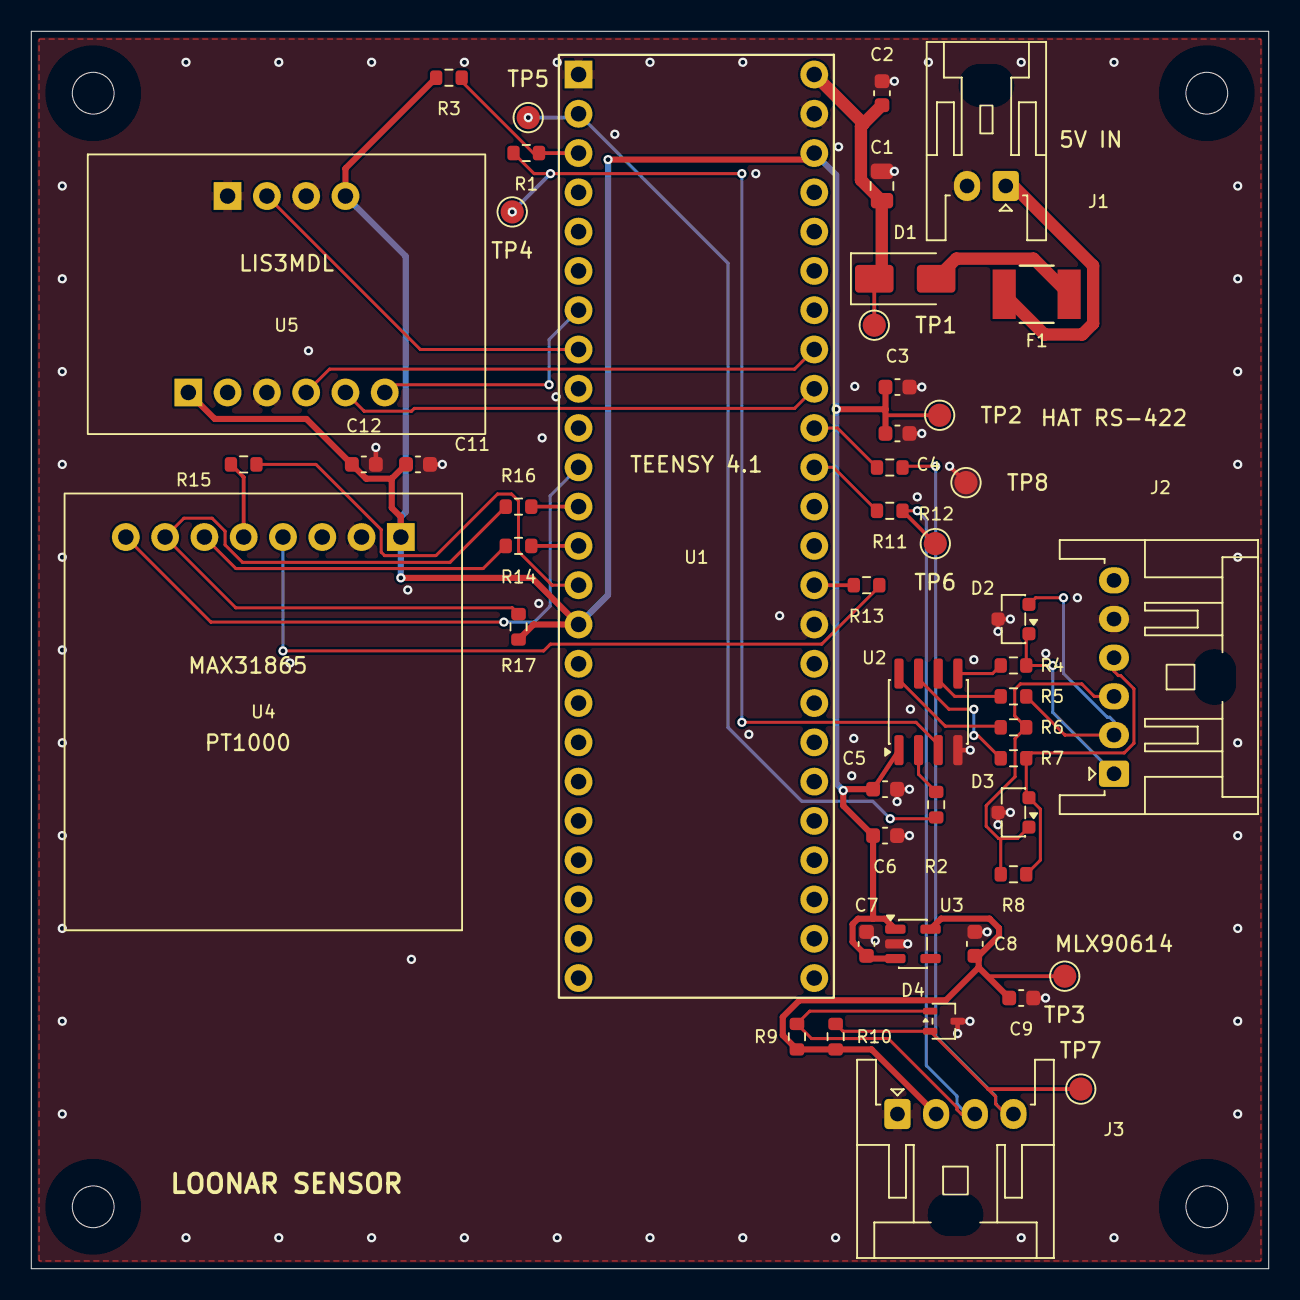
[picture p52: board mcu_sensor.kicad_pcb from above]

Board: 4 copper layers, 80.0 x 80.0 mm, 53 parts (0 on the bottom side), 35 nets.

Parts:
C1: 10uF / 50V / X5R; C_0805_2012Metric
C2, C4, C5, C9, C11: 100nF / 50V / X7R; C_0603_1608Metric
C3: 4.7uF / 16V / X5R; C_0603_1608Metric
C6, C7, C12: 1uF / 25V / X7R; C_0603_1608Metric
C8: 2.2uF / 10V / X7R; C_0603_1608Metric
D1: B340A-13-F / 40V 3A; D_SMA
D2, D3: CDSOT23-SM712; Bourns_CDSOT23_SM712
D4: TPD2E2U06QDCKRQ1; SOT-323_SC-70
F1: PTC / 0.5A hold / 15V; PTC_Bourns_MF_MSMF050_1812
H1, H2, H3, H4: M2.5 / NPTH 2.7mm; MountingHole_2.7mm_M2.5
J1: 5V IN / XA 2P; JST_XA_S02B-XASK-1_1x02_P2.50mm_Horizontal
J2: HAT RS422 / XA 6P; JST_XA_S06B-XASK-1_1x06_P2.50mm_Horizontal
J3: MLX90614 / XA 4P; JST_XA_S04B-XASK-1_1x04_P2.50mm_Horizontal
R1, R2, R11, R12: 47R; R_0603_1608Metric
R3, R17: 10k; R_0603_1608Metric
R4, R5, R6, R7: 10R / 1% / HP pulse; R_0603_1608Metric
R8: 120R; R_0603_1608Metric
R9, R10: 2.2k; R_0603_1608Metric
R13, R14, R15, R16: 33R / 1%; R_0603_1608Metric
TP1: 5V; TestPoint_Pad_D1.5mm
TP2: 3V3; TestPoint_Pad_D1.5mm
TP3: IR3V; TestPoint_Pad_D1.5mm
TP4: TX; TestPoint_Pad_D1.5mm
TP5: RX; TestPoint_Pad_D1.5mm
TP6: SCL; TestPoint_Pad_D1.5mm
TP7: SDA; TestPoint_Pad_D1.5mm
TP8: GND; TestPoint_Pad_D1.5mm
U1: Teensy 4.1; Teensy41_48Pin
U2: THVD1451DR; SOIC-8_3.9x4.9mm_P1.27mm
U3: TLV75730PDBVR / 3.0V; SOT-23-5
U4: MAX31865 / Rref 4.3k; Adafruit_MAX31865_Carrier
U5: LIS3MDL / Adafruit 4479; Adafruit_LIS3MDL_Carrier

Connections:
+3V0_IR: C8.1, C9.1, J3.2, R9.1, R10.1, TP3.1, U3.5 (OUT)
+3V3: C3.1, C4.1, C5.1, C6.1, C7.1, C11.1, C12.1, R3.1, R17.1, TP2.1, U1.3.3V_1 (3.3V), U1.3.3V_2 (3.3V), U2.1 (VCC), U3.1 (IN), U3.3 (EN), U4.JP1_1 (VIN_3.3V), U5.JP1_4 (CS_-_I2C_HIGH), U5.JP4_1 (VIN_3.3V)
+5V_IN: F1.1, J1.1
+5V_MAIN: C1.1, C2.1, D1.1 (K), TP1.1, U1.VIN (VIN_5V)
FUSED_5V: D1.2 (A), F1.2
GND: C1.2, C2.2, C3.2, C4.2, C5.2, C6.2, C7.2, C8.2, C9.2, C11.2, C12.2, D2.3 (GND), D3.3 (GND), D4.3, J1.2, J2.5, J3.1, TP8.1, U1.GND1 (GND), U1.GND2 (GND), U1.GND3 (GND), U2.4 (GND), U3.2 (GND), U4.JP1_2 (GND), U5.JP1_1 (GND), U5.JP1_3 (DO_/_ADDR), U5.JP4_3 (GND)
IR_SCL: D4.1, J3.3, R9.2, R11.2, TP6.1
IR_SCL_MCU: R11.1, U1.16 (A2)
IR_SDA: D4.2, J3.4, R10.2, R12.2, TP7.1
IR_SDA_MCU: R12.1, U1.17 (A3)
LINK_RX_N: D3.2 (LINE2), J2.4, R7.2, R8.2
LINK_RX_P: D3.1 (LINE1), J2.3, R6.2, R8.1
LINK_TX_N: D2.2 (LINE2), J2.2, R5.2
LINK_TX_P: D2.1 (LINE1), J2.1, R4.2
MAG_DRDY: U1.6 (OUT1D), U5.JP1_2 (DRDY)
MAG_INT: U1.5 (IN2), U5.JP4_6 (INT)
MAG_SCL: U1.19 (A5), U5.JP4_4 (SCL)
MAG_SDA: U1.18 (A4), U5.JP4_5 (SDA)
RS_A: R6.1, U2.8 (A)
RS_B: R7.1, U2.7 (B)
RS_DI: R1.2, TP4.1, U2.3 (D)
RS_RO: R2.1, U2.2 (R)
RS_Y: R4.1, U2.5 (Y)
RS_Z: R5.1, U2.6 (Z)
RTD_CS: R16.2, R17.2, U4.JP1_7 (CS)
RTD_CS_MCU: R16.1, U1.10 (CS1)
RTD_MISO: R15.1, U4.JP1_5 (SDO_/_MISO)
RTD_MOSI: R14.2, U4.JP1_6 (SDI_/_MOSI)
RTD_RDY: U1.9 (OUT1C), U4.JP1_8 (RDY)
RTD_SCK: R13.2, U4.JP1_4 (CLK)
SPI_MISO_MCU: R15.2, U1.12 (MISO)
SPI_MOSI_MCU: R14.1, U1.11 (MOSI)
SPI_SCK_MCU: R13.1, U1.13 (SCK)
UART1_RX: R2.2, TP5.1, U1.0 (RX1)
UART1_TX: R1.1, R3.2, U1.1 (TX1)
