zcrawling/LOONARover/platforms/loonar/hardware/pcb/261004_pcb/MCU_MOTOR/mcu_motor.kicad_pcb

## KiCad design platforms/loonar/hardware/pcb/261004_pcb/MCU_MOTOR/mcu_motor.kicad_pcb (2026-10-06)

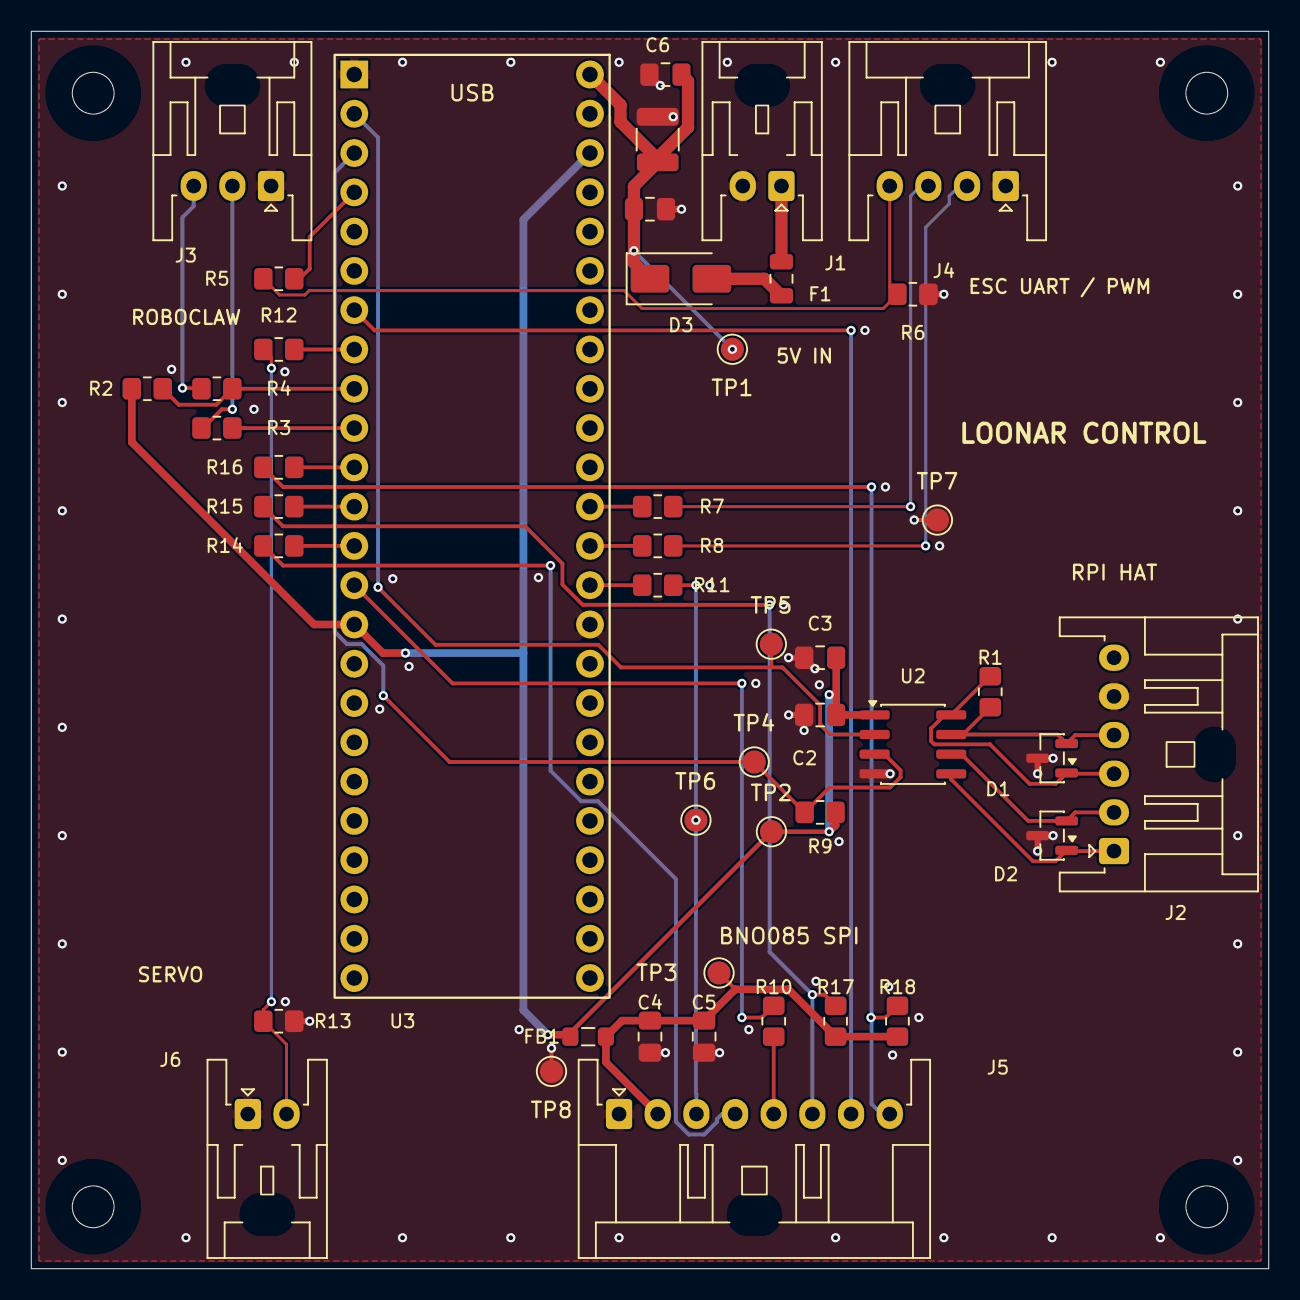
[picture p53: board mcu_motor.kicad_pcb from above]

Board: 4 copper layers, 80.0 x 80.0 mm, 50 parts (0 on the bottom side), 35 nets.

Parts:
C2, C4, C6: 100nF / 50V / X7R; C_0805_2012Metric_Pad1.18x1.45mm_HandSolder
C3, C8: 1uF / 50V / X7R; C_0805_2012Metric_Pad1.18x1.45mm_HandSolder
C5: 4.7uF / 25V / X5R; C_0805_2012Metric_Pad1.18x1.45mm_HandSolder
C7: 47uF / 16V / X5R; C_1210_3225Metric
D1, D2: SM712-02HTG; SOT-23
D3: B340A-13-F / 40V 3A; D_SMA
F1: PTC / 0.75A hold / 6V; Fuse_MF_PSMF_0805
FB1: 220R@100MHz / 2A; L_0805_2012Metric_Pad1.05x1.20mm_HandSolder
H1, H2, H3, H4: M2.5 / NPTH 2.7mm; MountingHole_2.7mm_M2.5
J1: 5V IN / XA 2P; JST_XA_S02B-XASK-1_1x02_P2.50mm_Horizontal
J2: HAT RS422 / XA 6P; JST_XA_S06B-XASK-1_1x06_P2.50mm_Horizontal
J3: RoboClaw UART / XA 3P; JST_XA_S03B-XASK-1_1x03_P2.50mm_Horizontal
J4: ESC UART PWM / XA 4P; JST_XA_S04B-XASK-1_1x04_P2.50mm_Horizontal
J5: BNO085 SPI / XA 8P; JST_XA_S08B-XASK-1_1x08_P2.50mm_Horizontal
J6: TR5 PWM / XA 2P; JST_XA_S02B-XASK-1_1x02_P2.50mm_Horizontal
R1: 120R / 1%; R_0805_2012Metric_Pad1.20x1.40mm_HandSolder
R2: 4.7k / 1%; R_0805_2012Metric_Pad1.20x1.40mm_HandSolder
R3, R4, R5, R7, R8, R12, R16: 100R / 1%; R_0805_2012Metric_Pad1.20x1.40mm_HandSolder
R6, R9, R13, R17, R18: 10k / 1%; R_0805_2012Metric_Pad1.20x1.40mm_HandSolder
R10, R11, R14, R15: 33R / 1%; R_0805_2012Metric_Pad1.20x1.40mm_HandSolder
TP1: 5V; TestPoint_Pad_D1.5mm
TP2: 3V3; TestPoint_Pad_D1.5mm
TP3: IMU3V; TestPoint_Pad_D1.5mm
TP4: TX; TestPoint_Pad_D1.5mm
TP5: RX; TestPoint_Pad_D1.5mm
TP6: SCK; TestPoint_Pad_D1.5mm
TP7, TP8: GND; TestPoint_Pad_D1.5mm
U2: THVD1451DR; SOIC-8_3.9x4.9mm_P1.27mm
U3: Teensy 4.1; Teensy41_48Pin

Connections:
5V_IN: F1.1, J1.1
+3V3: C2.1, C3.1, FB1.1, R2.1, R9.2, TP2.1, U2.1 (VCC), U3.3.3V_1 (3.3V), U3.3.3V_2 (3.3V)
+3V3_IMU: C4.2, C5.2, FB1.2, J5.2, R17.1, R18.1, TP3.1
+5V_MAIN: C6.1, C7.1, C8.1, D3.1 (K), TP1.1, U3.VIN (VIN_5V)
B-G431B RX: J4.2, R8.1
B-G431B TX: J4.3, R7.1
B_G431B PWM: J4.4, R5.1, R6.1
GND: C2.2, C3.2, C4.1, C5.1, C6.2, C7.2, C8.2, D1.3 (common), D2.3 (common), J1.2, J2.5, J3.1, J4.1, J5.1, J6.1, R6.2, R13.2, TP7.1, TP8.1, U2.4 (GND), U3.GND1 (GND), U3.GND2 (GND), U3.GND3 (GND)
IMU_CS: J5.6, R15.1, R17.2
IMU_CS_MCU: R15.2, U3.10 (CS1)
IMU_INT: J5.7, U3.5 (IN2)
IMU_MISO: J5.5, R10.1
IMU_MISO_MCU: R10.2, U3.12 (MISO)
IMU_MOSI: J5.4, R14.1
IMU_MOSI_MCU: R14.2, U3.11 (MOSI)
IMU_RST: J5.8, R16.1, R18.2
IMU_RST_MCU: R16.2, U3.9 (OUT1C)
IMU_SCK: J5.3, R11.1, TP6.1
IMU_SCK_MCU: R11.2, U3.13 (SCK)
unnamed: D3.2 (A), F1.2
RS485_RX+: D1.1 (A1), J2.3, R1.1, U2.8 (A)
RS485_RX-: D1.2 (A2), J2.4, R1.2, U2.7 (B)
RS485_TX+: D2.1 (A1), J2.1, U2.5 (Y)
RS485_TX-: D2.2 (A2), J2.2, U2.6 (Z)
RoboClaw RX: J3.2, R3.1
RoboClaw TX: J3.3, R4.1
SERVO_PWM: J6.2, R12.1, R13.1
SERVO_PWM_MCU: R12.2, U3.6 (OUT1D)
Teensy_Pin2: R5.2, U3.2 (OUT2)
Teensy_RX1: TP5.1, U2.2 (R), U3.0 (RX1)
Teensy_RX2: R2.2, R4.2, U3.7 (RX2)
Teensy_RX3: R7.2, U3.15 (A1)
Teensy_TX1: R9.1, TP4.1, U2.3 (D), U3.1 (TX1)
Teensy_TX2: R3.2, U3.8 (TX2)
Teensy_TX3: R8.2, U3.14 (A0)
