zcrawling/LOONARover/platforms/loonar/hardware/pcb/261004_pcb/RBP/rbphat.kicad_pcb

## KiCad design platforms/loonar/hardware/pcb/261004_pcb/RBP/rbphat.kicad_pcb (2026-10-06)

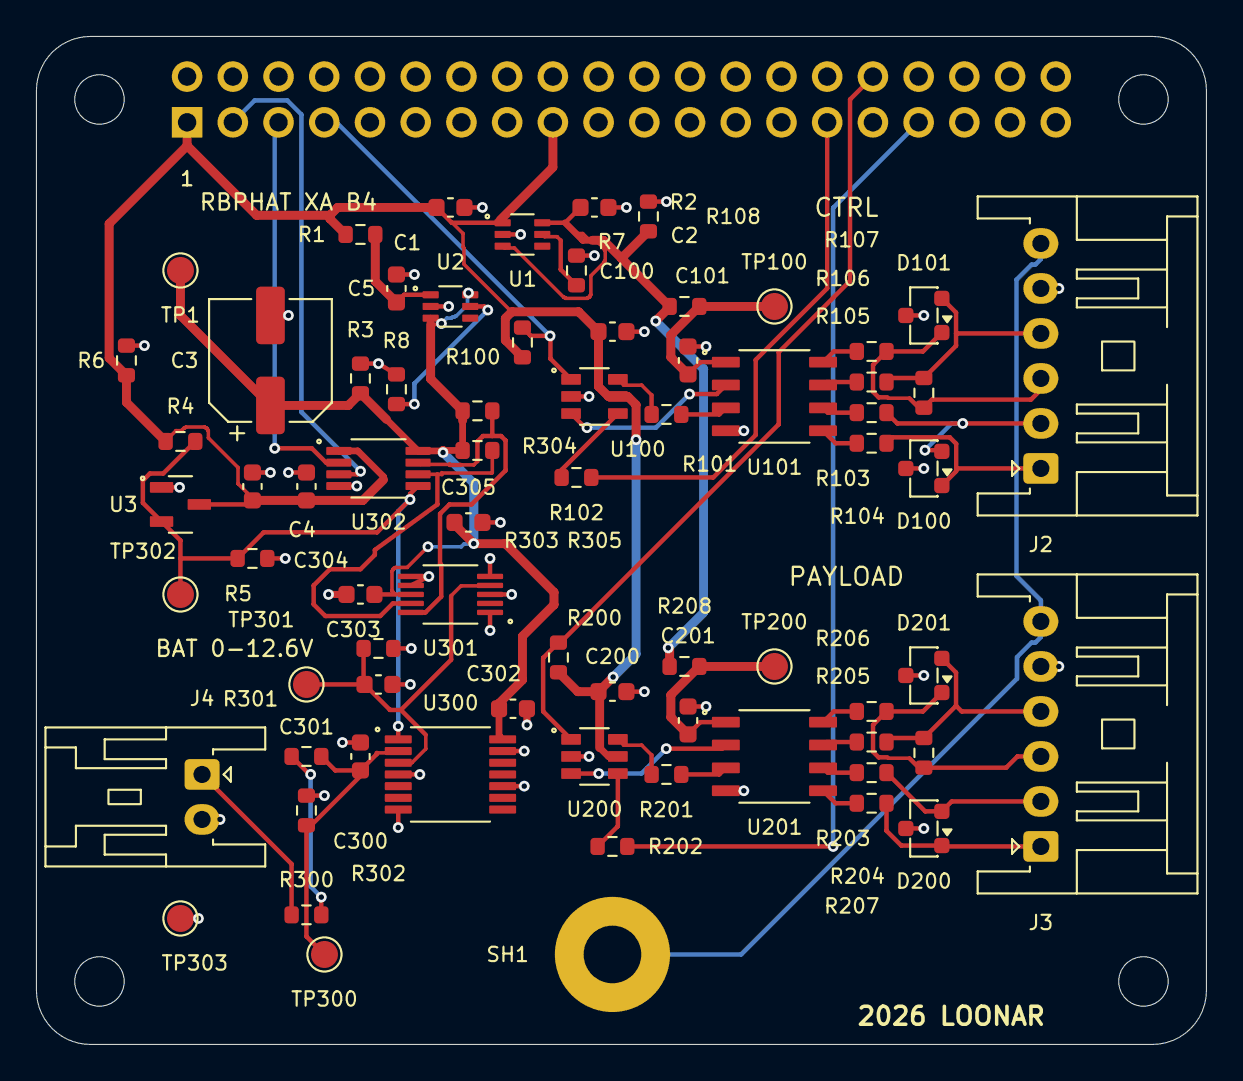
[picture p54: board rbphat.kicad_pcb from above]

Board: 4 copper layers, 65.0 x 56.0 mm, 77 parts (1 on the bottom side), 47 nets.

Parts:
C1, C5, C300: 1uF / 25V / X7R; Capacitor_SMD_C_0603_1608Metric
C2: 4.7uF / 16V / X5R; Capacitor_SMD_C_0603_1608Metric
C3: 100uF / 16V / polarized; Panasonic_FK_D_6.3x5.8
C4, C100, C101, C200, C201, C302, C303, C304, C305: 100nF / 50V / X7R; Capacitor_SMD_C_0603_1608Metric
C301: 1nF / 50V / C0G; Capacitor_SMD_C_0603_1608Metric
D100, D101, D200, D201: CDSOT23-SM712; Bourns_CDSOT23_SM712
H1, H2, H3, H4: M2.5 / NPTH 2.75mm
J1: Raspberry Pi GPIO / 2x20; GPIO_2x20_H16_Drill1.02
J2: CTRL RS422 / XA 6P; XA_S06B_Horizontal
J3: PAYLOAD RS422 / XA 6P; XA_S06B_Horizontal
J4: BAT 0-12.6V / XA 2P; XA_S02B_Horizontal
R1: 22R / 1% / HP pulse; Resistor_SMD_R_0603_1608Metric
R2, R3, R4, R7, R8, R100, R200: 10k; Resistor_SMD_R_0603_1608Metric
R5: 100k; Resistor_SMD_R_0603_1608Metric
R6: 1k; Resistor_SMD_R_0603_1608Metric
R101, R102, R201, R202: 47R; Resistor_SMD_R_0603_1608Metric
R103, R104, R105, R106, R203, R204, R205, R206: 10R / 1% / HP pulse; Resistor_SMD_R_0603_1608Metric
R107, R207: 120R; Resistor_SMD_R_0603_1608Metric
R108, R208: 0R; Resistor_SMD_R_0603_1608Metric
R300, R301, R303: 47k / 0.1%; Resistor_SMD_R_0603_1608Metric
R302: 18k / 0.1%; Resistor_SMD_R_0603_1608Metric
R304, R305: 4.7k; Resistor_SMD_R_0603_1608Metric
SH1: CHASSIS / M3 ring terminal; Chassis_M3_Plated
TP1: ANA supply; TestPoint_TestPoint_Pad_D1.5mm
TP100: CTRL_VCC; TestPoint_TestPoint_Pad_D1.5mm
TP200: PAY_VCC; TestPoint_TestPoint_Pad_D1.5mm
TP300: BAT_DIV; TestPoint_TestPoint_Pad_D1.5mm
TP301: BAT_ADC; TestPoint_TestPoint_Pad_D1.5mm
TP302: POWER_GOOD; TestPoint_TestPoint_Pad_D1.5mm
TP303: GND; TestPoint_TestPoint_Pad_D1.5mm
U1, U2: LM66100DCKR; TI_DCK0006A
U3: TLV803ED29DBZR; TI_DBZ0003A
U100, U200: SN74LVC2G17DBVT; TI_DBV0006A
U101, U201: THVD1451DR; TI_D0008A
U300: TMUX1511PWR; TI_PW0014A
U301: ADS1115IDGSR; TI_DGS0010A
U302: TCA9517ADGKR; TI_DGK0008A

Connections:
+3V3_ANA: C3.1, C302.1, C303.1, C305.1, R3.1, R304.1, R305.1, TP1.1, U2.3, U2.6, U300.14, U301.8, U302.8
+3V3_PI: C1.1, C4.1, C100.1, C200.1, C304.1, J1.1, J1.17, R1.1, R4.1, R6.1, R100.1, R200.1, U1.1, U3.3, U100.5, U200.5, U302.1
+3V3_RS: C2.1, R2.1, R108.1, R208.1, U1.3, U1.6
/ANA_FEED: C5.1, R1.2, U2.1
/ANA_STATUS_UNUSED: R8.1, U2.5
/Battery sensing and I2C isolation/ADC_SCL: R304.2, U301.10, U302.7
/Battery sensing and I2C isolation/ADC_SDA: R305.2, U301.9, U302.6
/Battery sensing and I2C isolation/BAT_ADC: C301.1, R303.1, TP301.1, U300.3, U301.4
/Battery sensing and I2C isolation/BAT_DIV: C300.1, R301.2, R302.1, TP300.1, U300.2
/Battery sensing and I2C isolation/BAT_MID: R300.2, R301.1
/Battery sensing and I2C isolation/BAT_RAW: J4.1, R300.1
/CTRL full-duplex RS-422/CTRL_A: R105.1, U101.8
/CTRL full-duplex RS-422/CTRL_B: R106.1, U101.7
/CTRL full-duplex RS-422/CTRL_DI: R101.2, U101.3
/CTRL full-duplex RS-422/CTRL_RO: U100.3, U101.2
/CTRL full-duplex RS-422/CTRL_RX+: D101.1, J2.3, R105.2, R107.1
/CTRL full-duplex RS-422/CTRL_RX-: D101.2, J2.4, R106.2, R107.2
/CTRL full-duplex RS-422/CTRL_RX_BUF: R102.1, U100.4
/CTRL full-duplex RS-422/CTRL_TX+: D100.1, J2.1, R103.2
/CTRL full-duplex RS-422/CTRL_TX-: D100.2, J2.2, R104.2
/CTRL full-duplex RS-422/CTRL_TX_BUF: R101.1, U100.6
/CTRL full-duplex RS-422/CTRL_VCC: C101.1, R108.2, TP100.1, U101.1
/CTRL full-duplex RS-422/CTRL_Y: R103.1, U101.5
/CTRL full-duplex RS-422/CTRL_Z: R104.1, U101.6
/PAY full-duplex RS-422/PAY_A: R205.1, U201.8
/PAY full-duplex RS-422/PAY_B: R206.1, U201.7
/PAY full-duplex RS-422/PAY_DI: R201.2, U201.3
/PAY full-duplex RS-422/PAY_RO: U200.3, U201.2
/PAY full-duplex RS-422/PAY_RX+: D201.1, J3.3, R205.2, R207.1
/PAY full-duplex RS-422/PAY_RX-: D201.2, J3.4, R206.2, R207.2
/PAY full-duplex RS-422/PAY_RX_BUF: R202.1, U200.4
/PAY full-duplex RS-422/PAY_TX+: D200.1, J3.1, R203.2
/PAY full-duplex RS-422/PAY_TX-: D200.2, J3.2, R204.2
/PAY full-duplex RS-422/PAY_TX_BUF: R201.1, U200.6
/PAY full-duplex RS-422/PAY_VCC: C201.1, R208.2, TP200.1, U201.1
/PAY full-duplex RS-422/PAY_Y: R203.1, U201.5
/PAY full-duplex RS-422/PAY_Z: R204.1, U201.6
/RS_STATUS_UNUSED: R7.1, U1.5
CHASSIS: J2.6, J3.6, SH1.1
CTRL_RX: J1.29, R102.2
CTRL_TX: J1.7, R100.2, U100.1
GND: C1.2, C2.2, C3.2, C4.2, C5.2, C100.2, C101.2, C200.2, C201.2, C300.2, C301.2, C302.2, C303.2, C304.2, C305.2, D100.3, D101.3, D200.3, D201.3, J1.6, J1.9, J1.14, J1.20, J1.25, J1.30, J1.34, J1.39, J2.5, J3.5, J4.2, R2.2, R3.2, R5.2, R6.2, R7.2, R8.2, R302.2, R303.2, TP303.1, U1.2, U2.2, U3.1, U100.2, U101.4, U200.2, U201.4, U300.4, U300.7, U300.10, U300.13, U301.1, U301.3, U301.5, U301.6, U301.7, U302.4
PAY_RX: J1.33, R202.2
PAY_TX: J1.32, R200.2, U200.1
PI_SCL: J1.5, U302.2
PI_SDA: J1.3, U302.3
POWER_GOOD: R4.2, R5.1, TP302.1, U3.2, U300.1, U302.5
