zcrawling/LOONARover/data/limo/odom_tests/20260905_153551_forward_2m_02/trial.yaml

name: forward_2m_02
requested_linear_mps: 0.25
requested_angular_radps: 0.0
requested_duration_s: 8
started_utc: 2026-09-05T07:35:54+00:00
actual_distance_m: 2.18
actual_lateral_offset_m: 0.03
actual_heading_error_deg: tbd
surface:
notes:
command_start_utc: 2026-09-05T07:35:55+00:00
command_stop_utc: 2026-09-05T07:36:04+00:00
