zcrawling/LOONARover/data/limo/odom_tests/20260905_160739_205093_reverse_2m_01/trial.yaml

name: reverse_2m_01
requested_linear_mps: -0.1
requested_angular_radps: 0.0
requested_duration_s: 20.0
actual_distance_m: 2.01
actual_heading_error_deg: 0
status: completed
ros_domain_id: '0'
command_start_ros_ns: 1788595662234588022
command_stop_ros_ns: 1788595682234841028
actual_command_duration_s: 20.000278145000266
bag_exit_code: 0
