zcrawling/LOONARover/(commit log)

2026-08-24 문서 다이어트
    [rbphat.kicad_sch, rbphat.sch, rbphat_battery_sense1.kicad_sch, rbphat_pi_header1.kicad_sch, rbphat_rs422_channel1.kicad_sch, rbphat_rs422_channel2.kicad_sch]
2026-09-03 make vehicle gateway
    [rbphat.kicad_sch, rbphat.sch, rbphat_battery_sense1.kicad_sch, rbphat_pi_header1.kicad_sch, rbphat_rs422_channel1.kicad_sch, rbphat_rs422_channel2.kicad_sch]
2026-09-06 add test data and rbp hat pcb
    [Capacitor_SMD.3dshapes_CP_Elec_6.3x5.8.step, Capacitor_SMD.3dshapes_C_0603_1608Metric.step, Connector_JST.3dshapes_JST_GH_BM02B-GHS-TBT_1x02-1MP_P1.25mm_Vertical.step, Connector_JST.3dshapes_JST_GH_BM05B-GHS-TBT_1x05-1MP_P1.25mm_Vertical.step, Package_SO.3dshapes_MSOP-10_3x3mm_P0.5mm.step, Package_SO.3dshapes_SOIC-8_3.9x4.9mm_P1.27mm.step, Package_SO.3dshapes_TSSOP-14_4.4x5mm_P0.65mm.step, Packag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]
2026-09-06 delte old pcbs
    [rbphat.kicad_sch]
2026-09-09 add IMU-vibrate data based EKF scale regression code and its data
    [run_odom_motion_test.py]
2026-09-09 erase pcb.zip
2026-09-18 payload code add
    [Capacitor_SMD.3dshapes_CP_Elec_6.3x5.8.step, Capacitor_SMD.3dshapes_C_0603_1608Metric.step, Connector_JST.3dshapes_JST_GH_BM02B-GHS-TBT_1x02-1MP_P1.25mm_Vertical.step, Connector_JST.3dshapes_JST_GH_BM05B-GHS-TBT_1x05-1MP_P1.25mm_Vertical.step, Package_SO.3dshapes_MSOP-10_3x3mm_P0.5mm.step, Package_SO.3dshapes_SOIC-8_3.9x4.9mm_P1.27mm.step, Package_SO.3dshapes_TSSOP-14_4.4x5mm_P0.65mm.step, Packag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]
2026-09-18 Preserve local rover development and revise Pi payload porting plan
    Include the local cFS/GCS harness, localization and ToF experiments, AprilTag tooling, and B4 hardware work. Document the actual payload boundary and independent transport acceptance gates. Preserve the external CubeEye SDK locally with a checksum manifest, fix report-test dependencies and discovery, and exclude editor state and duplicate archives.
    [Capacitor_SMD.3dshapes_CP_Elec_6.3x5.8.step, Capacitor_SMD.3dshapes_C_0603_1608Metric.step, Connector_JST.3dshapes_JST_GH_BM02B-GHS-TBT_1x02-1MP_P1.25mm_Vertical.step, Connector_JST.3dshapes_JST_GH_BM05B-GHS-TBT_1x05-1MP_P1.25mm_Vertical.step, Package_SO.3dshapes_MSOP-10_3x3mm_P0.5mm.step, Package_SO.3dshapes_SOIC-8_3.9x4.9mm_P1.27mm.step, Package_SO.3dshapes_TSSOP-14_4.4x5mm_P0.65mm.step, Packag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]
2026-09-18 Prepare Pi Jazzy deployment and USB Teensy build without hardware tests
2026-09-19 Build real-rover GCS and diagnostics
    [LOONAR_GCS_요구사항.xlsx]
2026-10-05 Fix GCS startup and align payload firmware and launcher with sensor PCB
2026-10-12 payload PCB pinmap
2026-10-16 add Reaction-wheel support
2026-10-16 Start Pi NCNN detection with the default GCS camera stack
2026-10-19 Fit bench PCA parameters from sensor-test logs
