zcrawling/LOONARover/(notices)

Notices in the files:
platforms/loonar/hardware/pcb/rbphat-xa-b4/models/Capacitor_SMD.3dshapes_CP_Elec_6.3x5.8.step:
Copyright (C) 2018, kicad StepUp
This work is licensed under the [Creative Commons CC-BY-SA 4.0 License](https://creativecommons.org/licenses/by-sa/4.0/legalcode),
with the following exception:
To the extent that the creation of electronic designs that use 'Licensed Material' can be considered to be 'Adapted Material',
You are free to use the library data in your own projects without the obligation to share your project files under this or any other license agreement.
platforms/loonar/hardware/pcb/rbphat-xa-b4/models/Capacitor_SMD.3dshapes_C_0603_1608Metric.step:
Copyright (C) 2017, kicad StepUp
platforms/loonar/hardware/pcb/rbphat-xa-b4/models/Connector_JST.3dshapes_JST_GH_BM02B-GHS-TBT_1x02-1MP_P1.25mm_Vertical.step:
Copyright (C) 2018, Frank Severinsen
platforms/loonar/hardware/pcb/rbphat-xa-b4/models/Package_TO_SOT_SMD.3dshapes_SOT-23-6.step:
Copyright (C) 2025, KiCAD
This work is licensed under the
[Creative Commons CC-BY-SA 4.0 License](https://creativecommons.org/licenses/by-sa/4.0/legalcode),
project files under this or any other license agreement. However, if you wish to distribute
platforms/loonar/hardware/pcb/rbphat-xa-b4/models/Package_SO.3dshapes_MSOP-10_3x3mm_P0.5mm.step:
Copyright (C) 2026, KiCAD
